wuyangtech/MIAT_C3X25/Docs/signaltap.pdf

CSIE MIAT Lab.

National Central University

# Simple SignalTapII Starter Guide

MIAT-C3X FPGA Development Board

# 浯陽科技有限公司

# Open SignalTapII

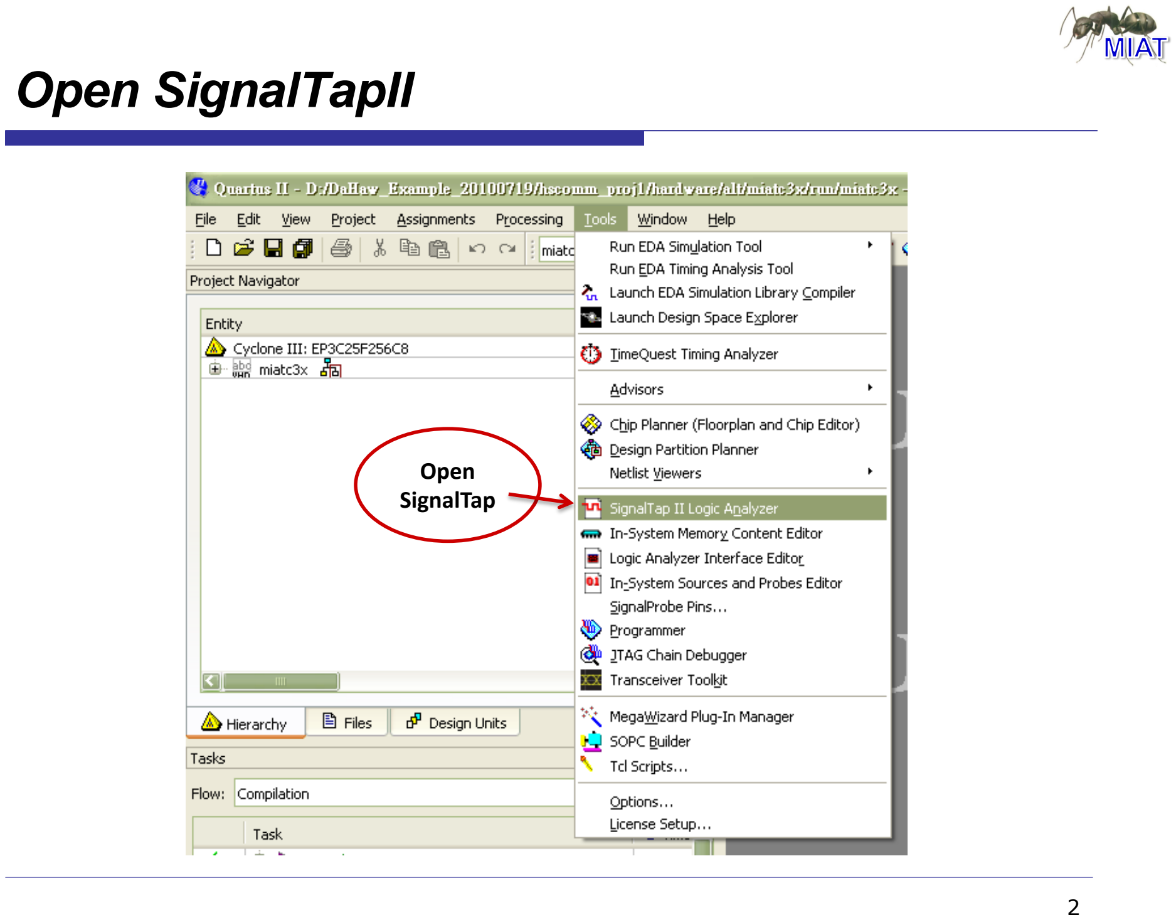
[picture p1: page 2]

Open
SignalTap

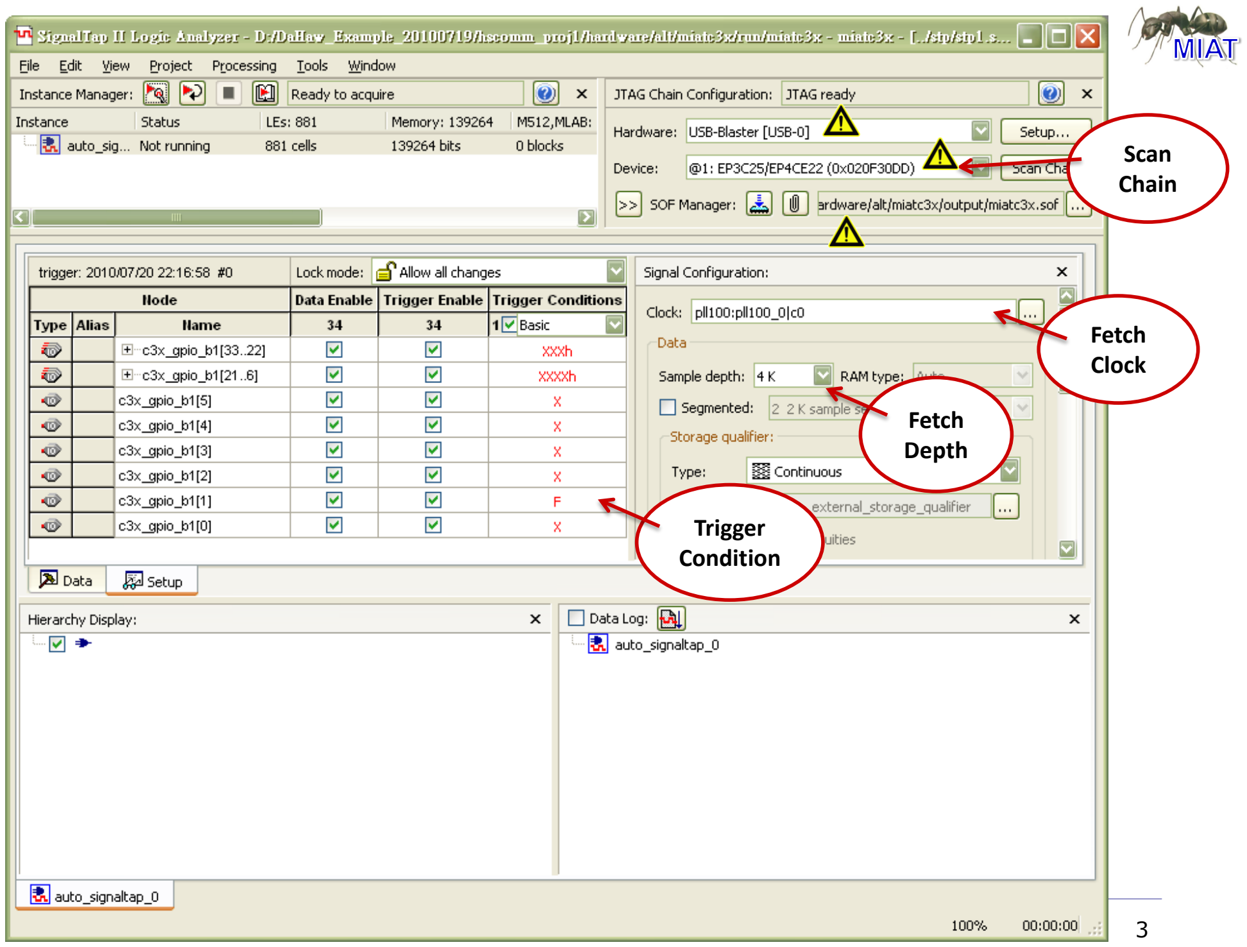
[picture p2: page 3]

Fetch
Clock

Fetch
Depth

Trigger
Condition

Scan
Chain

# Add Target Signals

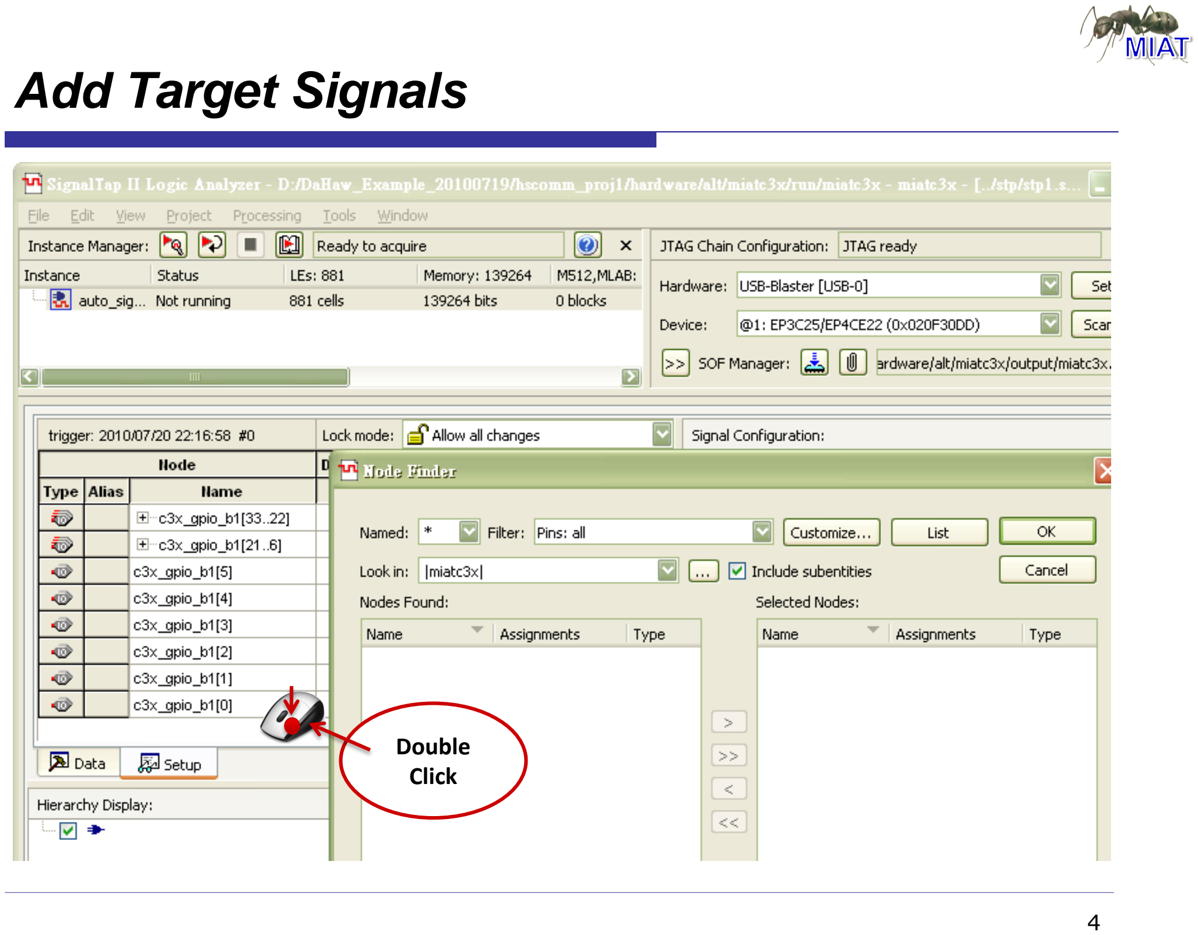
[picture p3: page 4]

Double
Click

# Note
