wuyangtech/MIAT_C3X25/Examples/HW_SW_Integration/shw_communication.pdf

CSIE MIAT Lab.

National Central University

# Day 5

# Hardware and Software Integration

MIAT-C3X FPGA Development Board

### 姚敦凱

965402013@cc.ncu.edu.tw

# 浯陽科技有限公司

# Outline

☐ | Part I
■ | High Efficiency Communication
☐ | Part II
■ | Software and Hardware Integration

# HIGH EFFICIENCY COMMUNICATION

## Part I

# Design Consideration

☐ | MIAT-STM32F103 communicate with MIAT-C3X
■ | Protocols
☐ | UART
☐ | I

2C
☐ | SPI
☐ | SDIO
☐ | GPIO
■ | FSMC Interface
☐ | (72Mhz*32-bit) / 11-Cycle
☐ | 209.45 Mbps

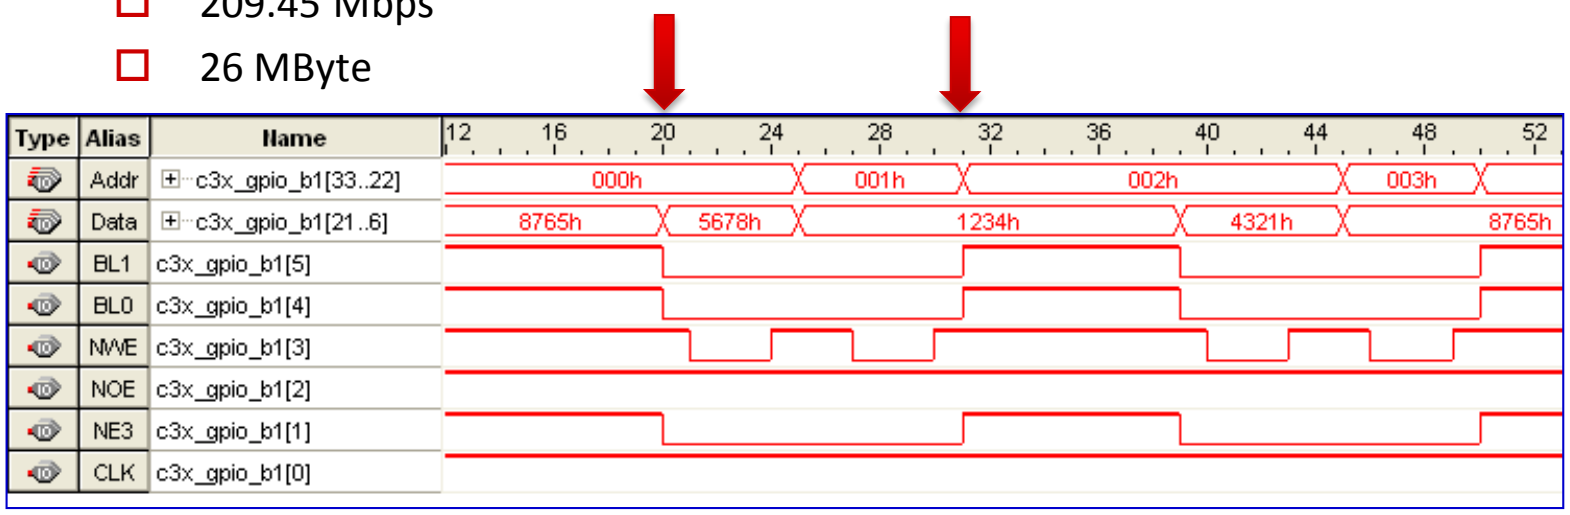
[picture p4: figure]
26 MByte

# FSMC Interface

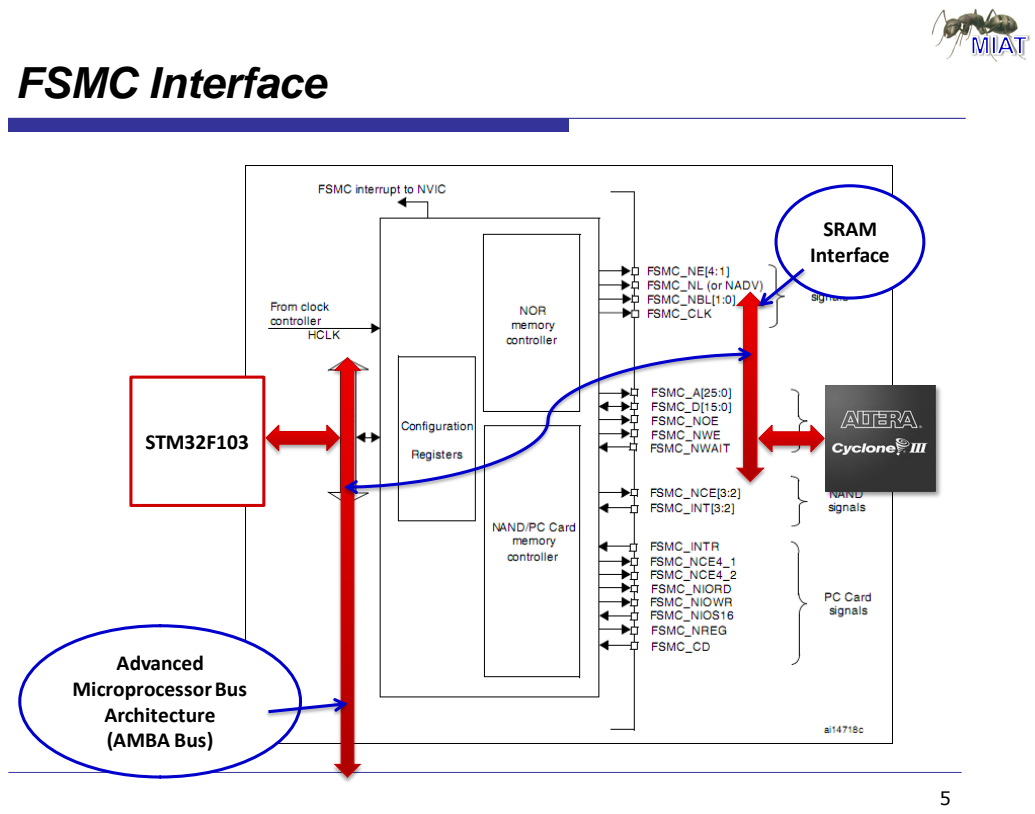
[picture p5: page 5]
STM32F103; Advanced Microprocessor Bus Architecture (AMBA Bus); SRAM Interface

# System Diagram

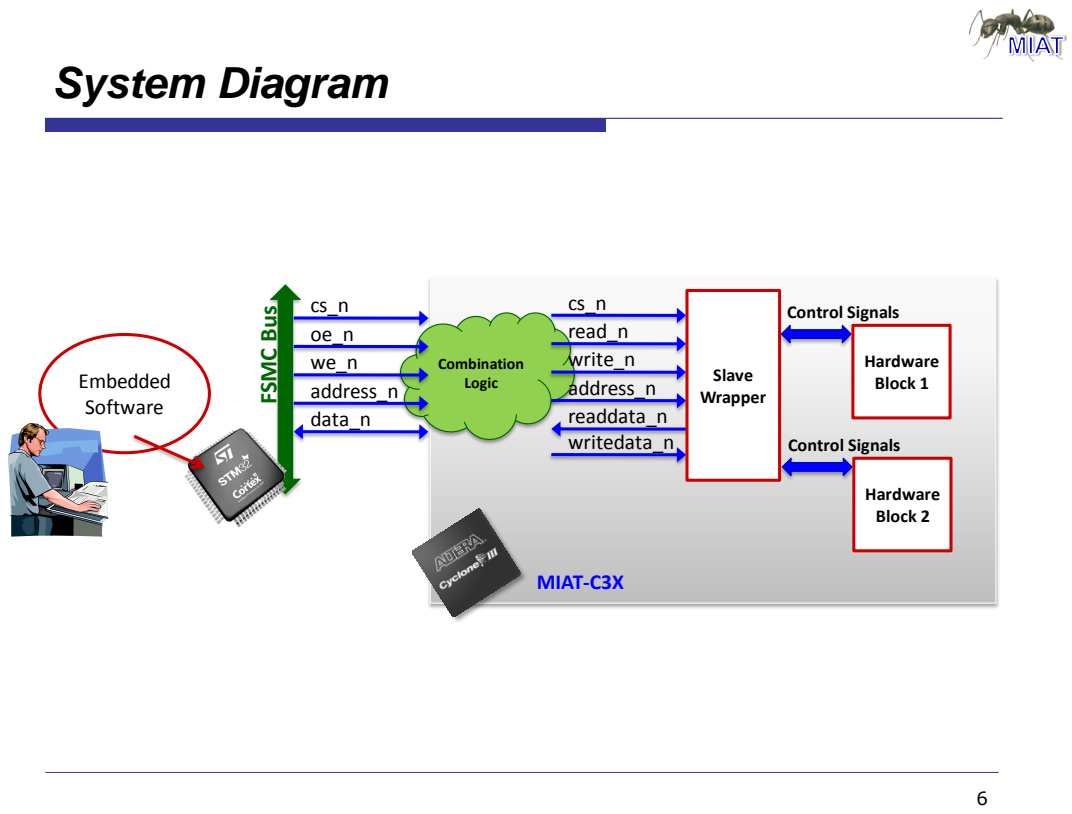
[picture p6: page 6]
Combination Logic; FSMC Bus; cs_n oe_n we_n address_n data_n; writedata_n; cs_n read_n write_n address_n readdata_n; Slave Wrapper; MIAT-C3X; Control Signals; Hardware Block 1; Hardware Block 2; Embedded Software

# Memory Mapping

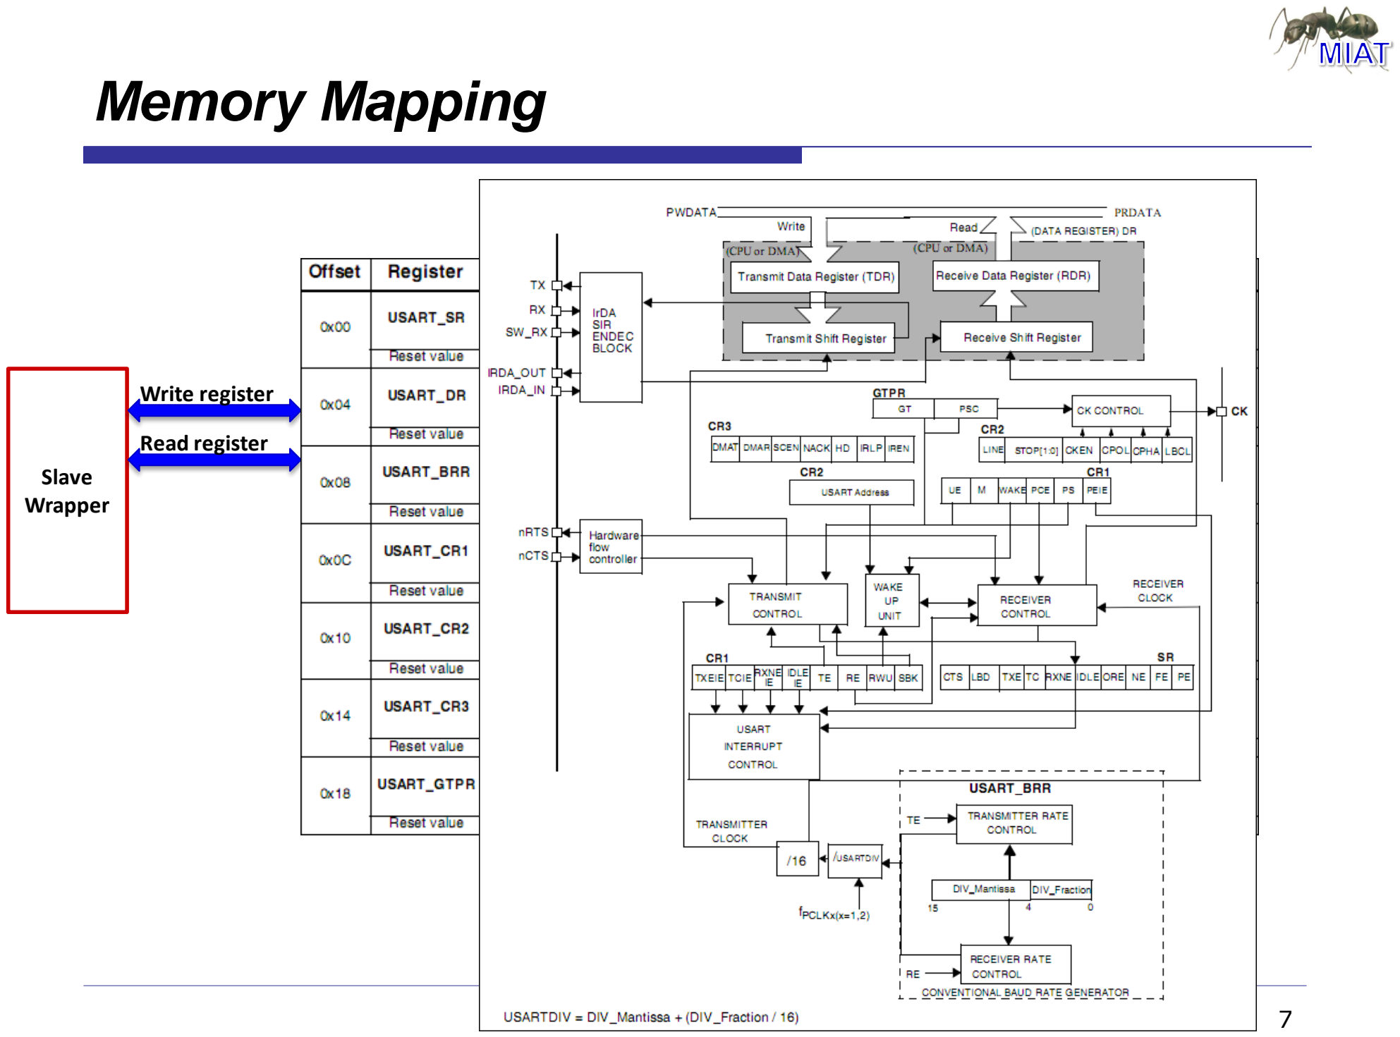
[picture p7: page 7]

Slave
Wrapper

Write register

Read register

# Lab 1. Register Access

☐ | MIAT-C3X Slave Wrapper address base
■ | 0x68000000

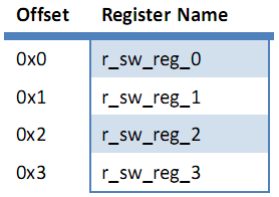
[picture p8: figure]

☐ | Try to read and write them

# Lab 1. Connect 1 of 2

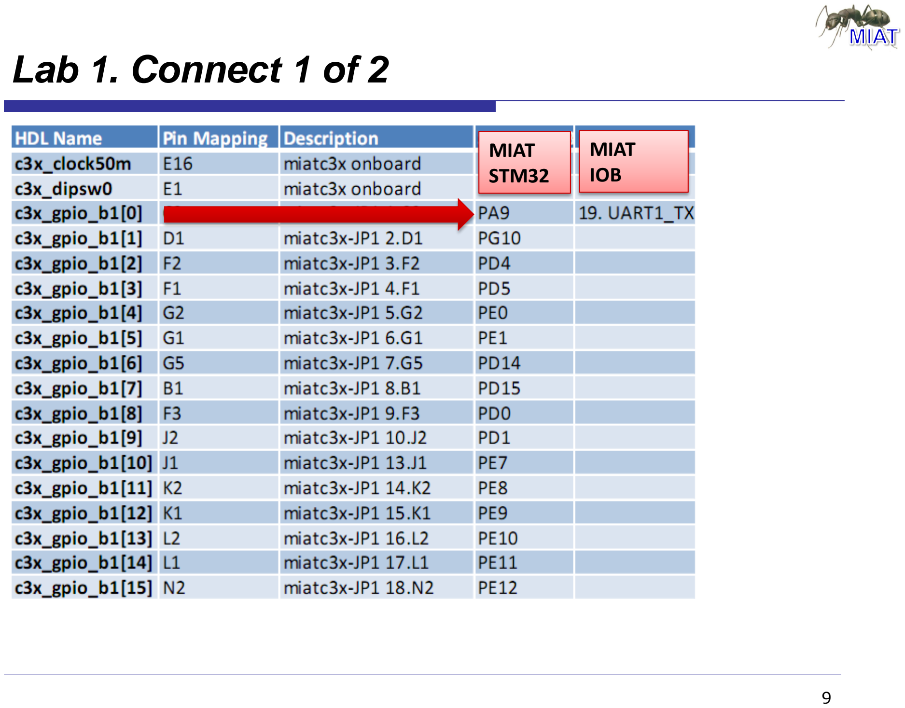
[picture p9: page 9]

MIAT
STM32

MIAT
IOB

# Lab 1. Connect 2 of 2

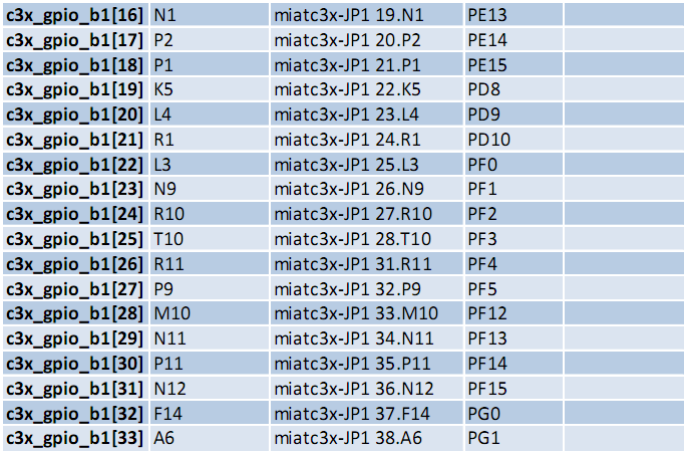
[picture p10: figure]

# Lab 1. MIAT-STM32 Connector

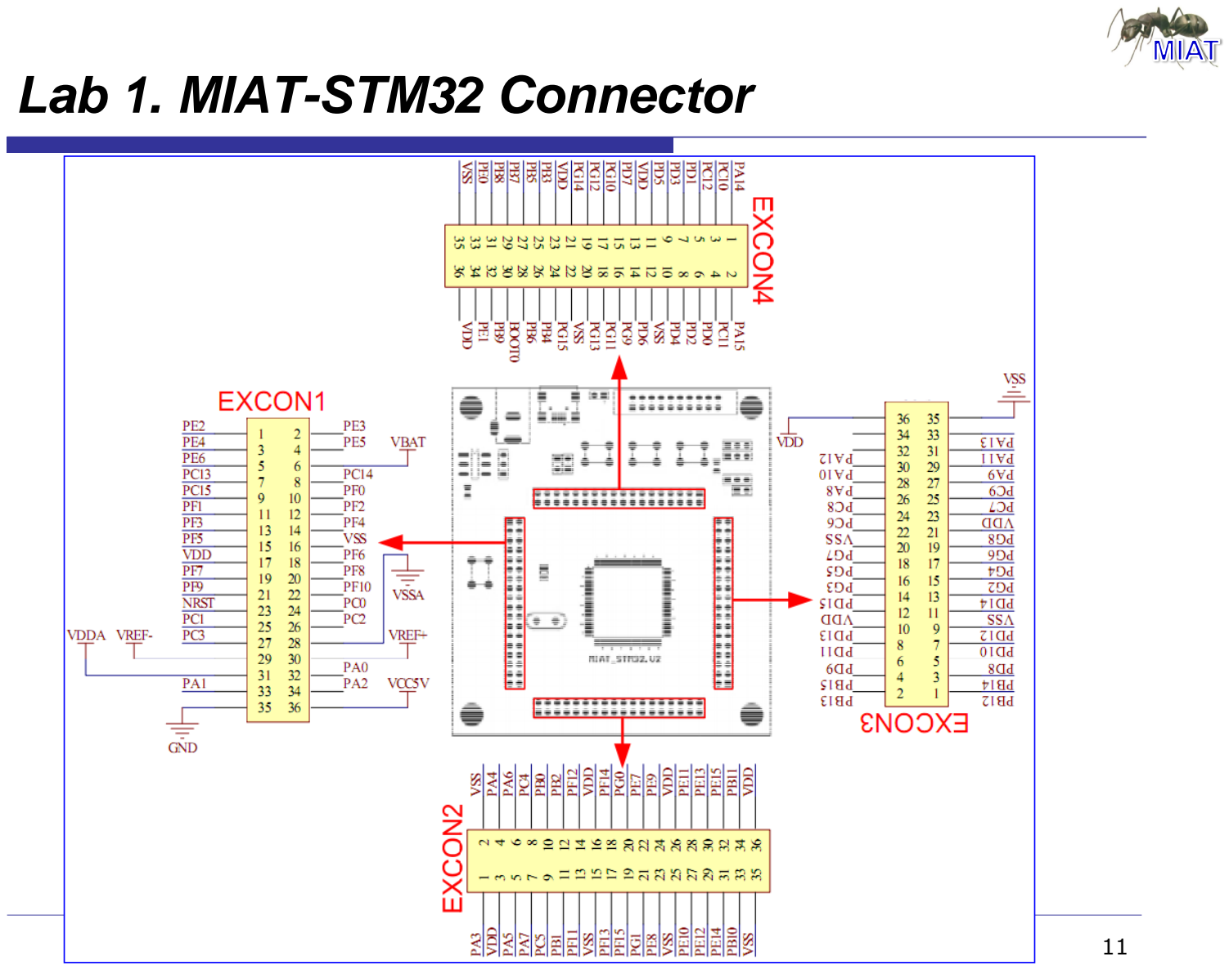
[picture p11: page 11]

# Lab 1. Software Flow

## ☐ Use pointer to operate

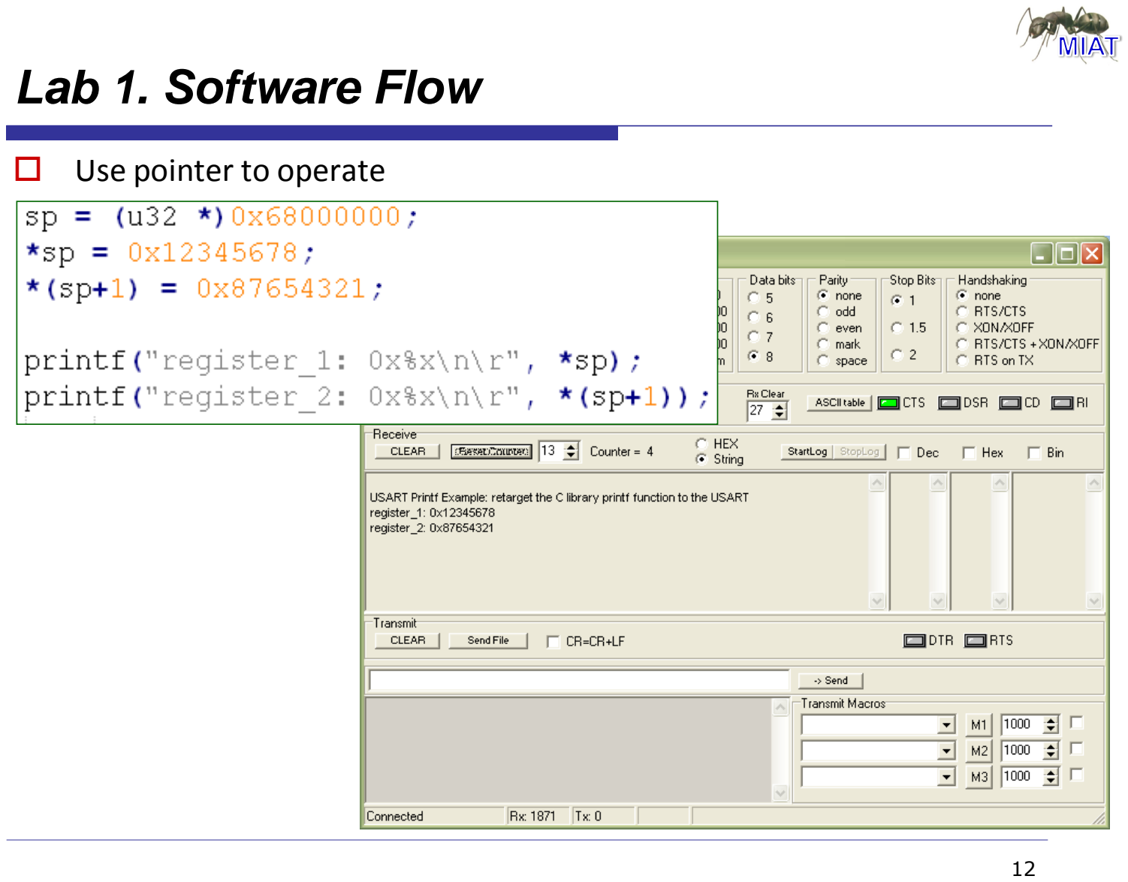
[picture p12: page 12]

# Lab 1. Access Hardware

## ☐ Hardware Waveform

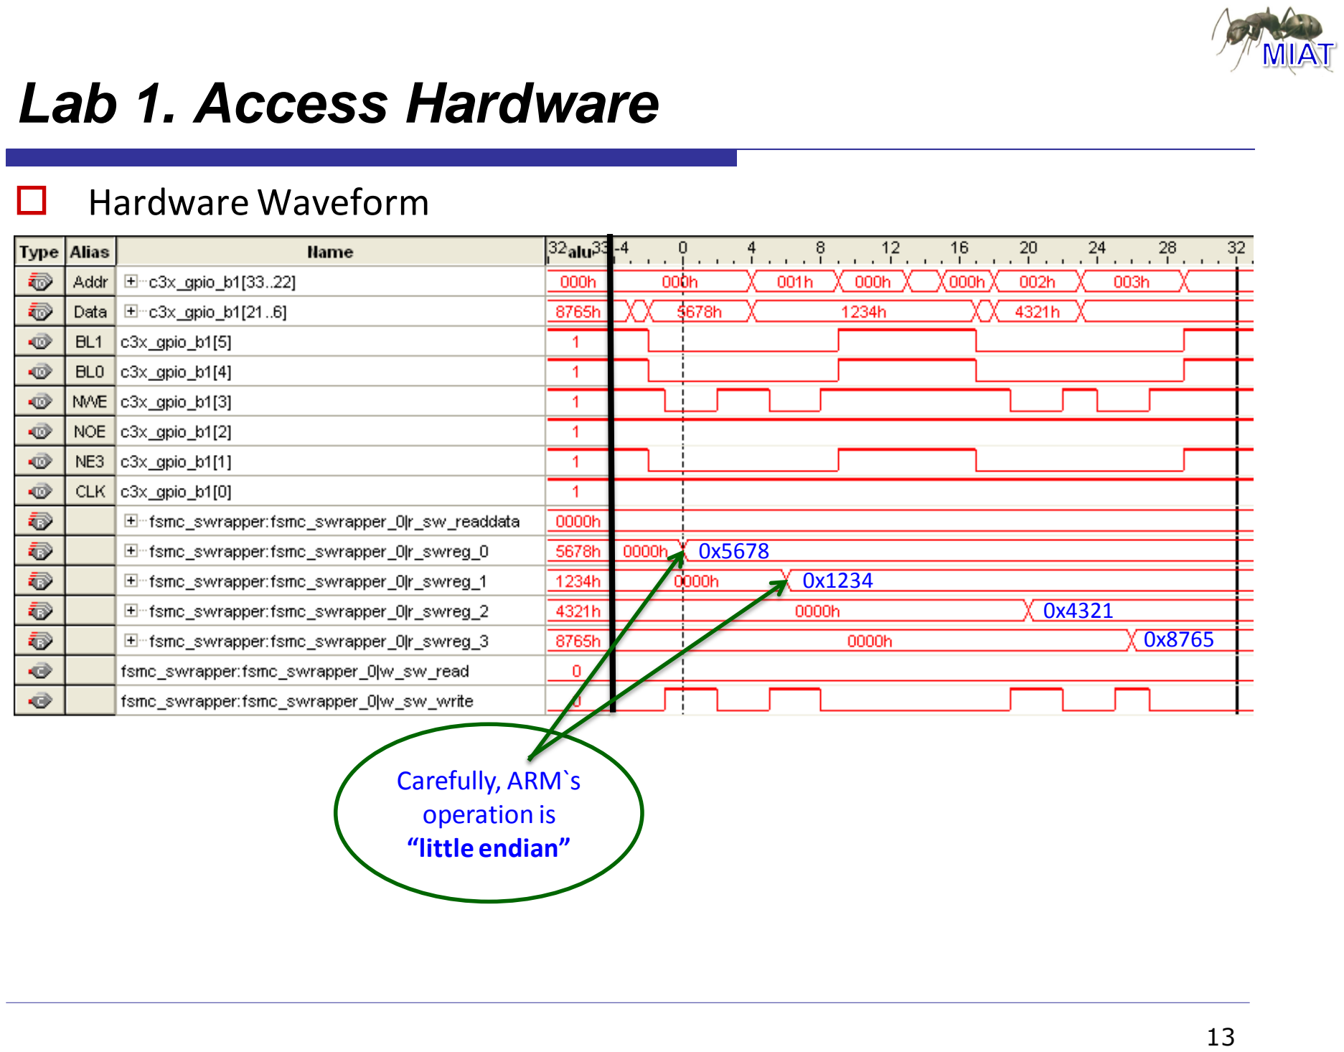
[picture p13: page 13]

0x5678
0x1234
0x4321
0x8765

Carefully, ARM`s
operation is
“little endian”

# SOFTWARE & HARDWARE INTEGRATION

## Part II

# Lab 2. Counter

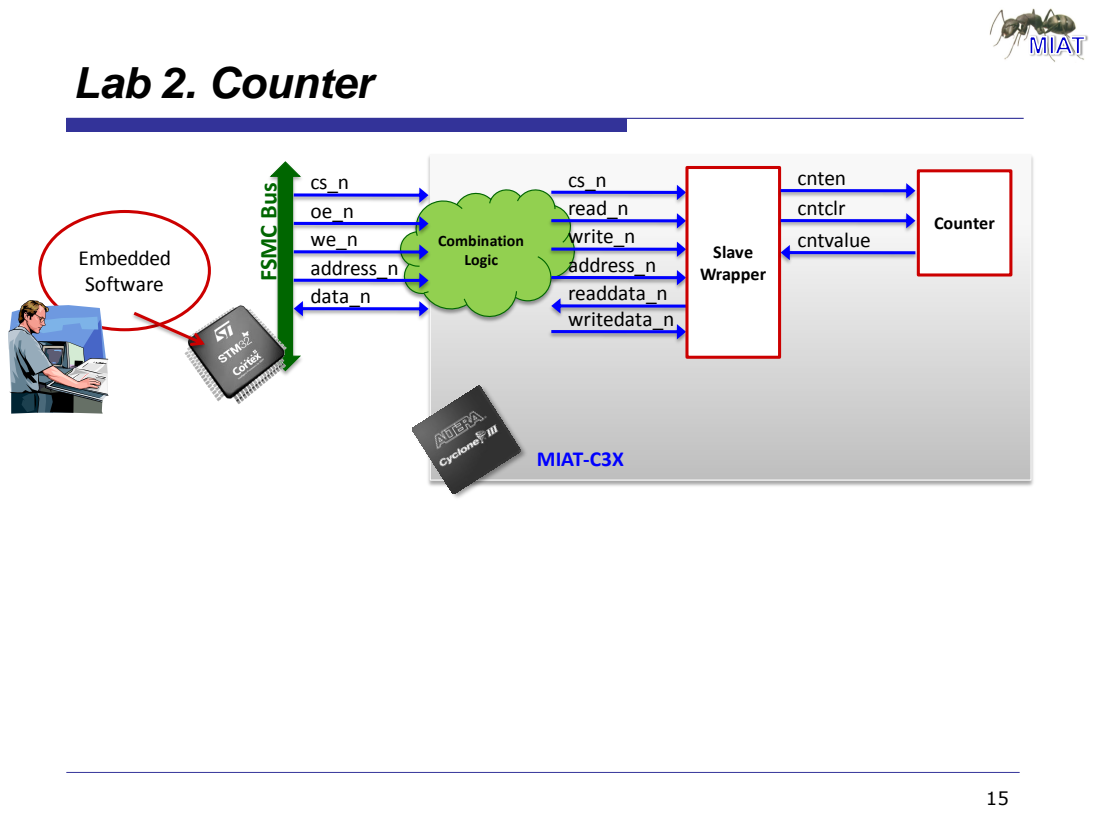
[picture p14: page 15]
Combination Logic; FSMC Bus; cs_n oe_n we_n address_n data_n; writedata_n; cs_n read_n write_n address_n readdata_n; Slave Wrapper; MIAT-C3X; Embedded Software; cnten cntclr cntvalue; Counter

# Lab 2. Software Architecture

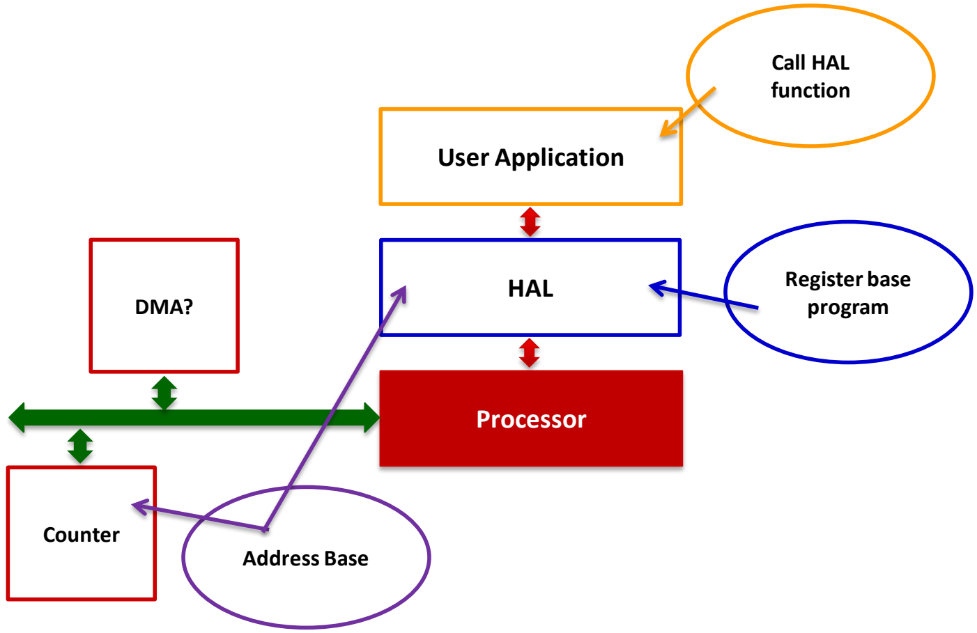
[picture p15: figure]
User Application; HAL; Processor; Register base program; Call HAL function; Counter; DMA?; Address Base

# Lab 2. Register Table

☐ | MIAT-C3X Counter Slave Wrapper address base
■ | 0x68000000

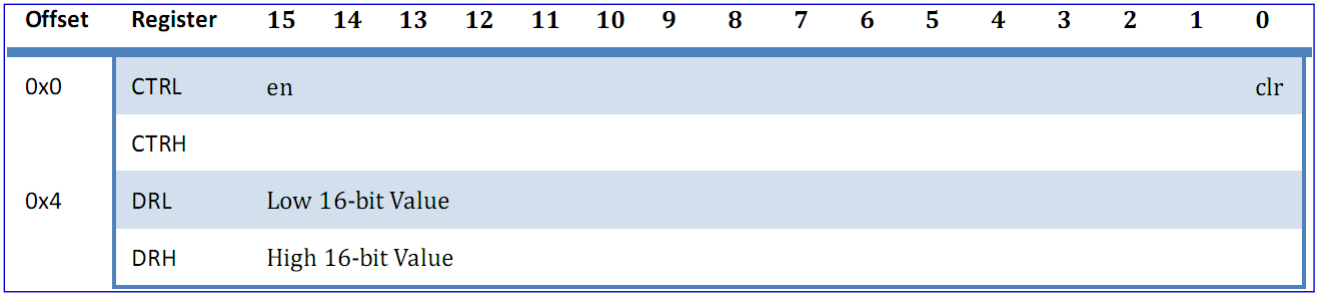
[picture p16: figure]

# Lab 2. Software Flow

## ☐ Call HAL Function

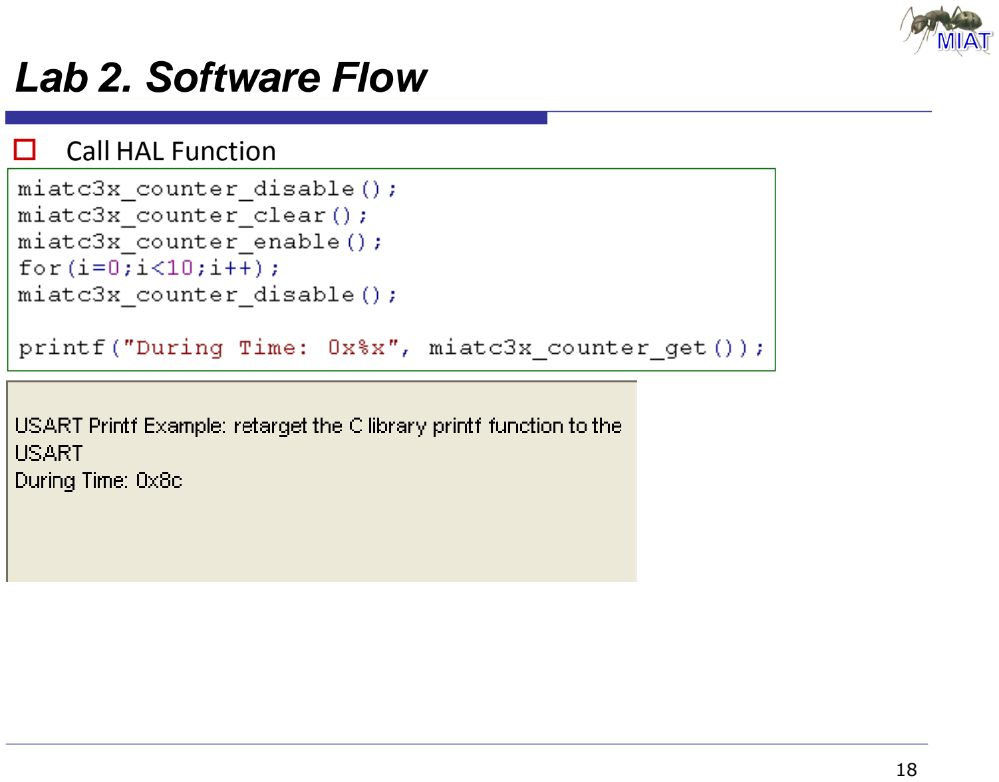
[picture p17: page 18]

# Lab 2. Access Hardware

## ☐ Waveform

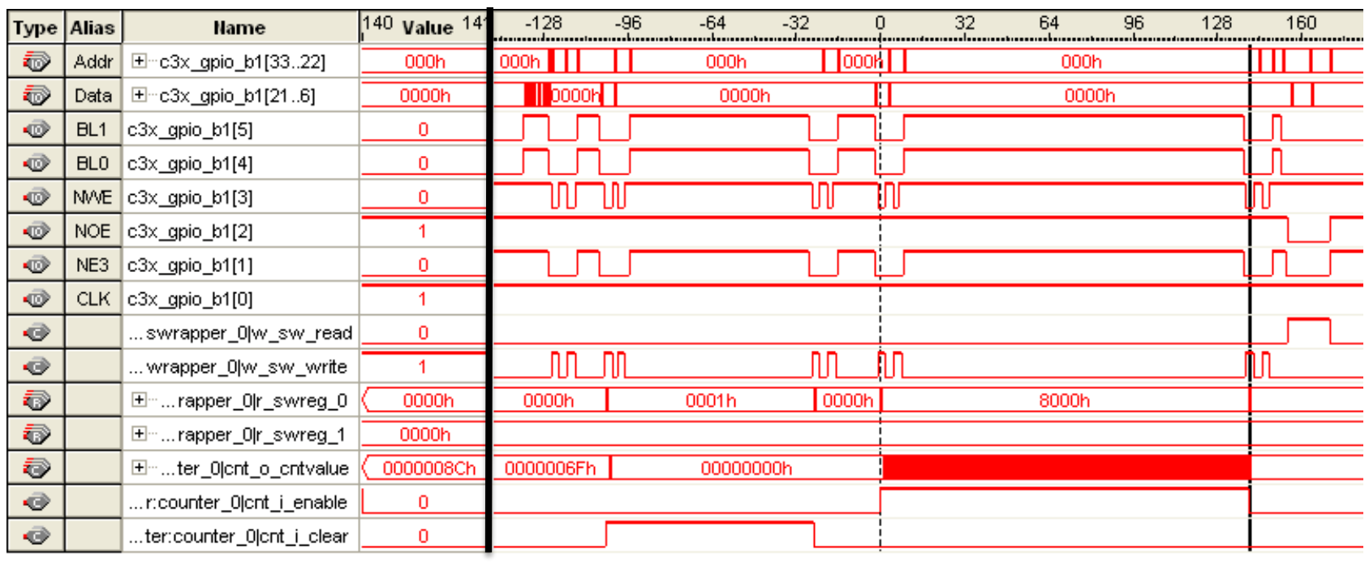
[picture p18: figure]

# Lab 3. YCbCr Accelerator

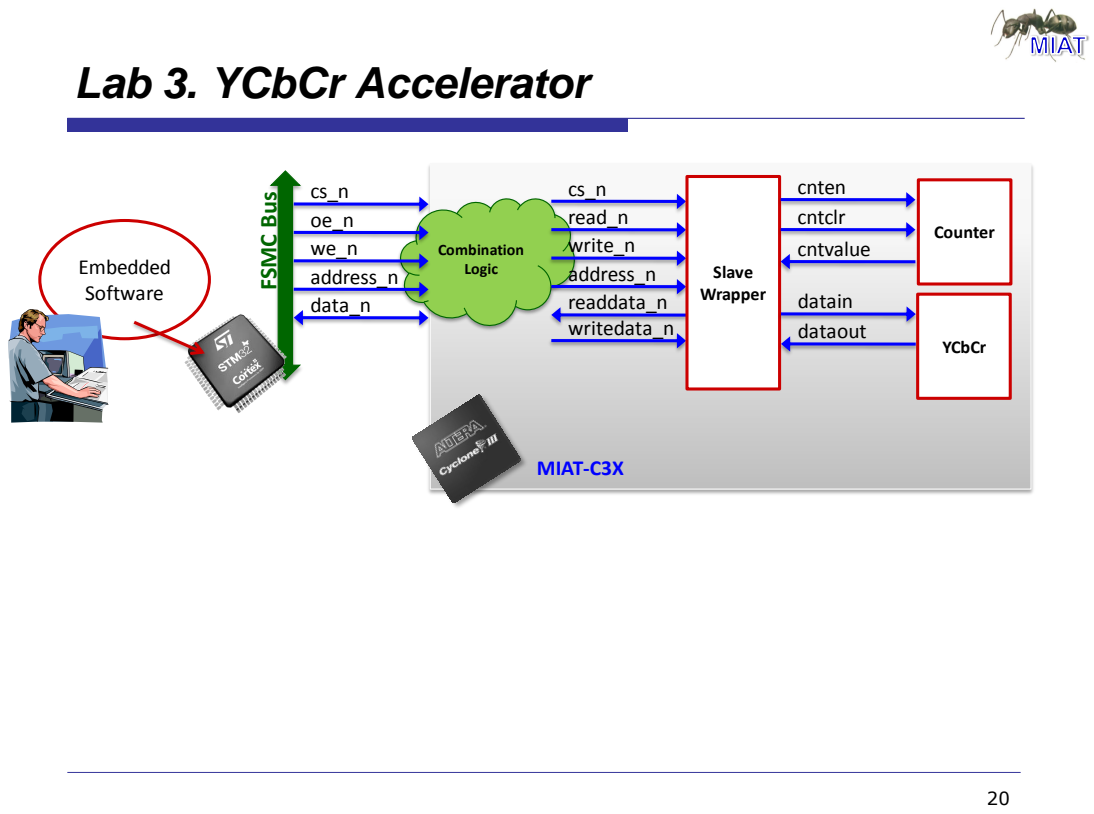
[picture p19: page 20]
Combination Logic; FSMC Bus; cs_n oe_n we_n address_n data_n; writedata_n; cs_n read_n write_n address_n readdata_n; Slave Wrapper; MIAT-C3X; Embedded Software; cnten cntclr cntvalue; Counter; datain dataout; YCbCr

# Lab 3. Register Table

☐ | MIAT-C3X Counter Slave Wrapper address base
■ | 0x68000008

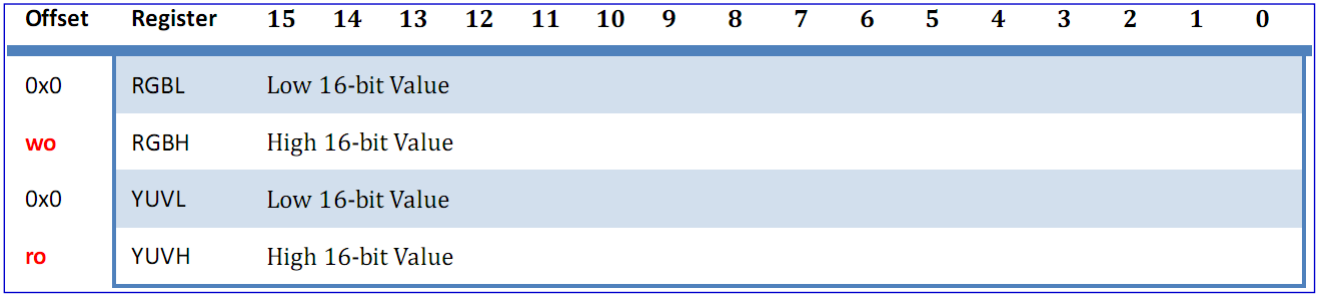
[picture p20: figure]

# Lab 3. Compare

☐ | ARM Cortex-M3
■ | Optimized Fixed Point Compiler
☐ | Hardware

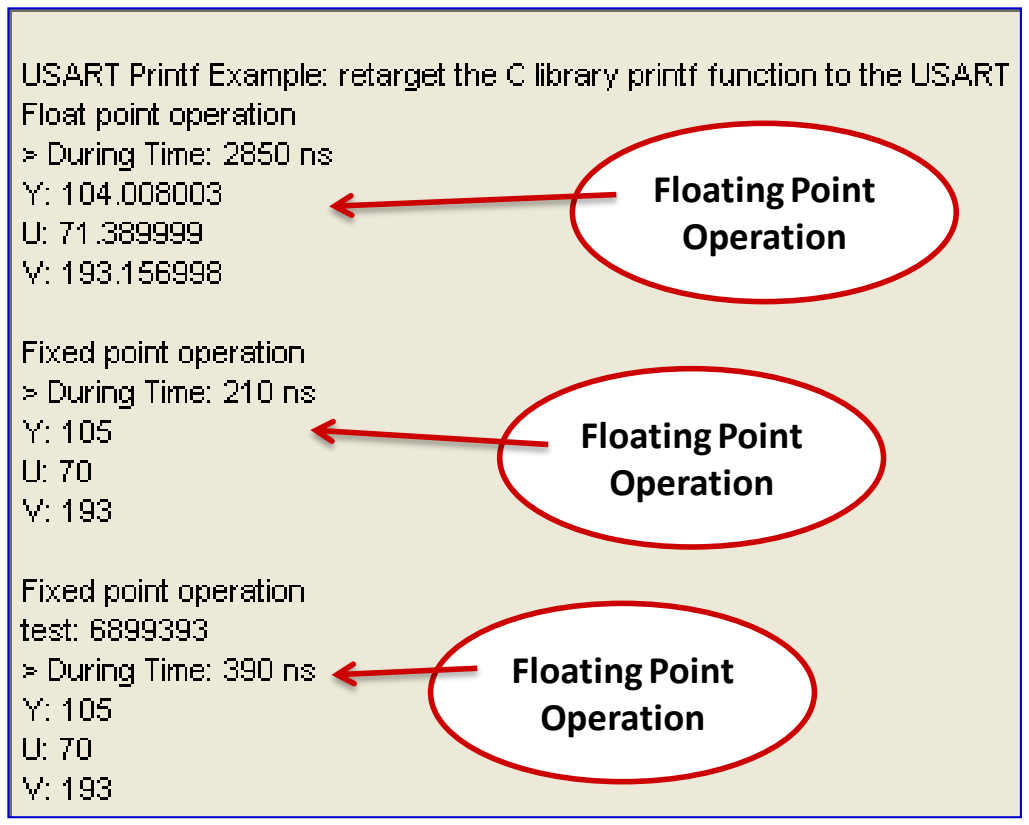
[picture p21: figure]
Floating Point Operation

■ | Pipeline
■ | Fifo buffer

# Lab 3. Disadvantage

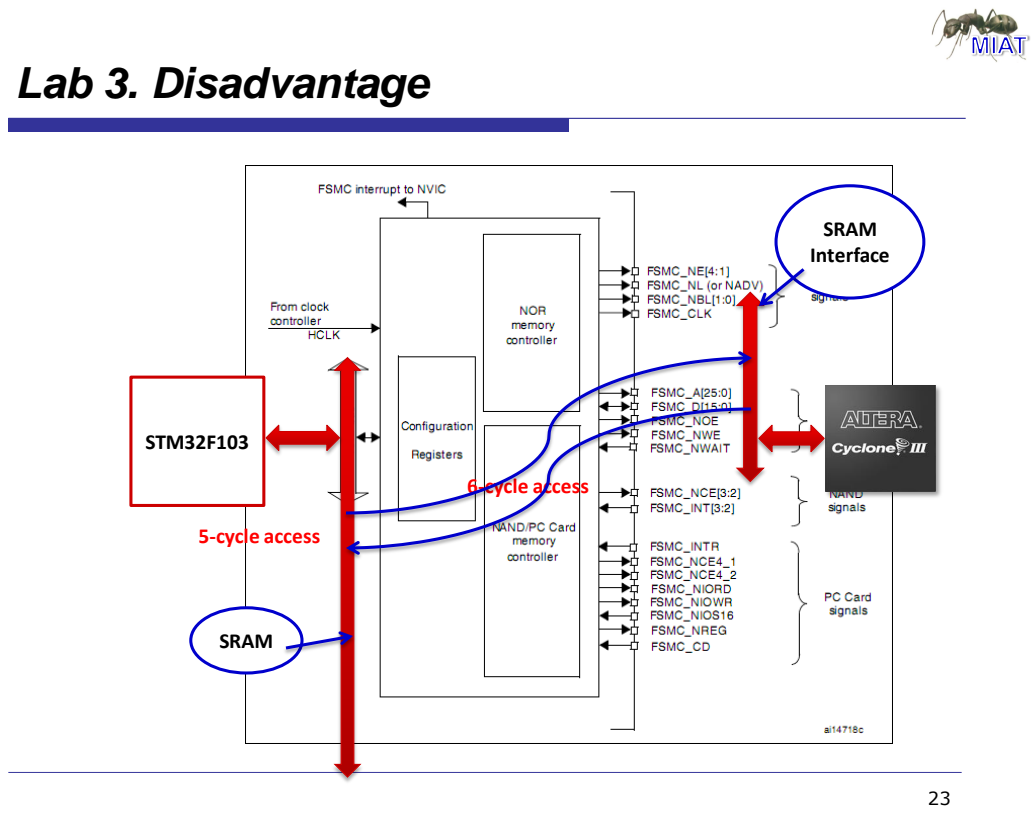
[picture p22: page 23]
STM32F103; SRAM; SRAM Interface; 6-cycle access; 5-cycle access

# Lab 3. Hardware Operation

## ☐ Waveform

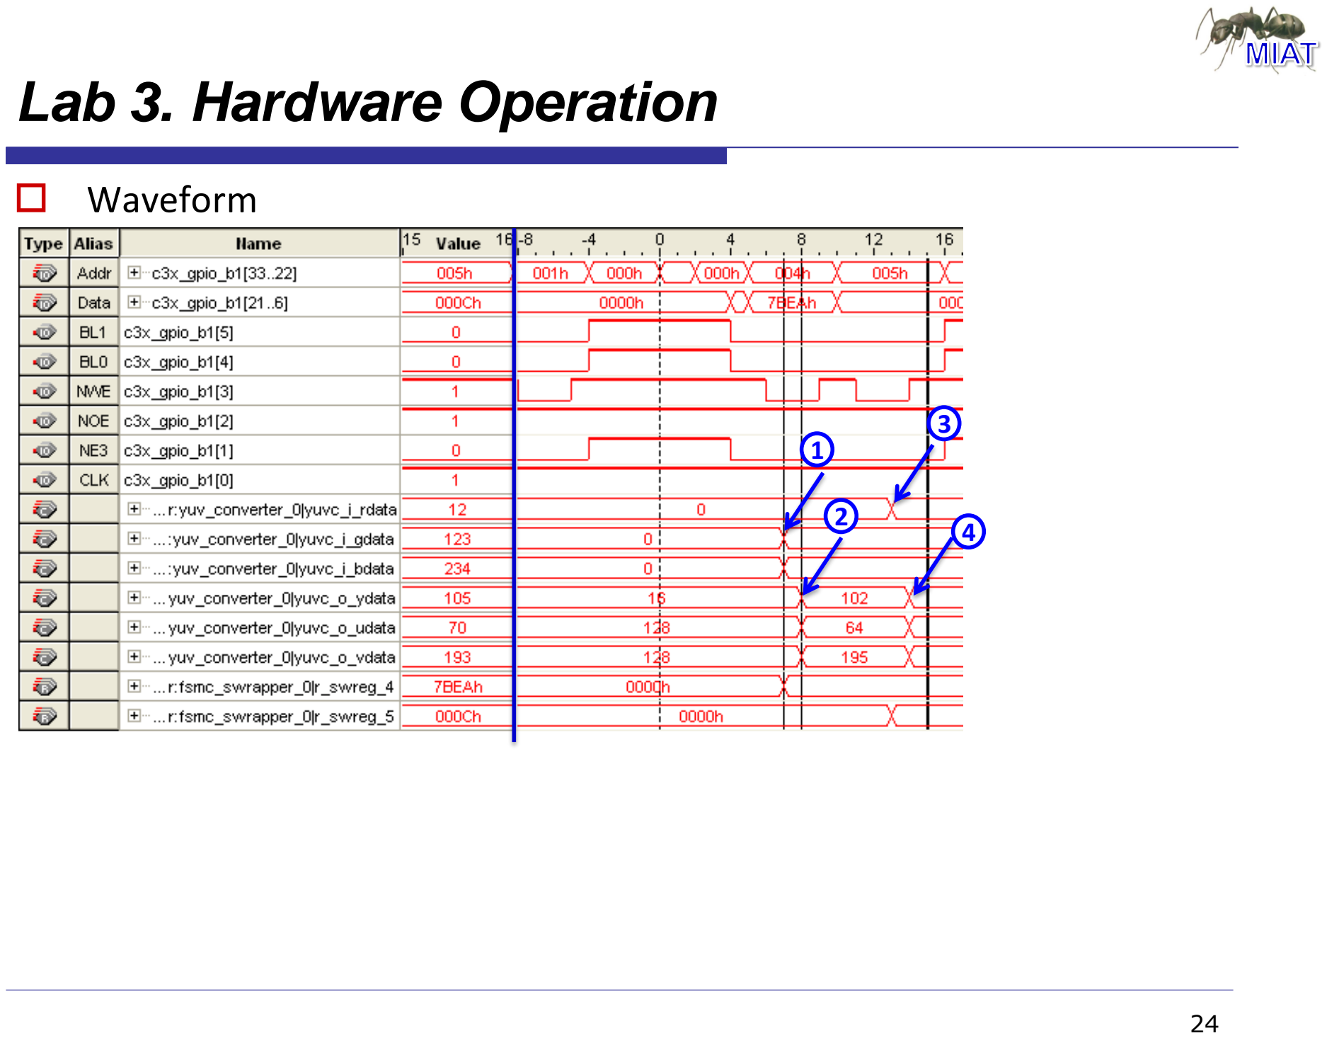
[picture p23: page 24]

2

1

3

4

# Lab 4. UART Transmitter

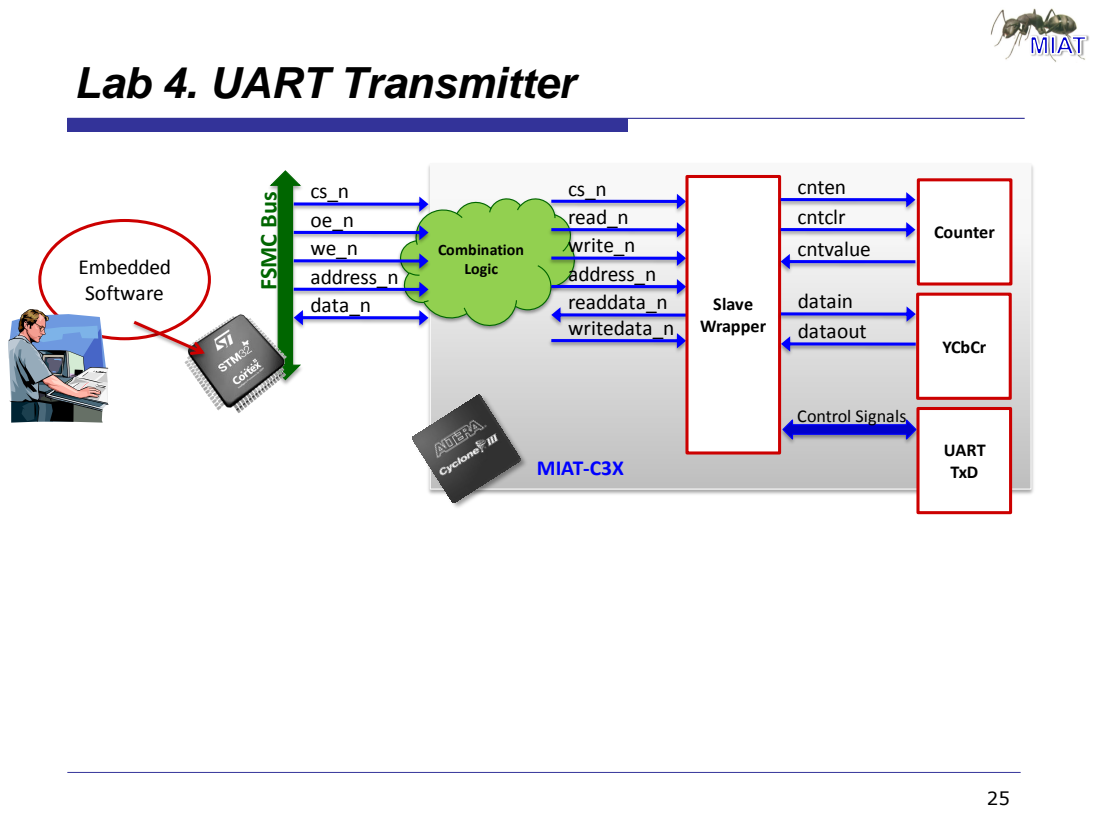
[picture p24: page 25]
Combination Logic; FSMC Bus; cs_n oe_n we_n address_n data_n; writedata_n; cs_n read_n write_n address_n; readdata_n; Slave; Wrapper; MIAT-C3X; Embedded Software; cnten cntclr cntvalue; Counter; datain dataout; YCbCr; UART TxD; Control Signals

# Lab 4. Connect 1 of 2

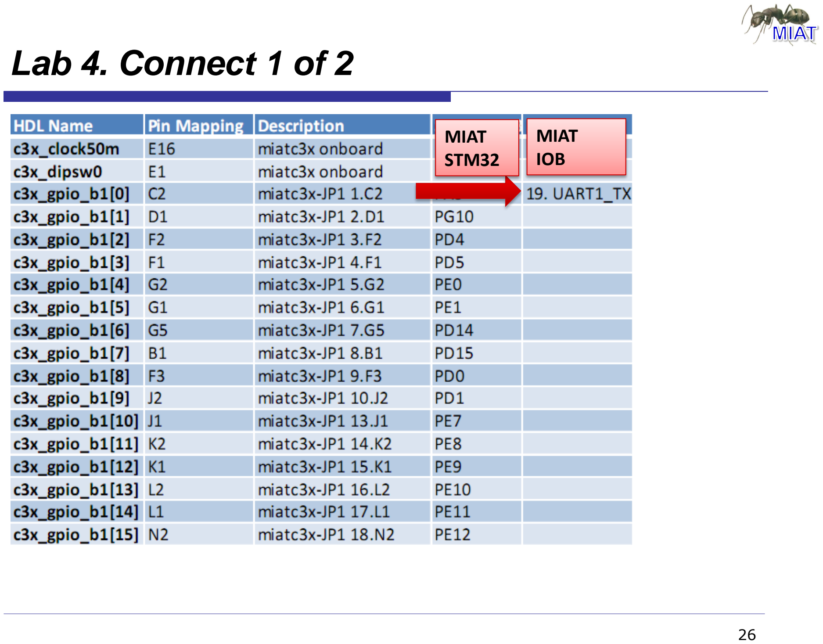
[picture p25: page 26]

MIAT
STM32

MIAT
IOB

# Lab 4. Connect 2 of 2

# Lab 1. MIAT-STM32 Connector

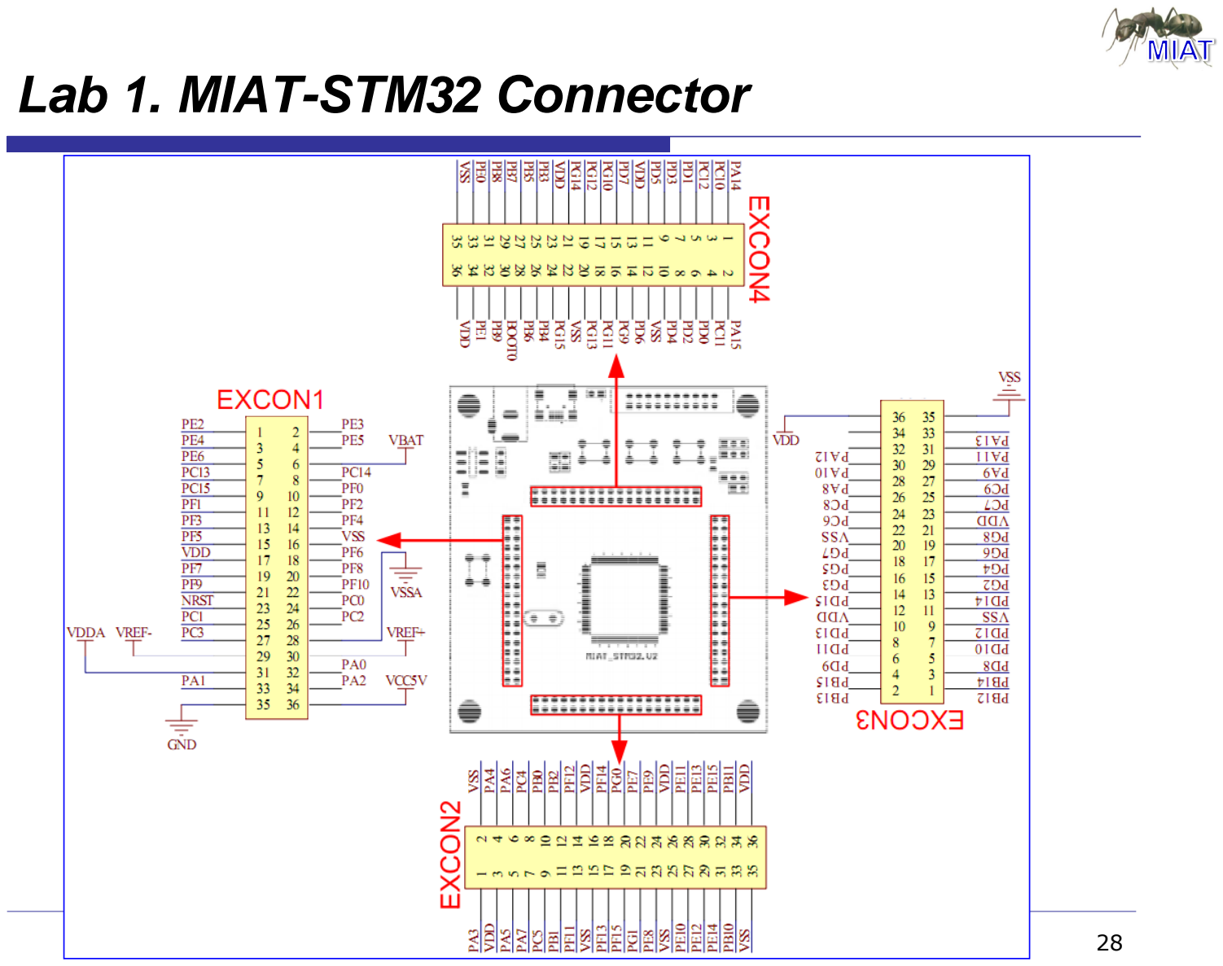
[picture p26: page 28]

# Lab 4. Replace STM32F103 UART

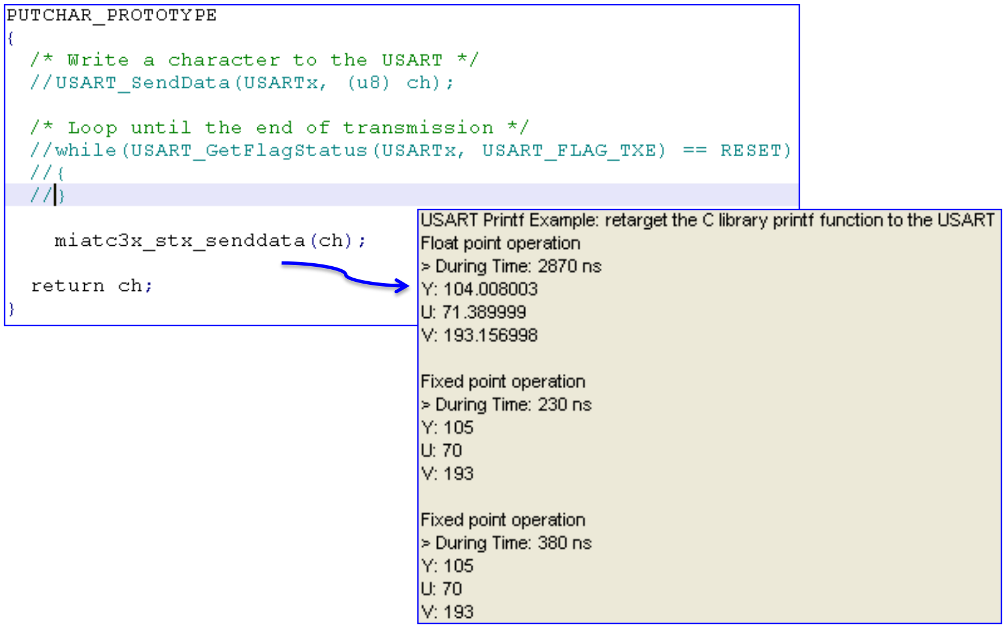
[picture p27: figure]

# Note

☐ | 講義與範例
■ | Day3 & Day5
■ | http://www.csie.ncu.edu.tw/~tkyao/tahwa201007/
☐ | 軟體
■ | Altera QuartusII
■ | Altera ModelSim
■ | Keil RVMDK
