wuyangtech/MIAT_C3X25/Examples/UART/hw_communication.pdf

CSIE MIAT Lab.

National Central University

## Communication

MIAT-C3X FPGA Development Board

### 浯陽科技有限公司

Outline ☐ | Part I ■ | Design Consideration ■ | Buadrate Generator ■ | Transmitter ☐ | Part II ■ | Receiver ☐ | Part III ■ | Time for Questions ☐ | Part IV ■ | Project Architecture ■ | QuartusII Setting

# UART TRANSMITTER DESIGN

Part – I

## Transmitter – UART Communication Protocol

☐ | UART Transmitter Protocol - Waveform

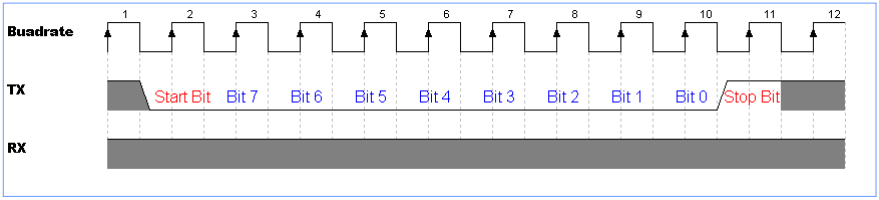
[picture p28: figure]

☐ | Transmit form the last bit of the byte
■ | 0x55(010101012
)

## Transmitter – Design Consideration

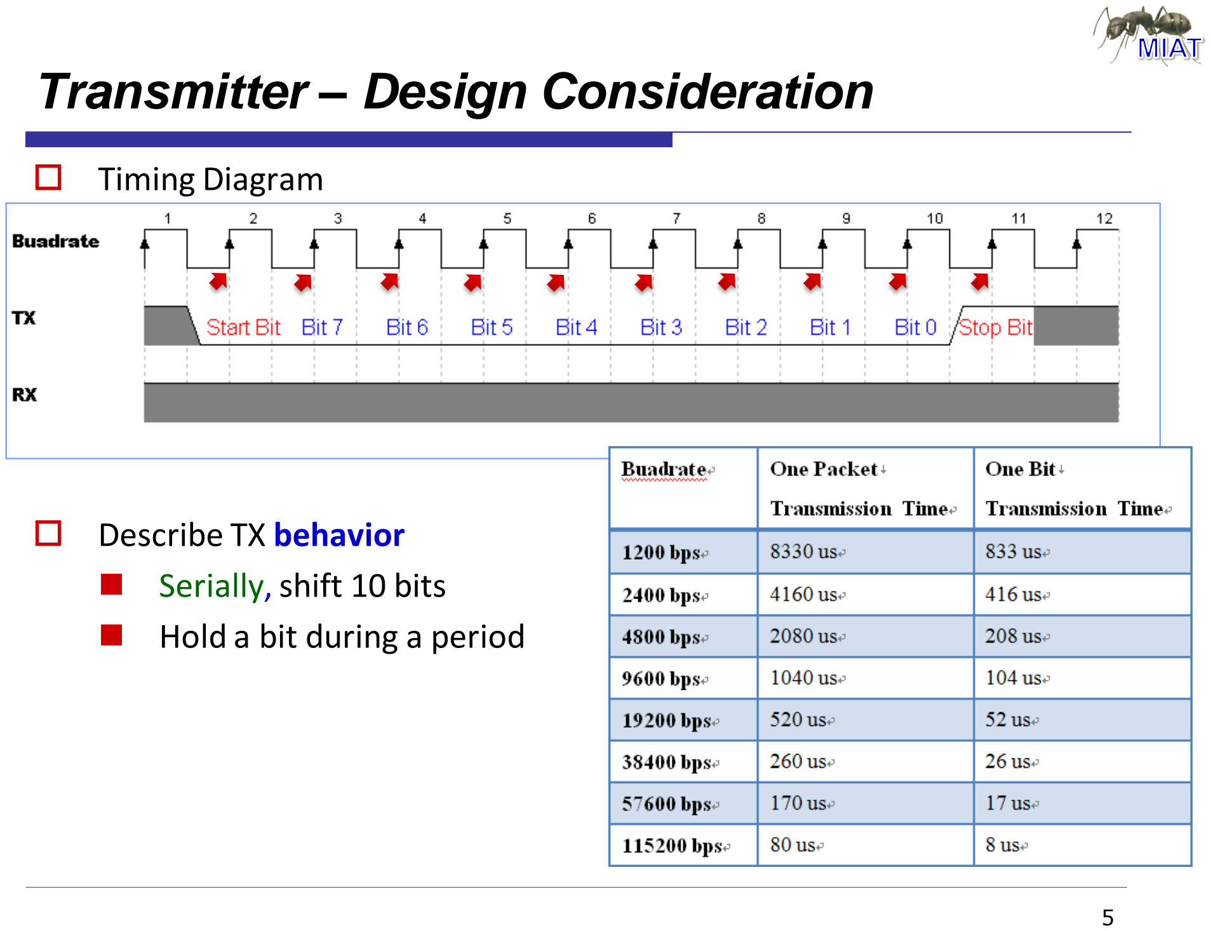
[picture p29: page 5]

☐ | Timing Diagram
☐ | Describe TX behavior
■ | Serially, shift 10 bits
■ | Hold a bit during a period

## Transmitter – Design Entity

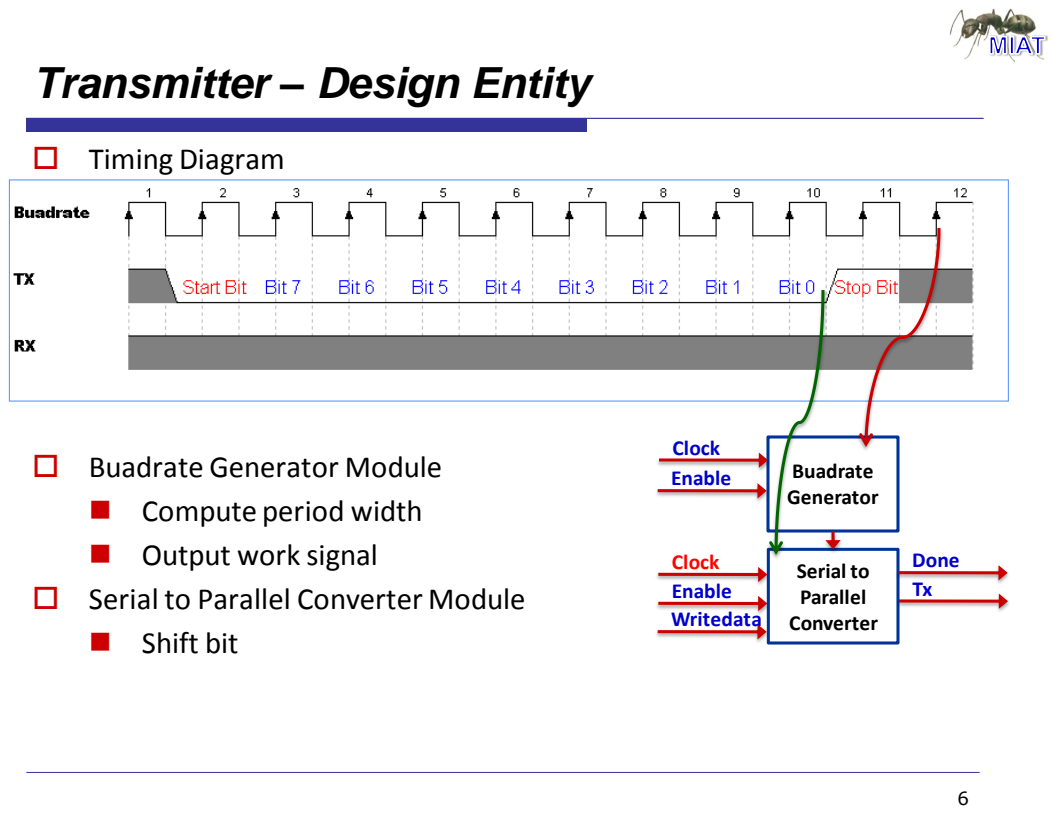
[picture p30: page 6]
Timing Diagram; Buadrate Generator Module; Compute period width; Output work signal; Serial to Parallel Converter Module; Shift bit; Buadrate Generator; Serial to Parallel Converter; Clock; Clock Enable; Done Tx; Enable; Writedata

## Buadrate Gen. – Design Entity

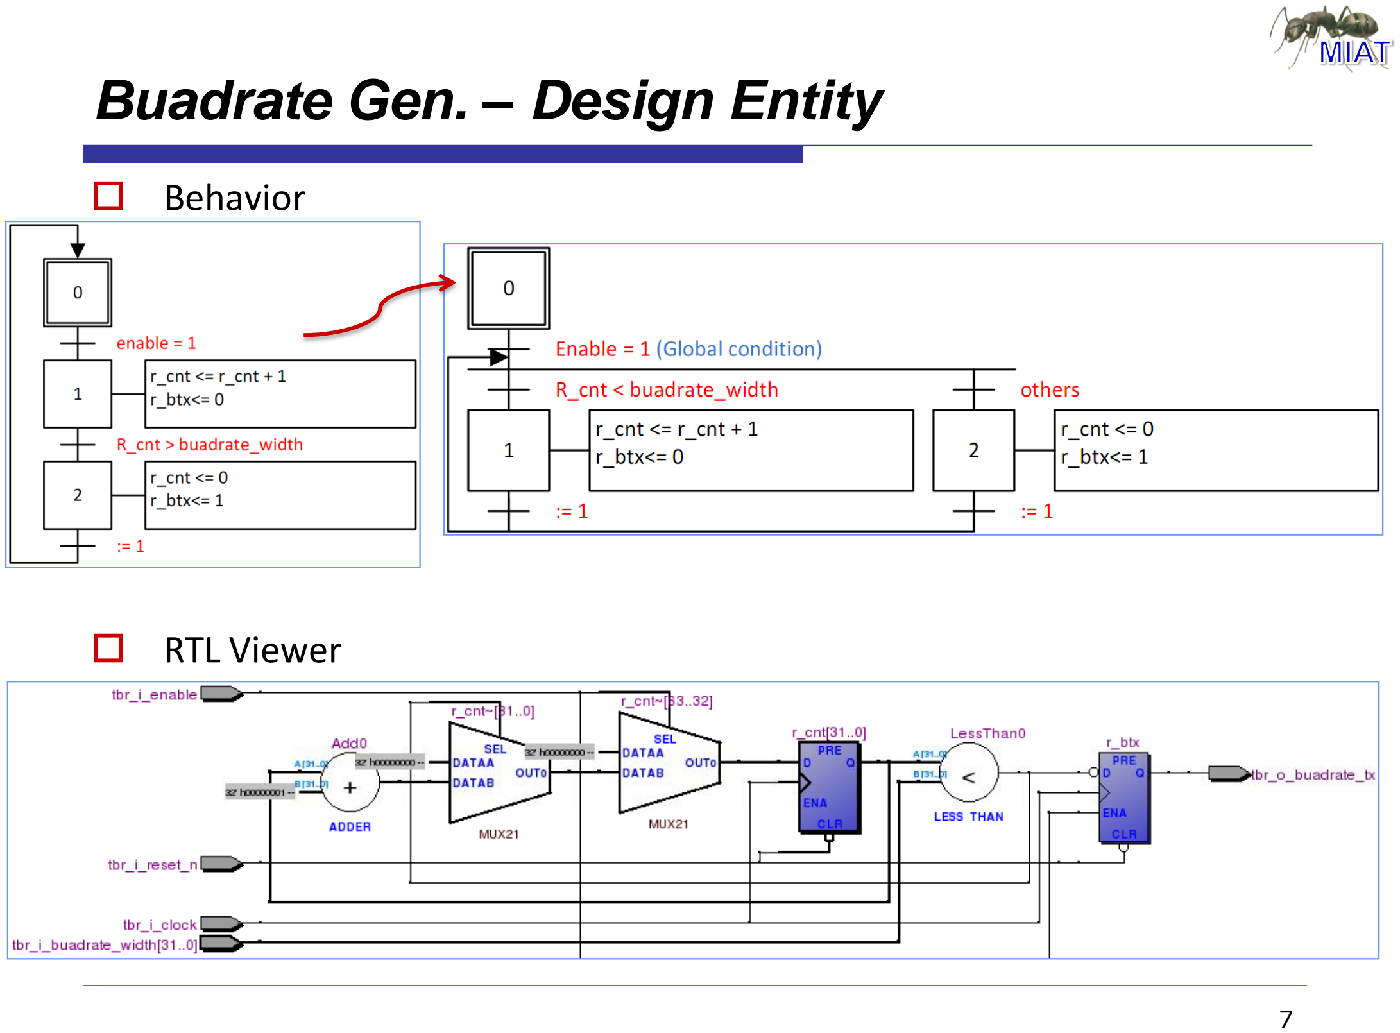
[picture p31: page 7]

☐ | Behavior
☐ | RTL Viewer

## Exercise I – Buadrate Generator

☐ | Design a Buadrate Generator Module
■ | Generate a reference signal can be programmed period
☐ | Simulate Result

[Project Name] /uart_divider1

Exercise I – Buadrate Generator, Cont.

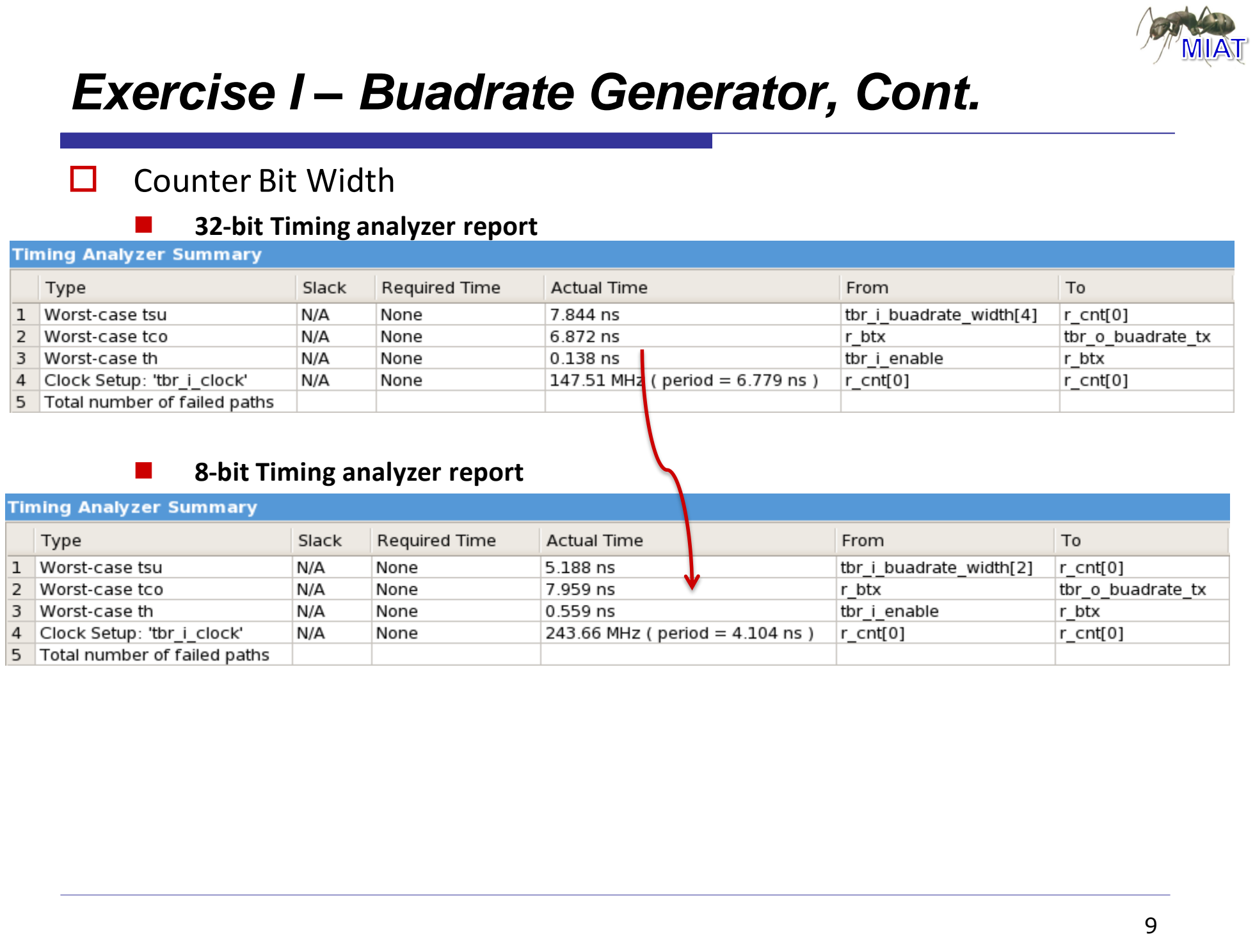
[picture p32: page 9]

☐ | Counter Bit Width
■ | 32-bit Timing analyzer report
■ | 8-bit Timing analyzer report

## PS Converter – Design Entity

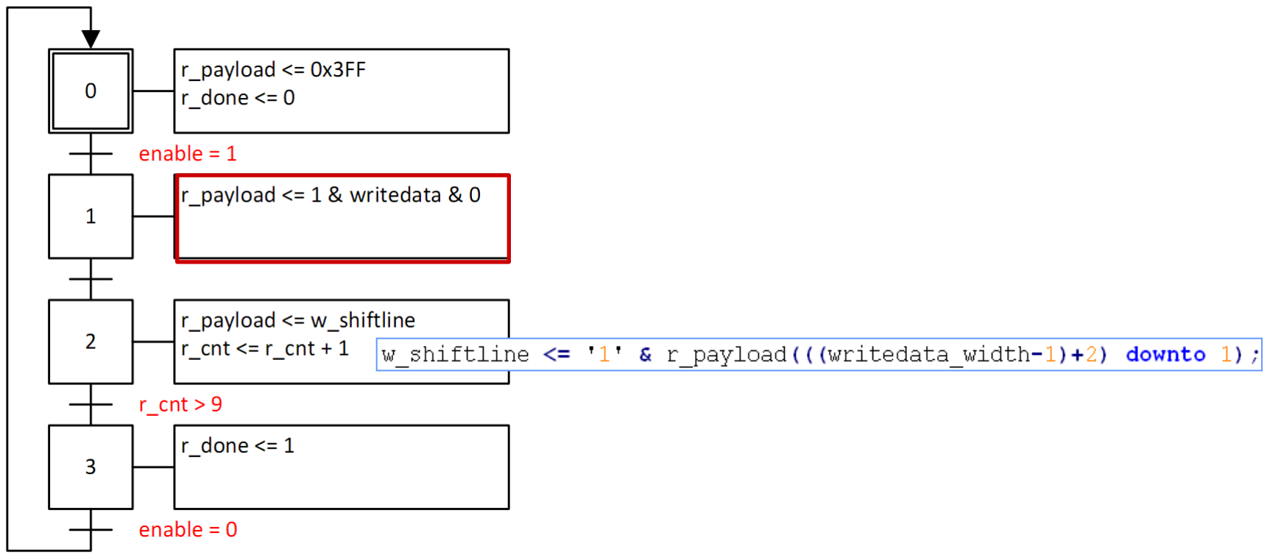
[picture p33: figure]

☐ Behavior

## PS Converter – Synthesis Report

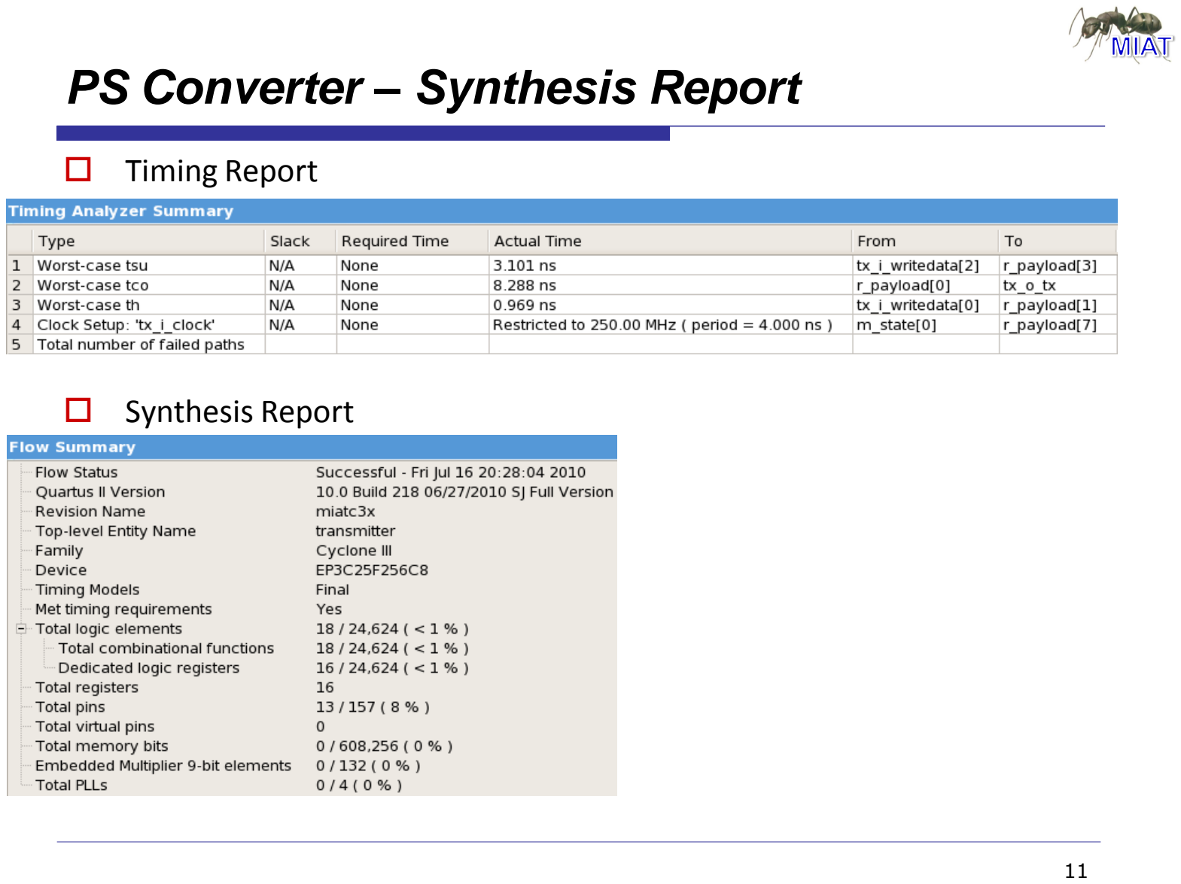
[picture p34: page 11]

☐ | Timing Report
☐ | Synthesis Report

## Exercise II – PS Converter

☐ | Design a Parallel to Serial Converter
■ | A shift controller
☐ | Simulate

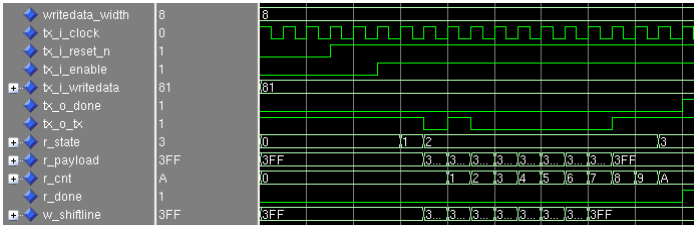
[picture p35: figure]

[Project Name] /uart_divider2

## Exercise III – Serial Transmitter

☐ | Integrate Modules
■ | Buadrate Generator
■ | Parallel to Serial Converter
■ | Use the reference signal to trigger the PX Converter

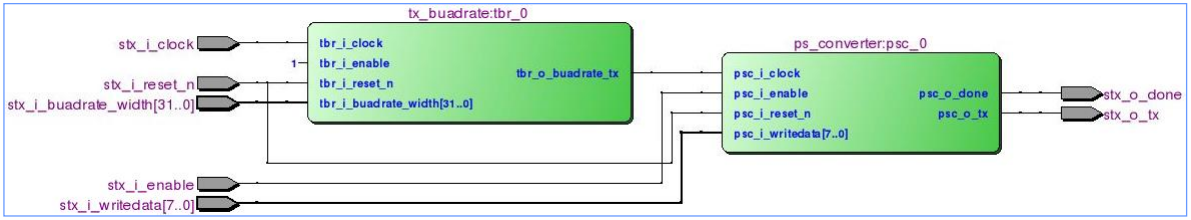
[picture p36: figure]

[Project Name] /uart_divider2

## Exercise III – Serial Transmitter

☐ | Simulate
☐ | Issue
| Warning: Found 1 node(s) in clock paths which may be acting as ripple and/or gated clocks -- node(s) analyzed as buffer(s) resulting in clock skew

Info: Detected ripple clock "tx_buadrate:tbr_0|r_btx" as buffer

## Modified Serial Transmitter

☐ Behavior

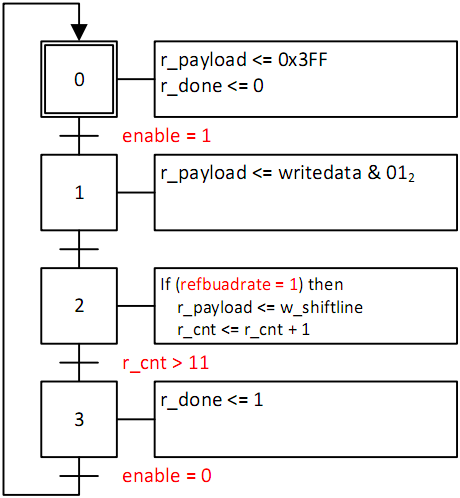
[picture p37: figure]

## Exercise VI – Modified Serial Transmitter

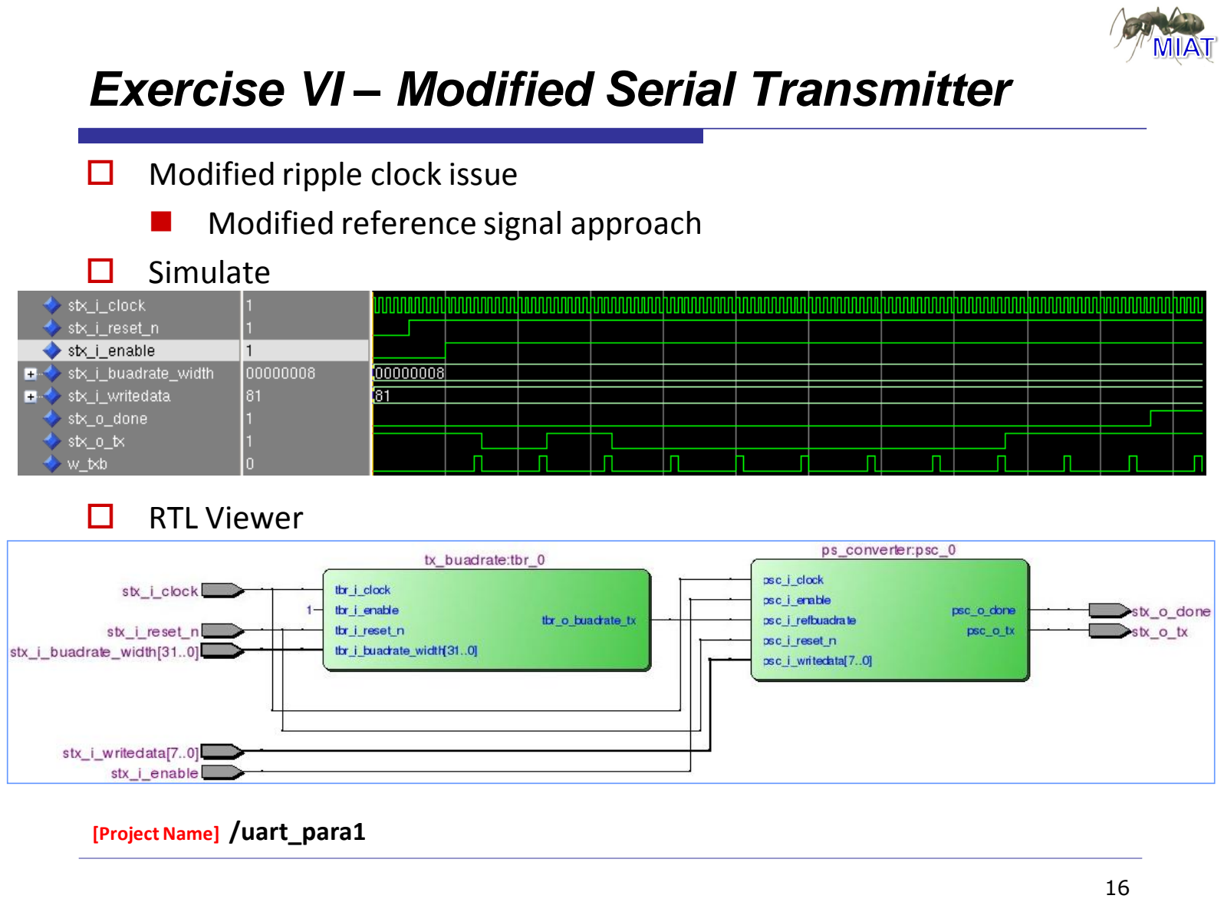
[picture p38: page 16]

☐ | Modified ripple clock issue
■ | Modified reference signal approach
☐ | Simulate
☐ | RTL Viewer

[Project Name] /uart_para1

## Exercise V – Porting Serial Transmitter

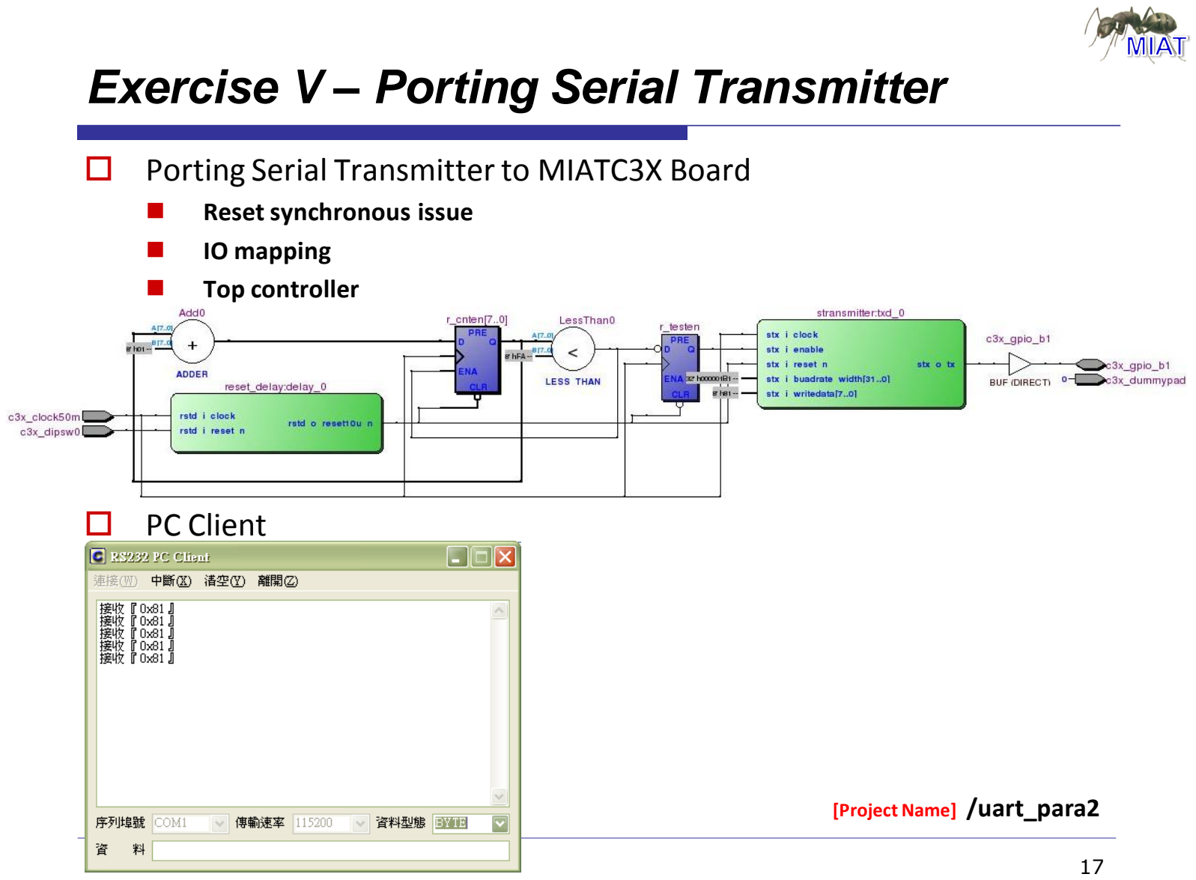
[picture p39: page 17]

☐ | Porting Serial Transmitter to MIATC3X Board
■ | Reset synchronous issue
■ | IO mapping
■ | Top controller
☐ | PC Client

[Project Name] /uart_para2

## MIATC3X Board PIN MAPPING

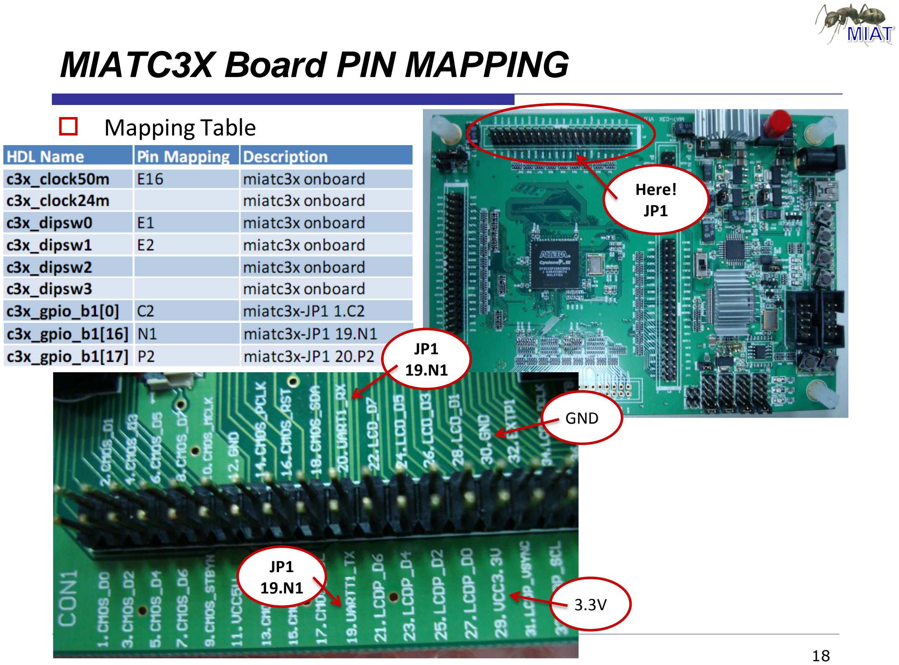
[picture p40: page 18]

☐ Mapping Table

3.3V

GND

JP1
19.N1

JP1
19.N1

Here!
JP1

# UART RECEIVER DESIGN

Part – II

## UART Communication Protocol – Receiver

☐ | UART Receiver Protocol

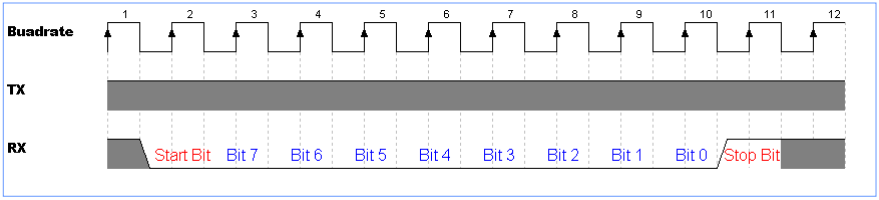
[picture p41: figure]

☐ | Rx Signal
■ | Wait Start Bit
■ | Fetch Data Bit
■ | Detect Stop Bit

## Receiver – Design Consideration

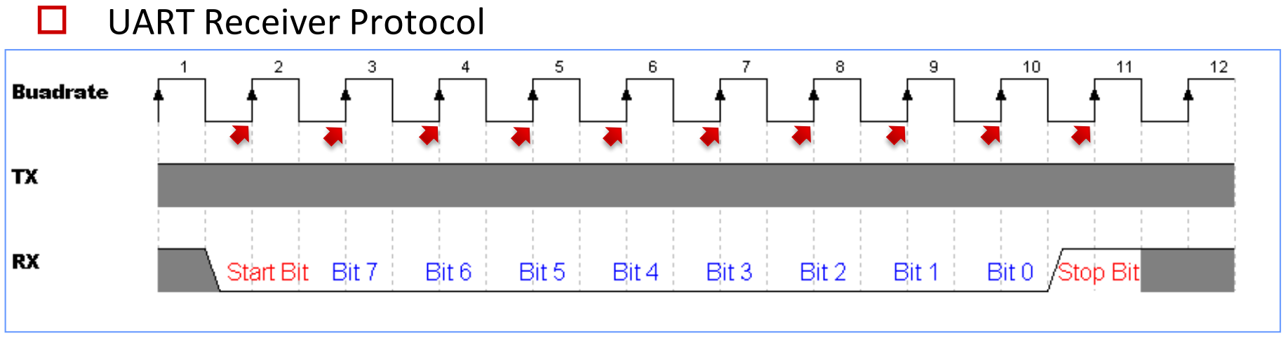
[picture p42: figure]
UART Receiver Protocol

☐ | Detect RX Bit
■ | Signal phase shift
■ | Error stop bit

Receiver – Design Consideration, Cont.

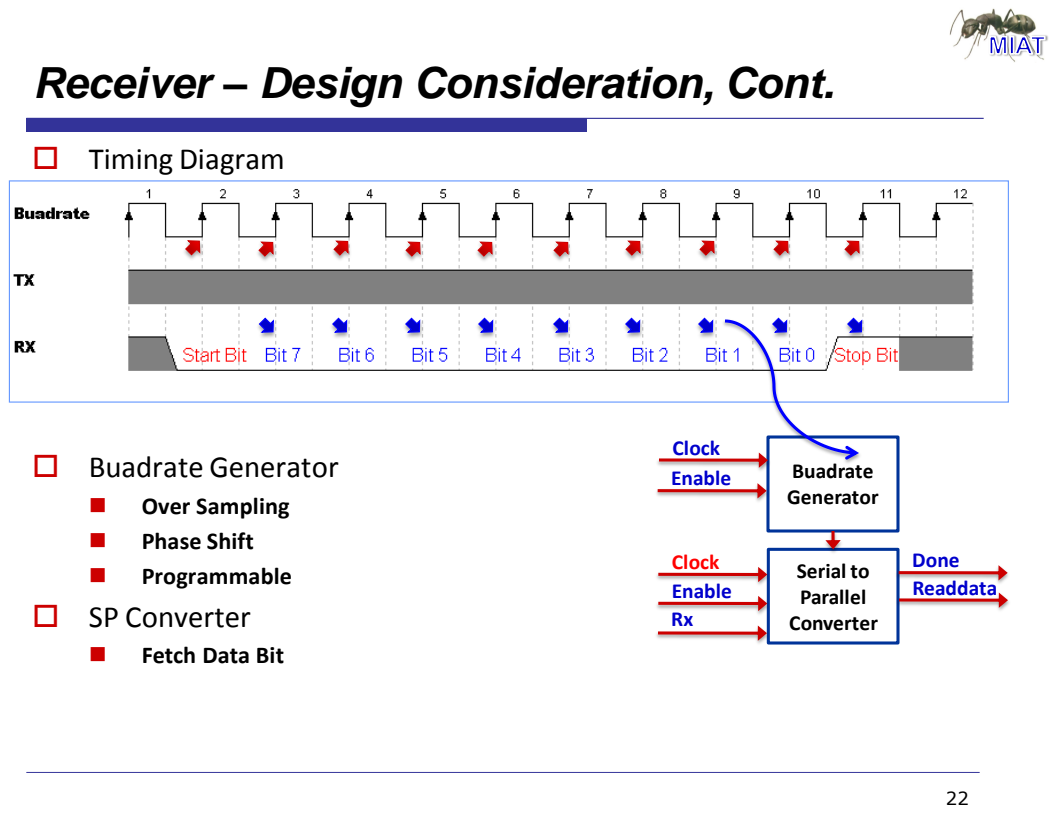
[picture p43: page 22]
Timing Diagram; Buadrate Generator; Over Sampling; Phase Shift; Programmable; SP Converter; Fetch Data Bit; Serial to Parallel Converter; Clock; Clock Enable; Done; Enable; Readdata

## Receiver – Design Entity

☐ Behavior

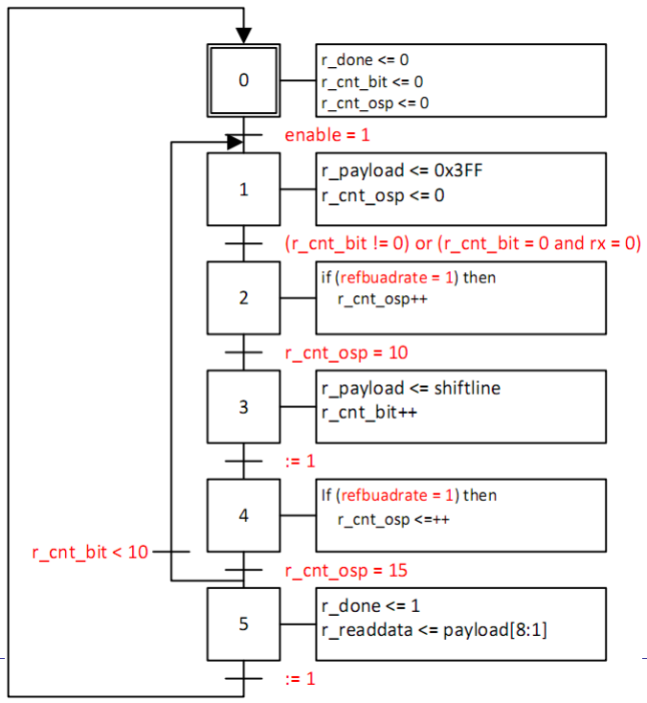
[picture p44: figure]

## Exercise VI – Serial Receiver

☐ | Design Serial Receiver
■ | Reuse Buadrate Generator
■ | Implement Serial to Parallel Converter

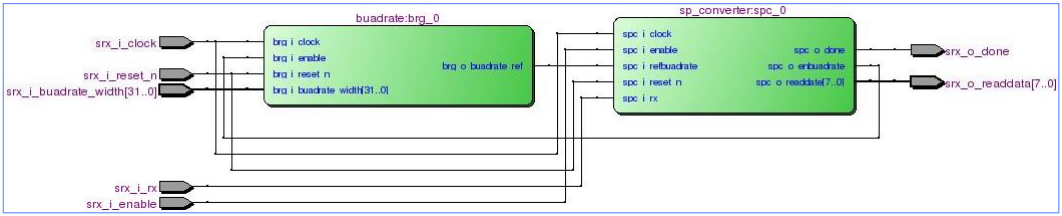
[picture p45: figure]

[Project Name] /uart_receiver1

Exercise VI – Serial Receiver, Cont.

☐ Simulate

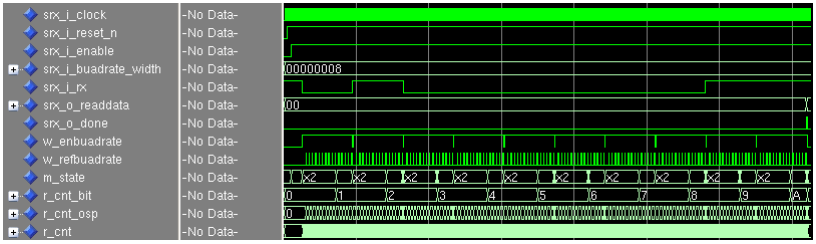
[picture p46: figure]

## Exercise VII – Receiver and Transmitter

☐ | Receive and transmit
■ | Receive a value
■ | Return it +1

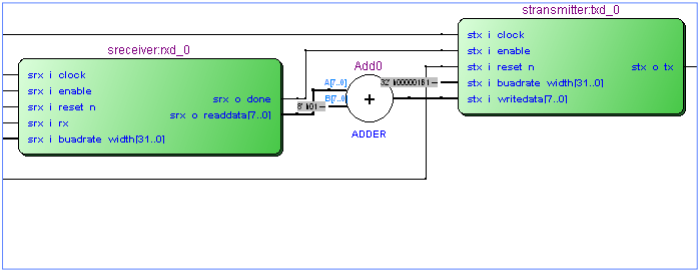
[picture p47: figure]

[Project Name] /uart_receiver2

Exercise VII – Receiver and Transmitter, Cont.

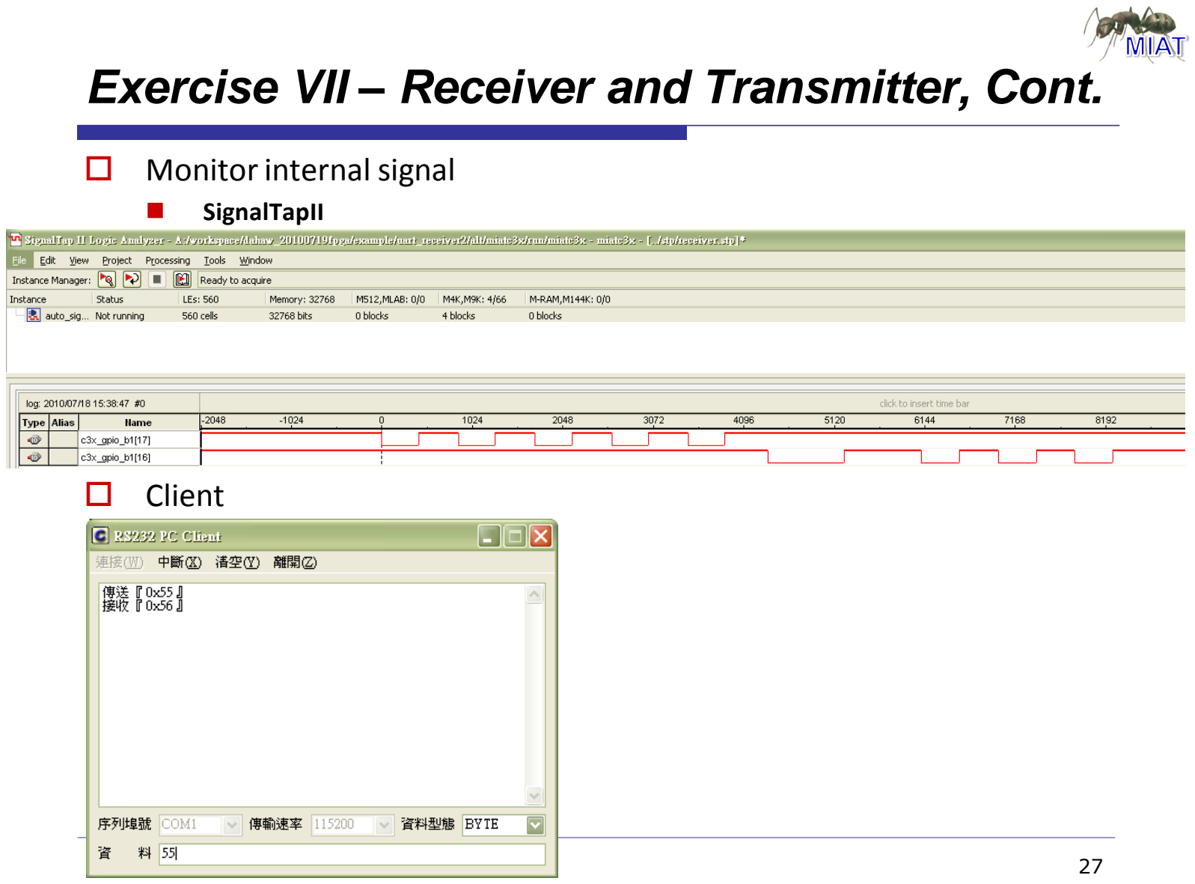
[picture p48: page 27]

☐ | Monitor internal signal
■ | SignalTapII
☐ | Client

# TIME FOR QUESTION

Part – III

## Note:

# APPENDIX

Part – IV

## Project Architecture

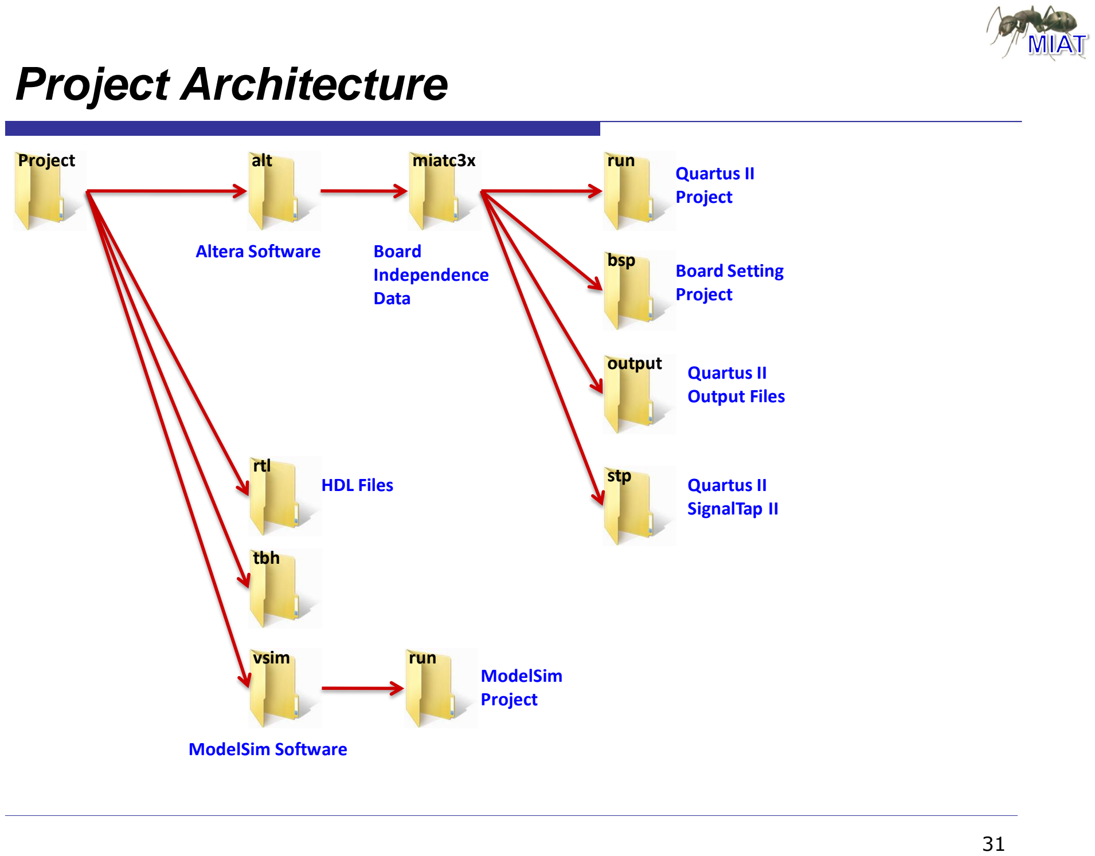
[picture p49: page 31]

Project | alt

rtl

tbh

vsim

miatc3x | run

bsp

output

run

Altera Software Board Independence Data
Board Setting
Project

Quartus II
Project

Quartus II
Output Files
stp | Quartus II
| SignalTap II

HDL Files

ModelSim Software

ModelSim
Project

## QuartusII Project Setting

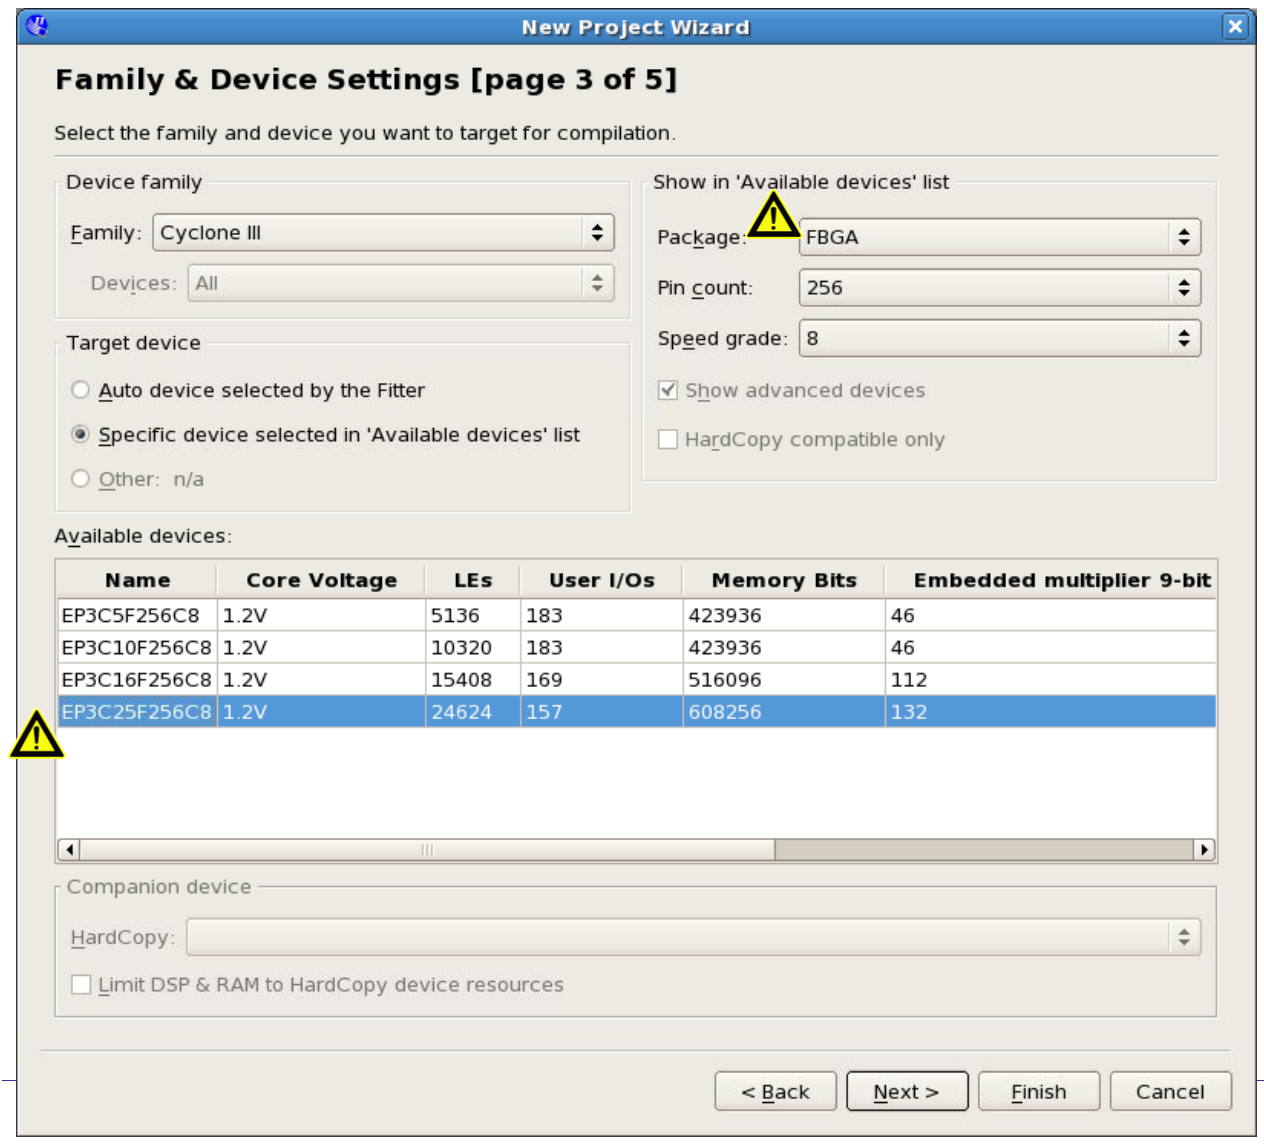
[picture p50: figure]

QuartusII Project Setting, Cont.

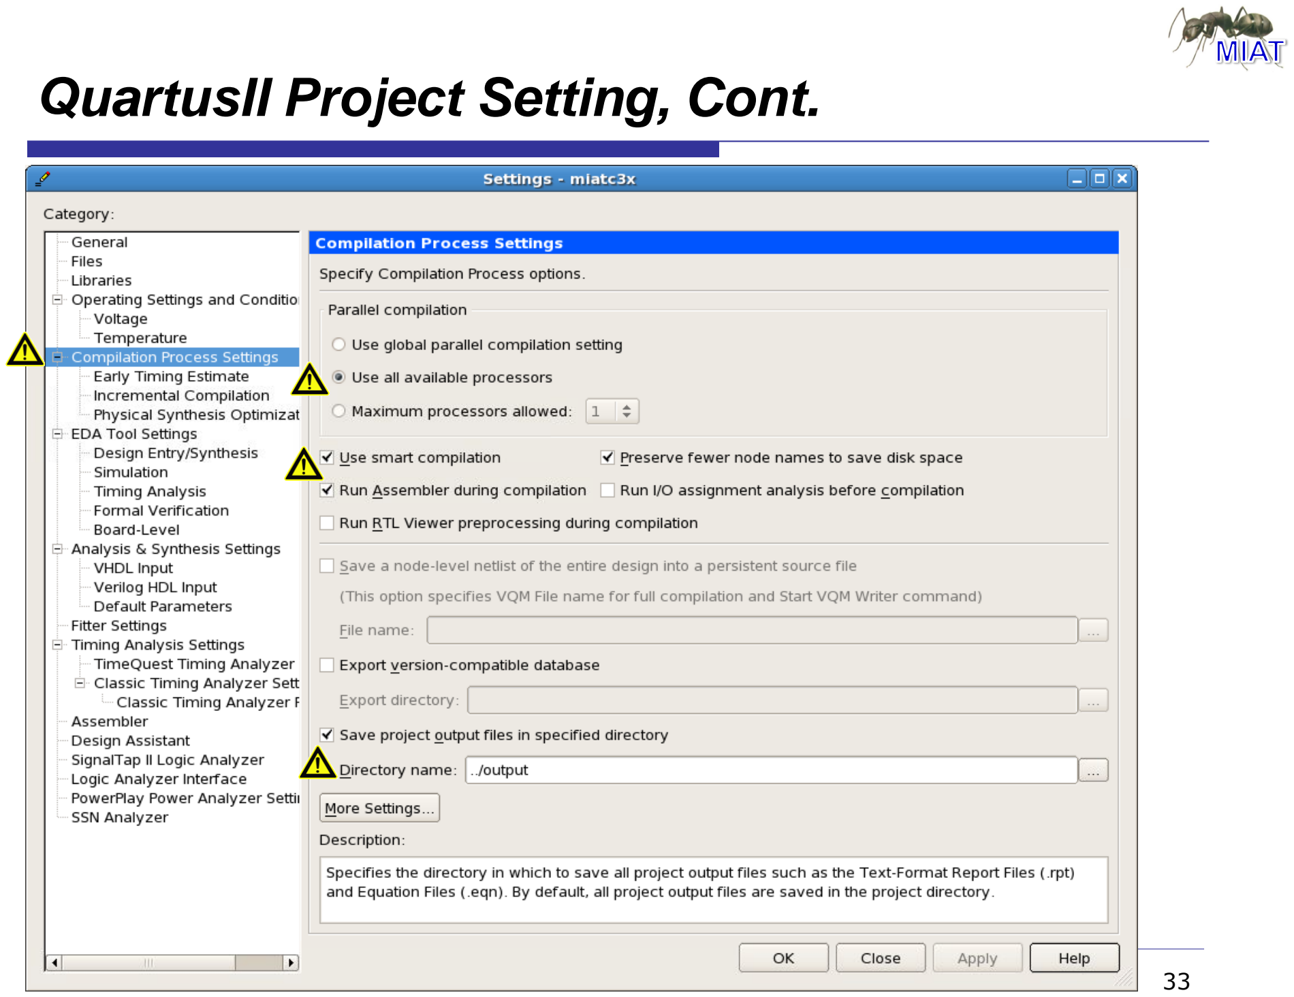
[picture p51: page 33]

QuartusII Project Setting, Cont.

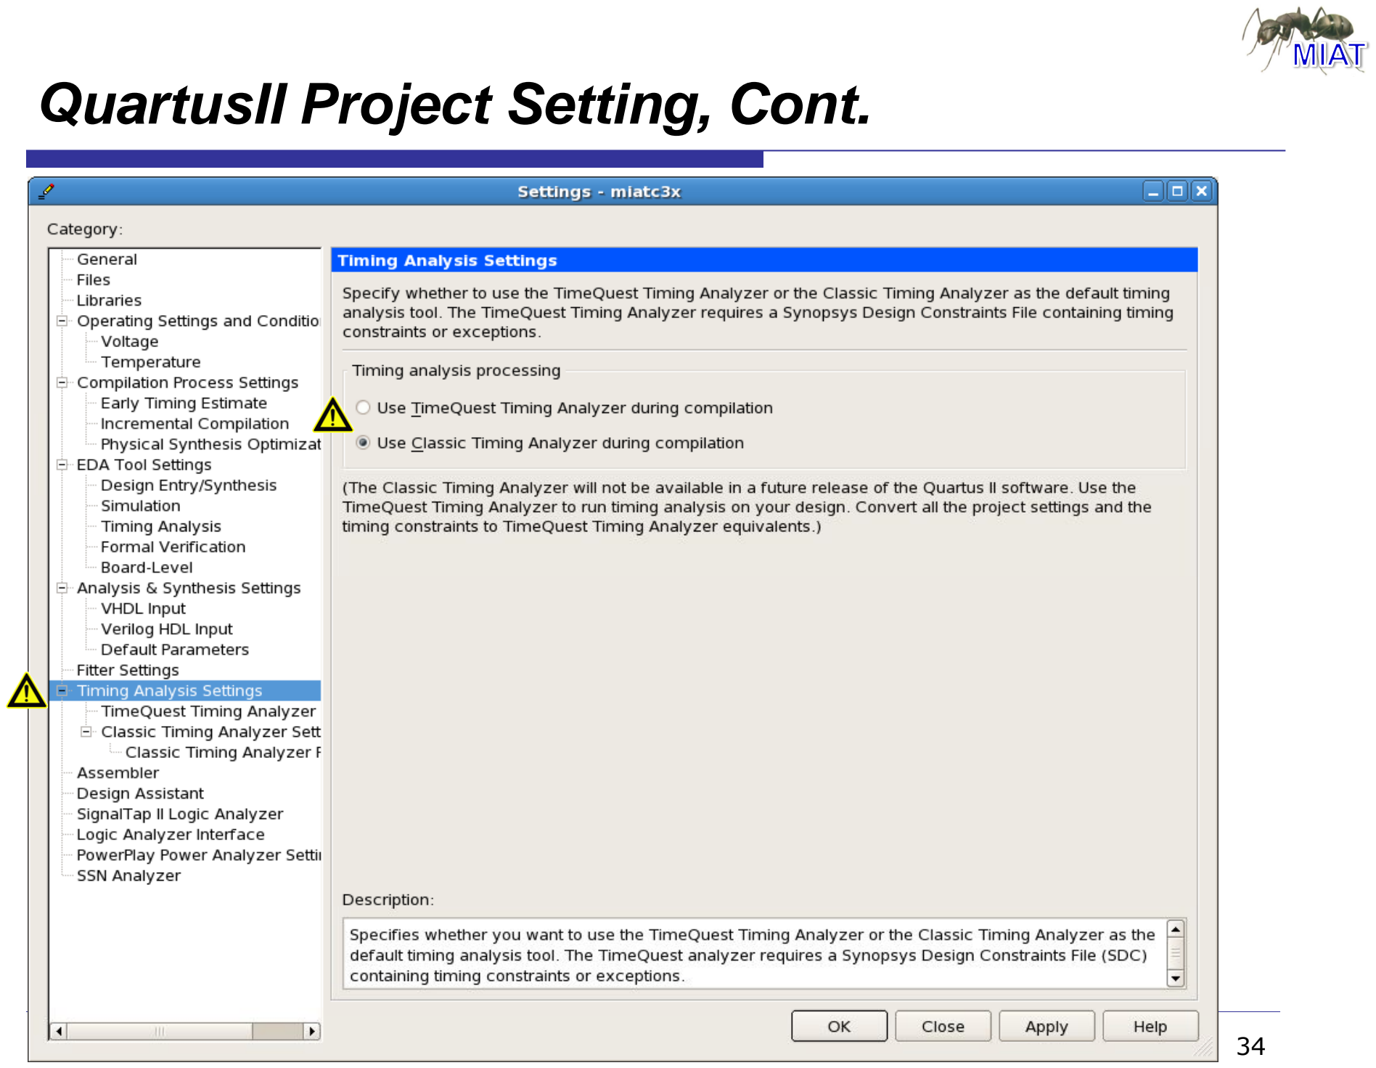
[picture p52: page 34]
