wuyangtech/MIAT_C3X25/Docs/modelsim.pdf

CSIE MIAT Lab.

National Central University

# Simple ModelSim Starter Guide

MIAT-C3X FPGA Development Board

# 浯陽科技有限公司

# Main Windows

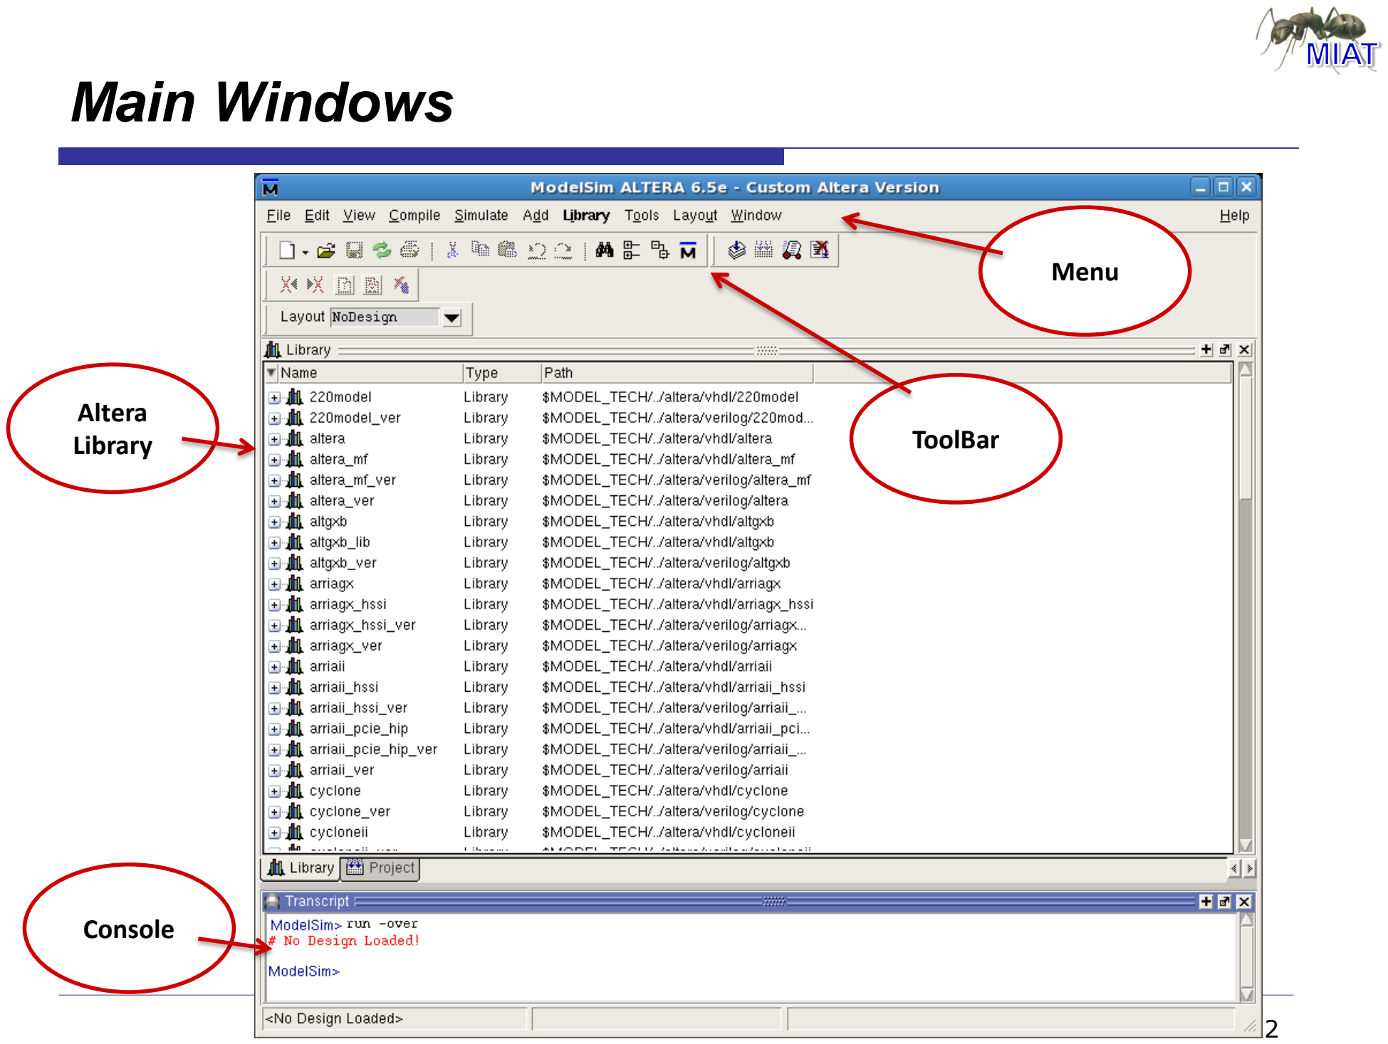
[picture p55: page 2]

Altera
Library

Console

Menu

ToolBar

# New Project

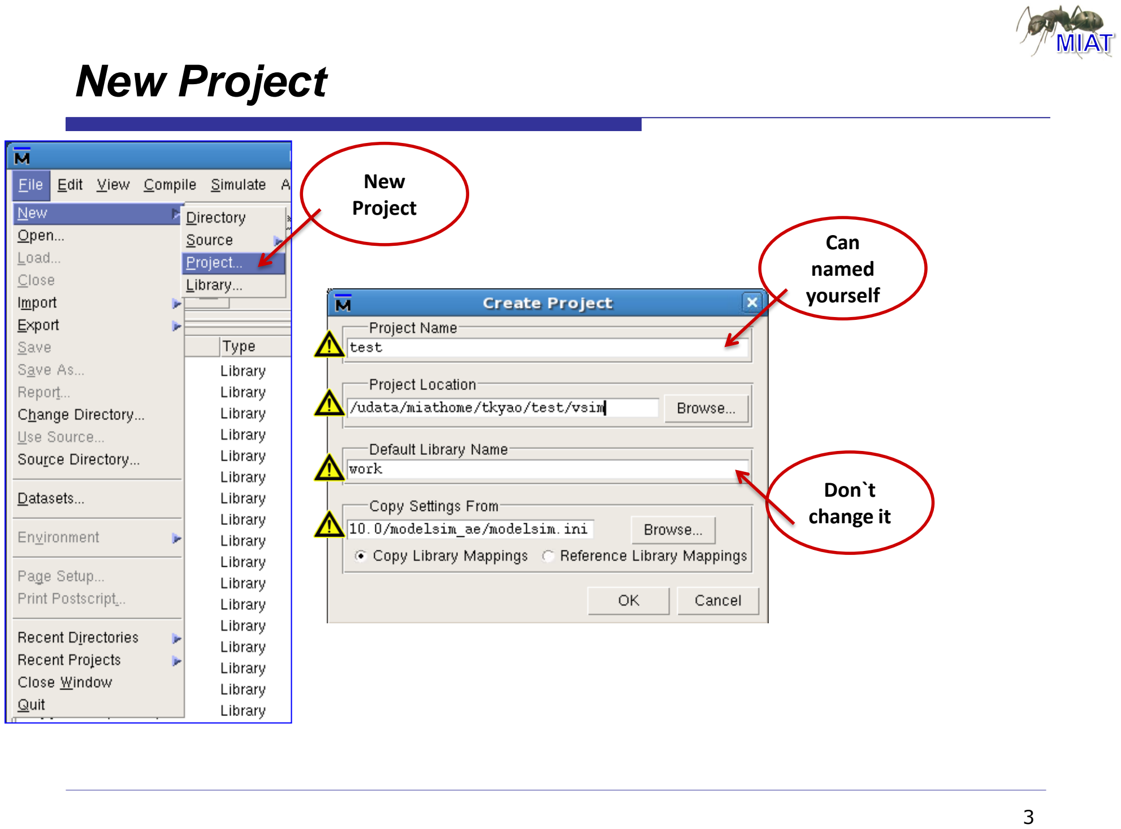
[picture p56: page 3]

New
Project
Can
named
yourself

Don`t
change it

# New Project, Cont. 1

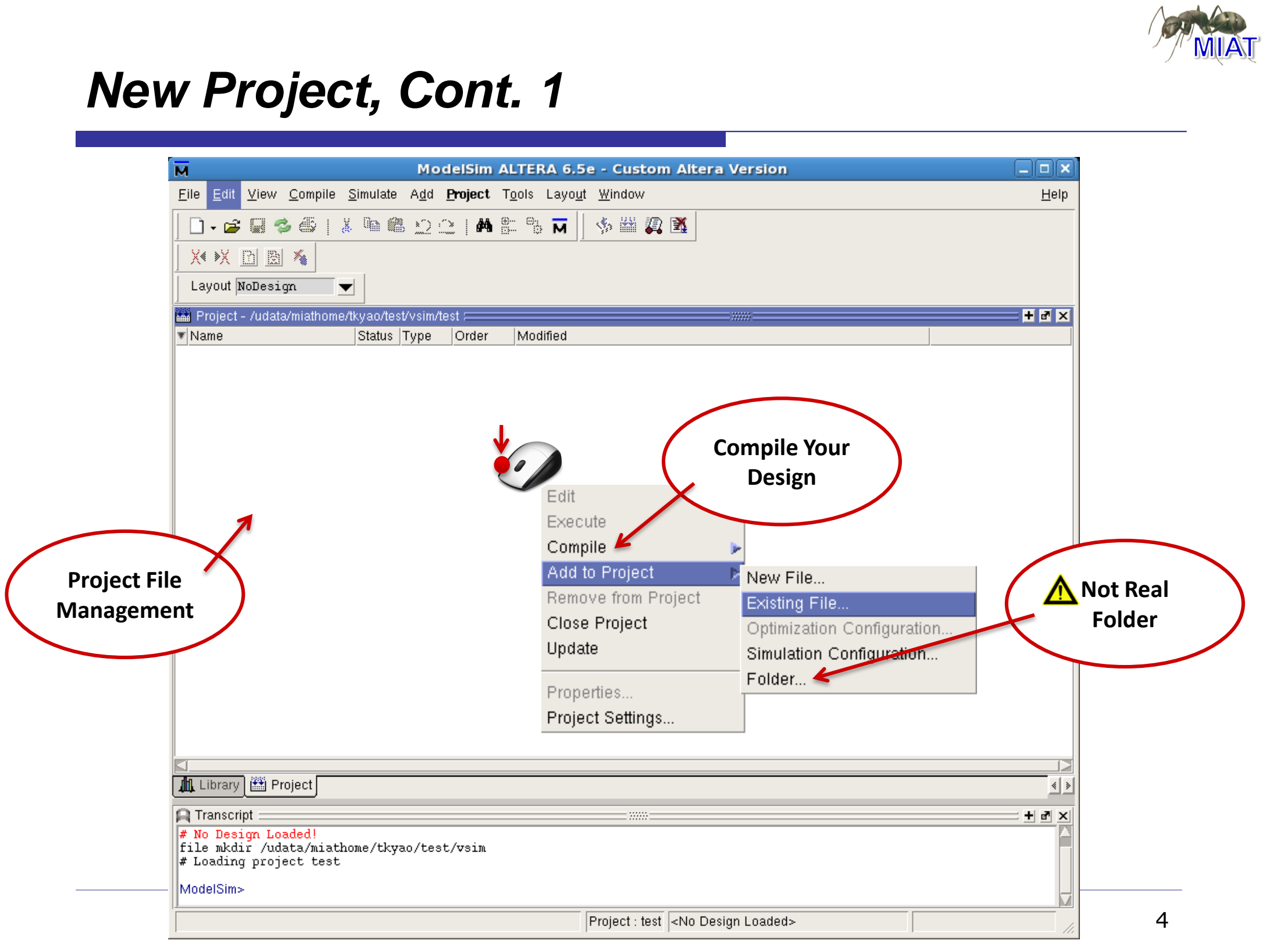
[picture p57: page 4]

Project File
Management

Not Real
Folder

Compile Your
Design

# New Project, Cont. 2

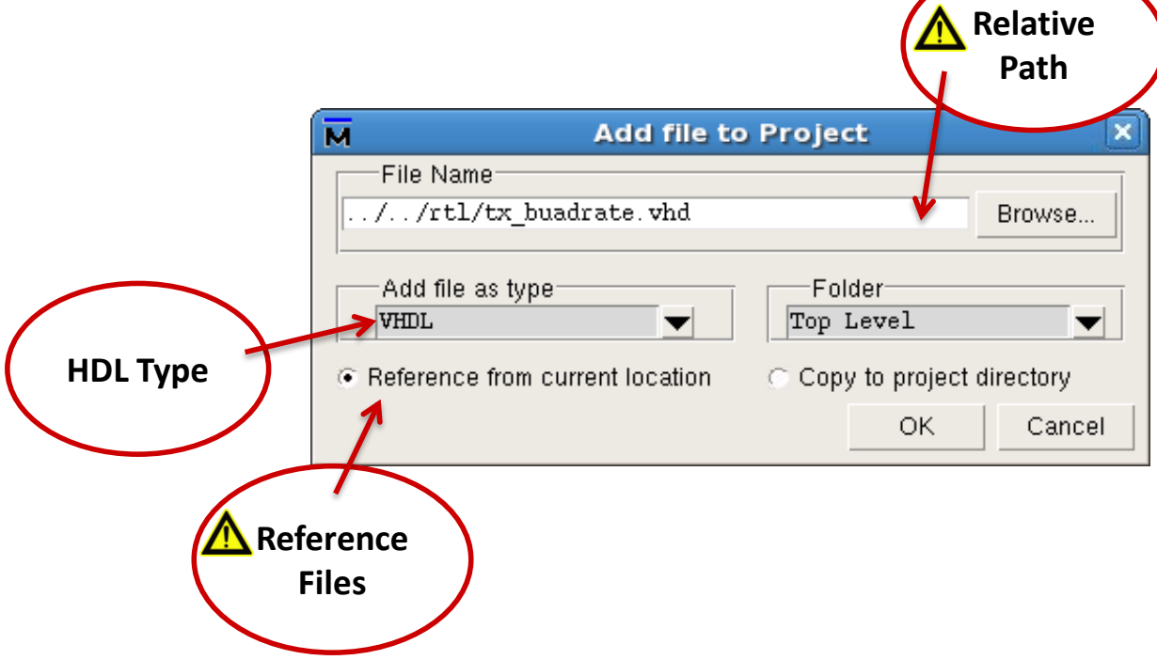
[picture p58: figure]
Relative Path; HDL Type; Reference Files

# New Project, Cont. 2

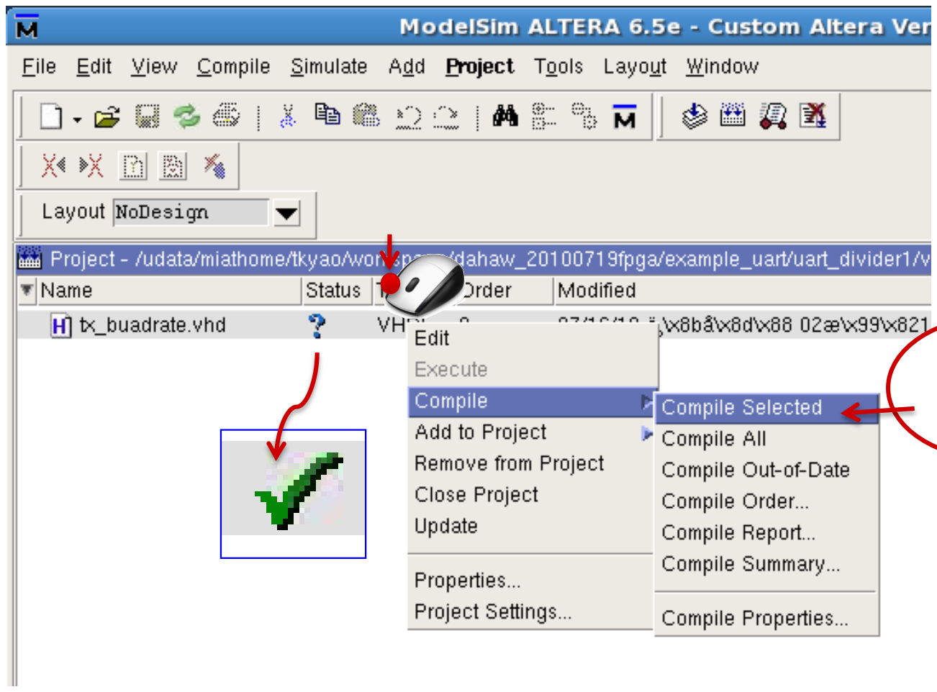
[picture p59: figure]

Compile
it

# Simulation

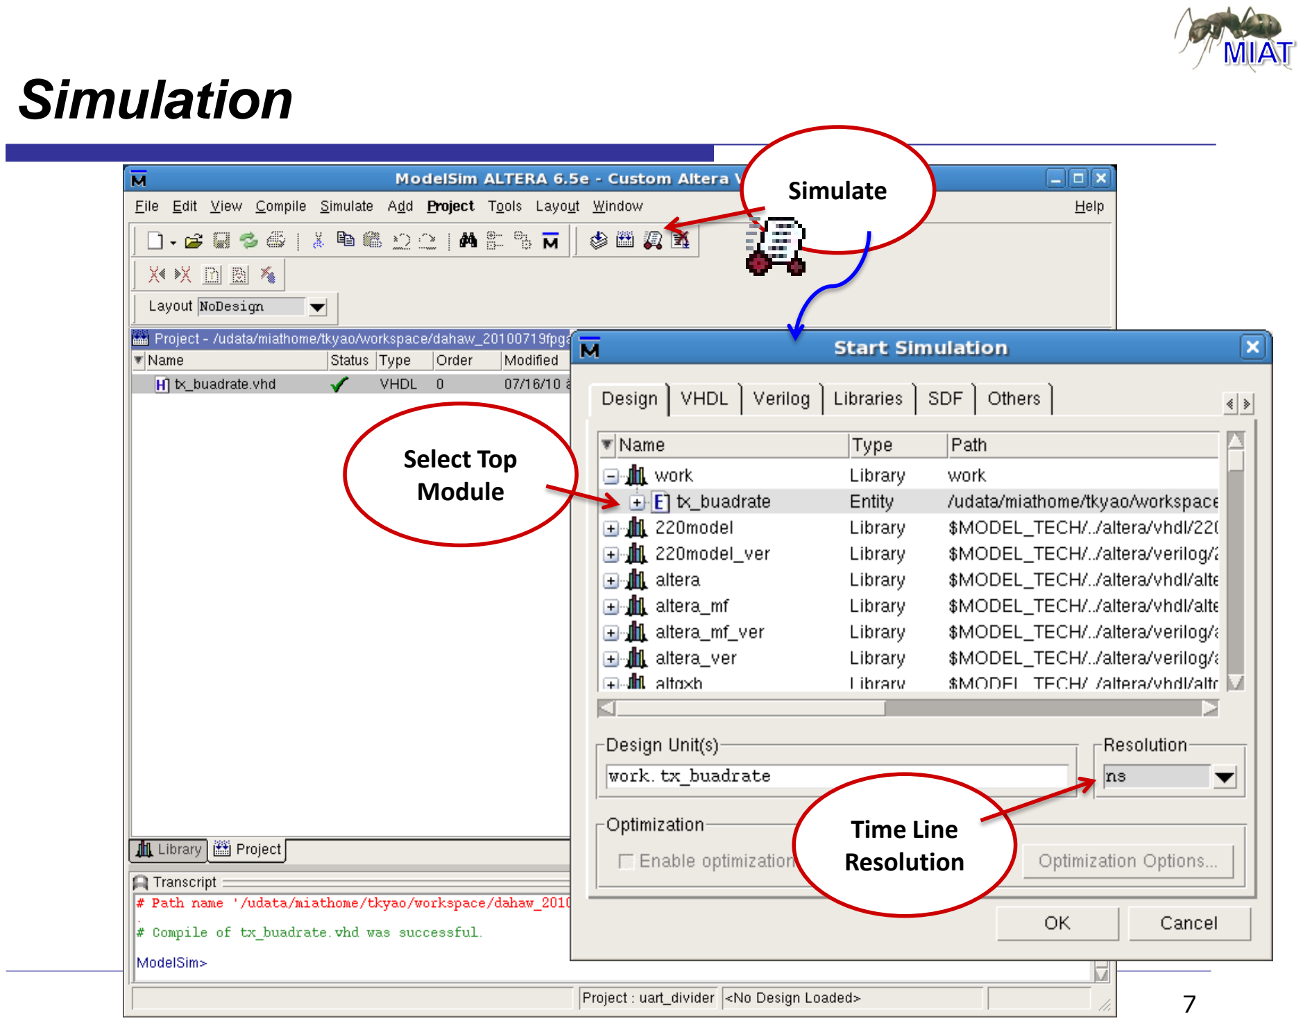
[picture p60: page 7]

Simulate

Select Top
Module

Time Line
Resolution

# Simulation, Cont. 1

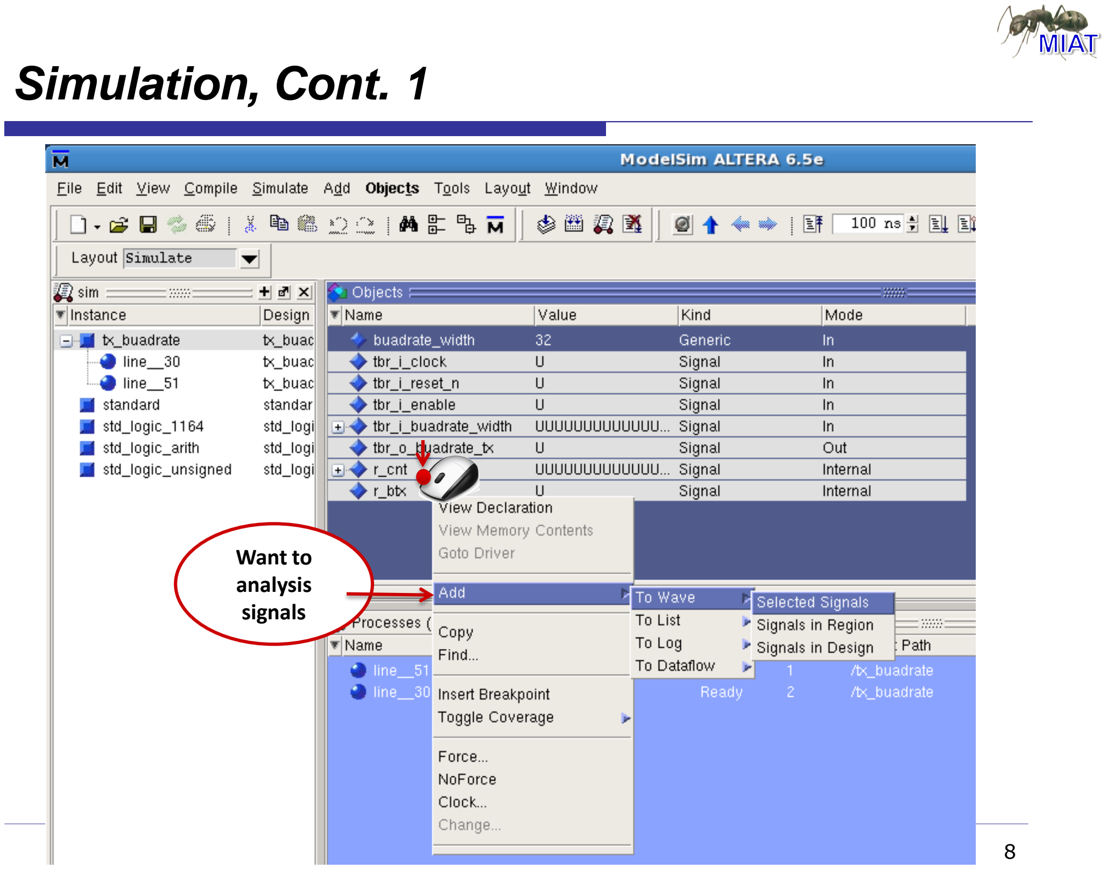
[picture p61: page 8]

Want to
analysis
signals

# Simulation, Cont. 2

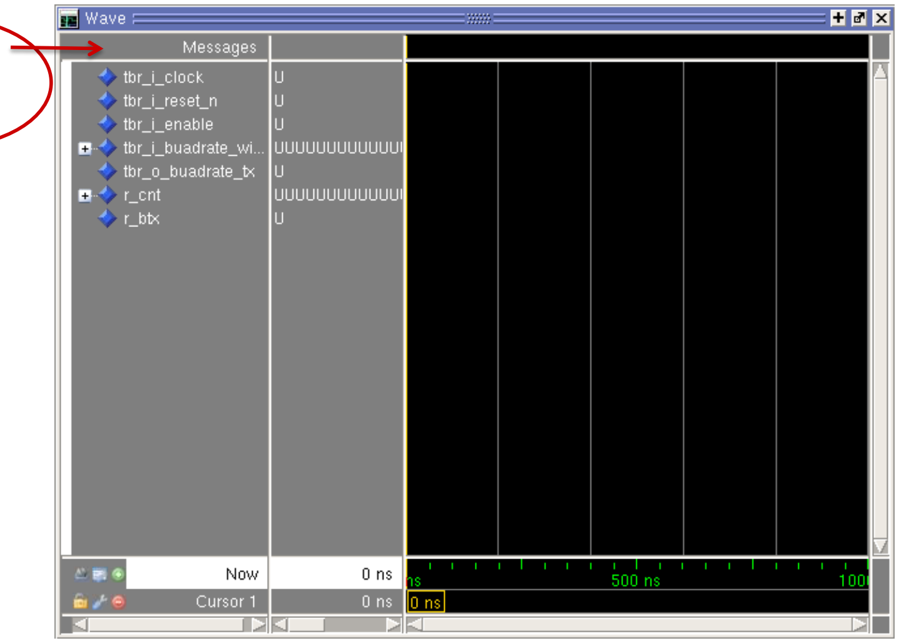
[picture p62: figure]

Start to
simulate

# Note
