wuyangtech/MIAT_C3X25/Examples/RGB2YUV/hw_algorithm.pdf

CSIE MIAT Lab.

National Central University

Algorithm

MIAT-C3X FPGA Development Board

浯陽科技有限公司

Outline

☐ | Part I
■ | Design Considerations
■ | Design Entity
☐ | MageCore
☐ | Parallel
☐ | PipeLine
☐ | Part II
■ | Project Setting

## YUV CONVERSION

Part – I

YUV Conversion Algorithm

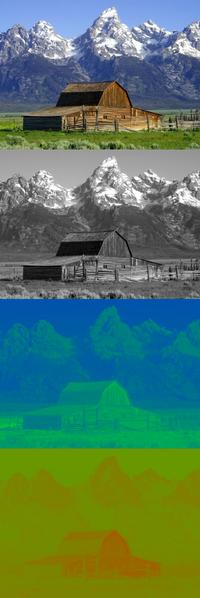
[picture p63: figure]

☐ | RGB to YUV Conversion Equations
■ | Y = (0.257*R) + (0.504*G) + (0.098*B) + 16
■ | Cr = V = (0.439*R) – (0.368*G) – (0.071*B) +128
■ | Cb = U = – (0.148*R) – (0.291*G) + (0.439*B) +128

[Reference] WiKi

Design Considerations

☐ | Floating Point Operation
■ | Y = (0.257*R) + (0.504*G) + (0.098*B) + 16
☐ | Speed
■ | High Speed DSP Block
■ | Pipe-Line
☐ | Area
■ | Optimization
☐ | Power
☐ | Verification
☐ | Testing

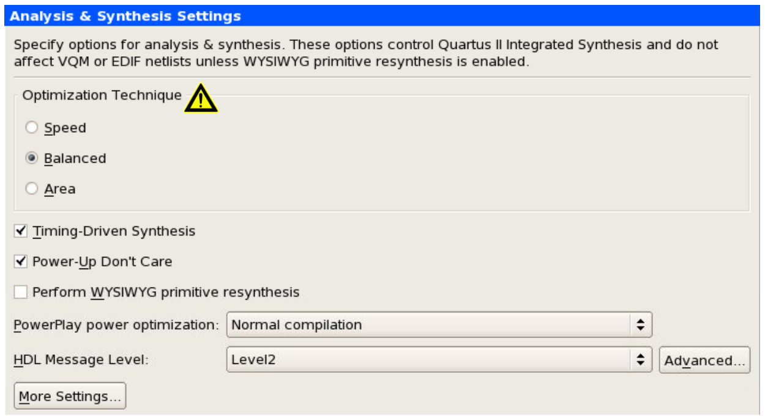
[picture p64: figure]
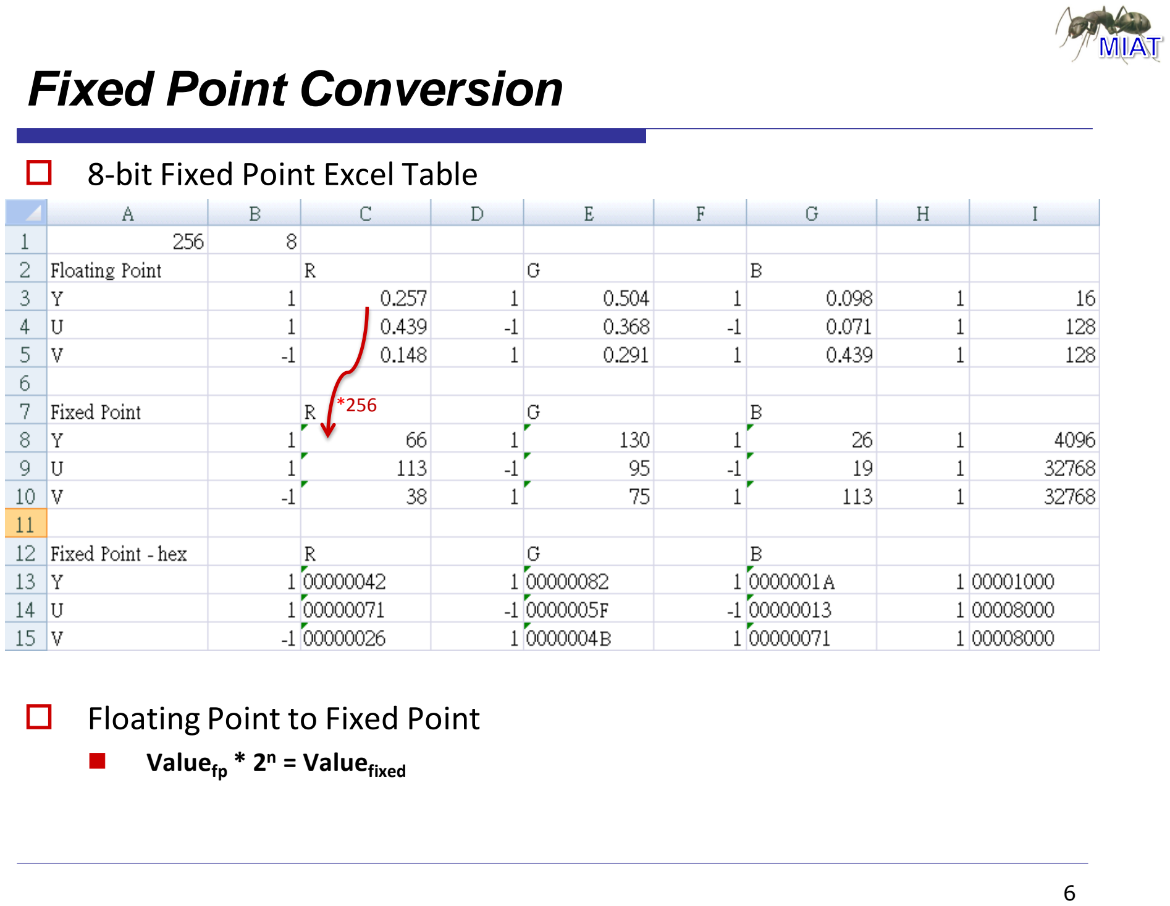
[picture p65: page 6]

Fixed Point Conversion

☐ | 8-bit Fixed Point Excel Table
☐ | Floating Point to Fixed Point
■ | Valuefp * 2n = Valuefixed

*256

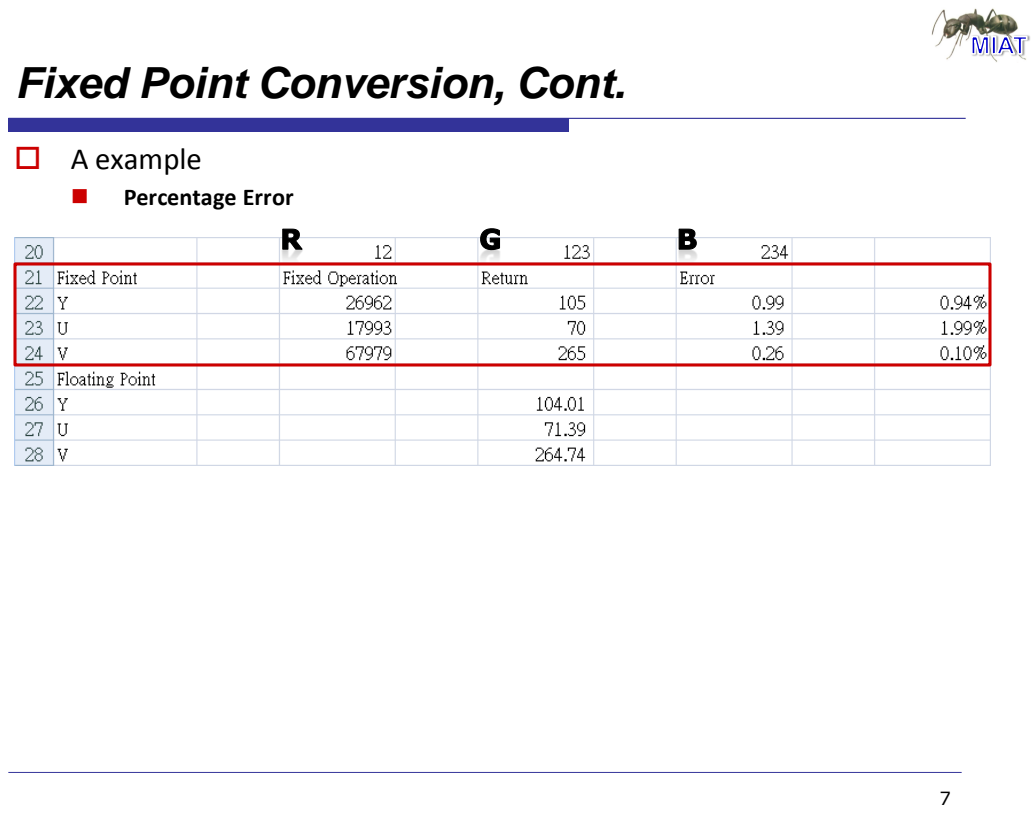
[picture p66: page 7]
A example; Percentage Error

Fixed Point Conversion, Cont.

Design Entity – MegaCore

☐ | Fixed Point Operation
☐ | Data Width
■ | Adder
■ | Multiplication
☐ | Timing Analysis
■ | Between two register

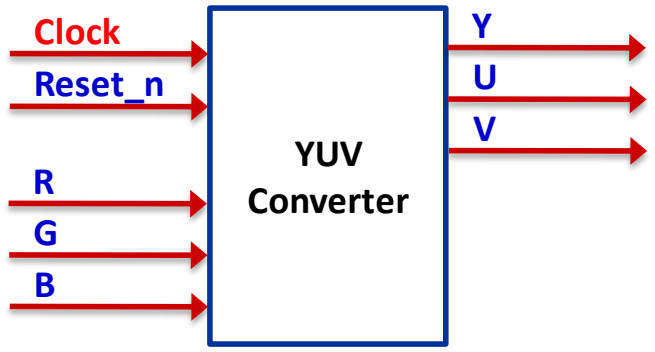
[picture p67: figure]
YUV Converter; Clock Reset_n
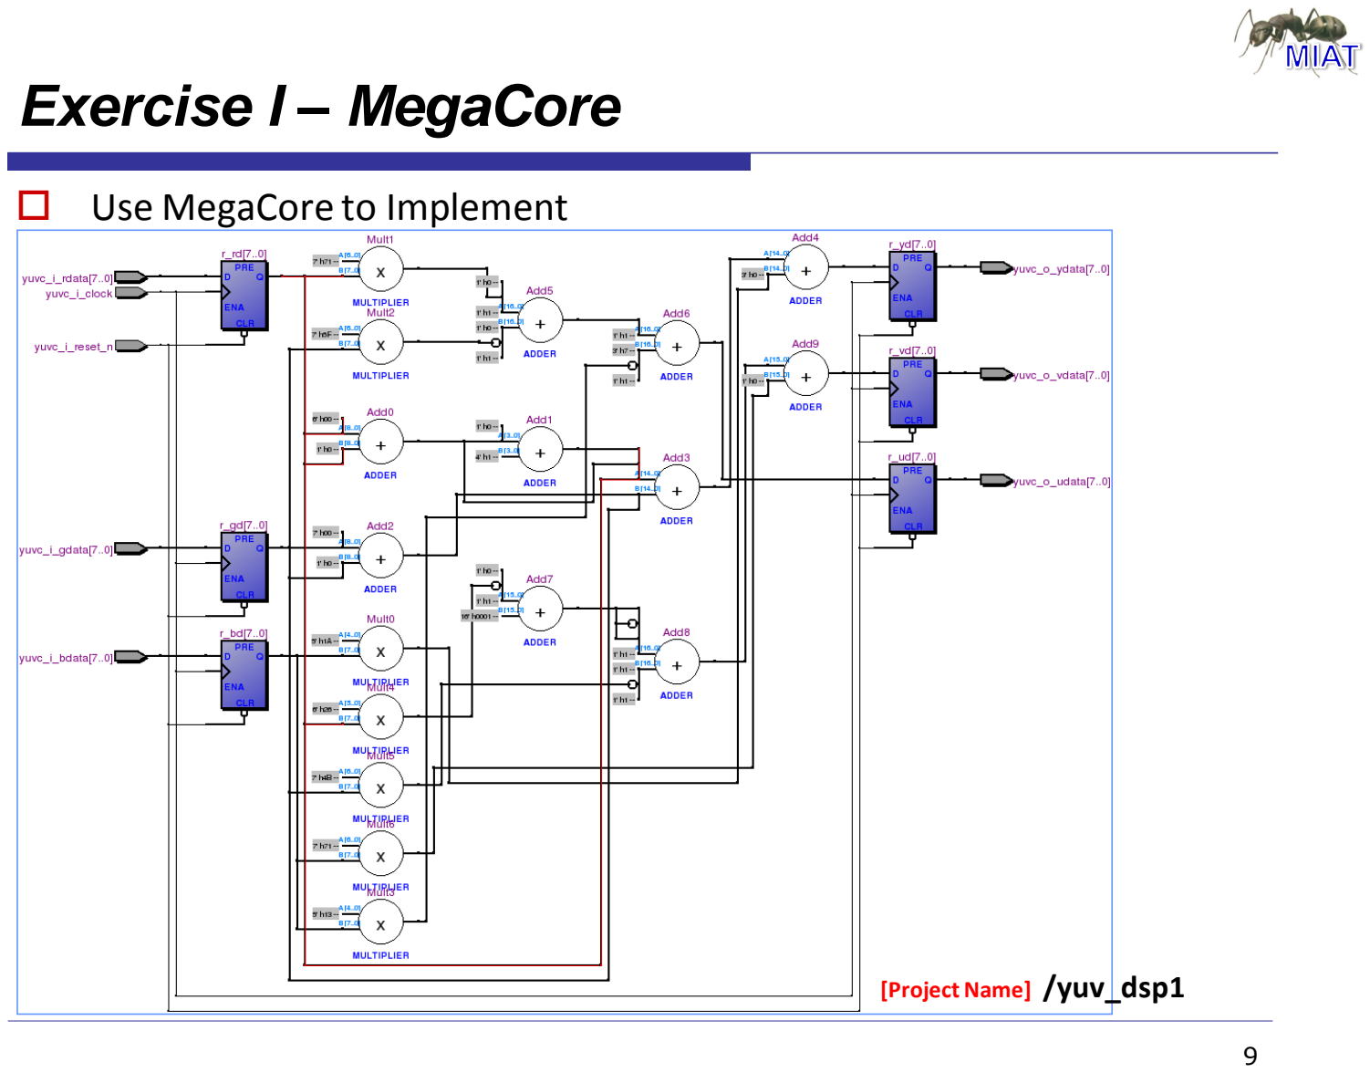
[picture p68: page 9]

Exercise I – MegaCore

☐ Use MegaCore to Implement

[Project Name] /yuv_dsp1

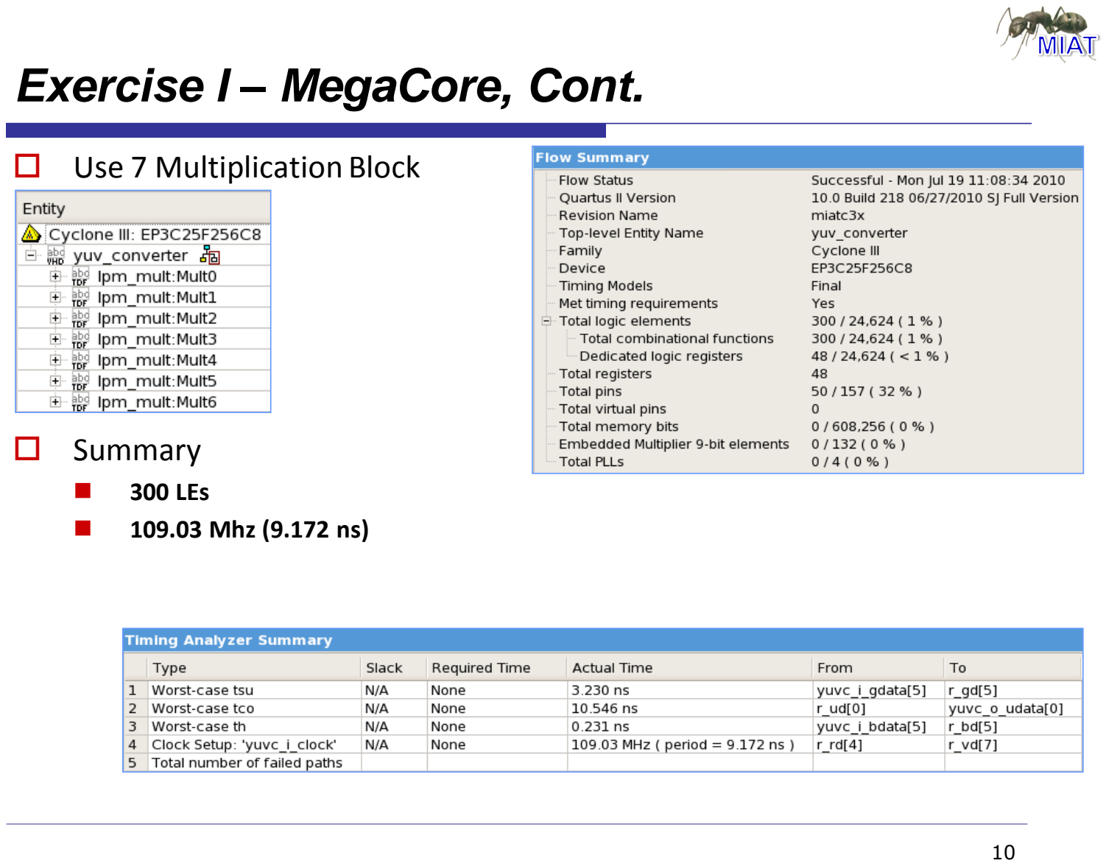
[picture p69: page 10]

Exercise I – MegaCore, Cont.

☐ | Use 7 Multiplication Block
☐ | Summary
■ | 300 LEs
■ | 109.03 Mhz (9.172 ns)

Exercise I – MegaCore, Cont.

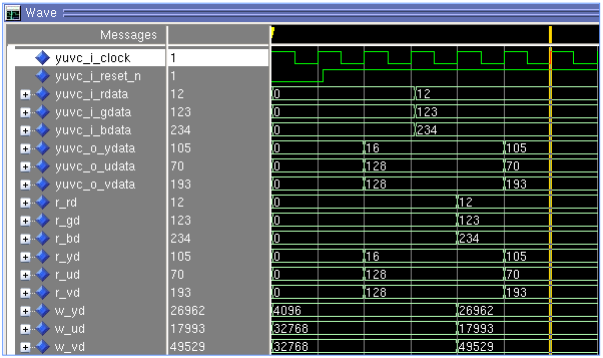
[picture p70: figure]

☐ Simulation

Exercise II – Parallel Operations

☐ Improve HDL Description

[Project Name] /yuv_dsp2

Exercise II – Parallel Operations, Cont.

☐ | Summary
■ | 286 LEs
■ | 110.95 Mhz (9.013ns)

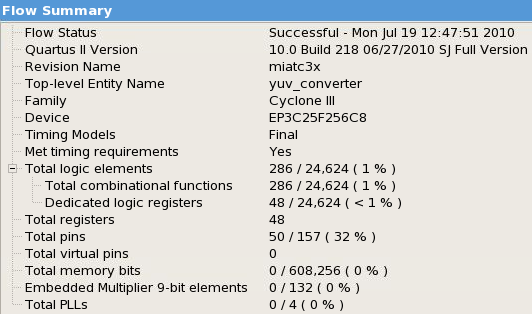
[picture p71: figure]

Exercise II – Parallel Operations, Cont.

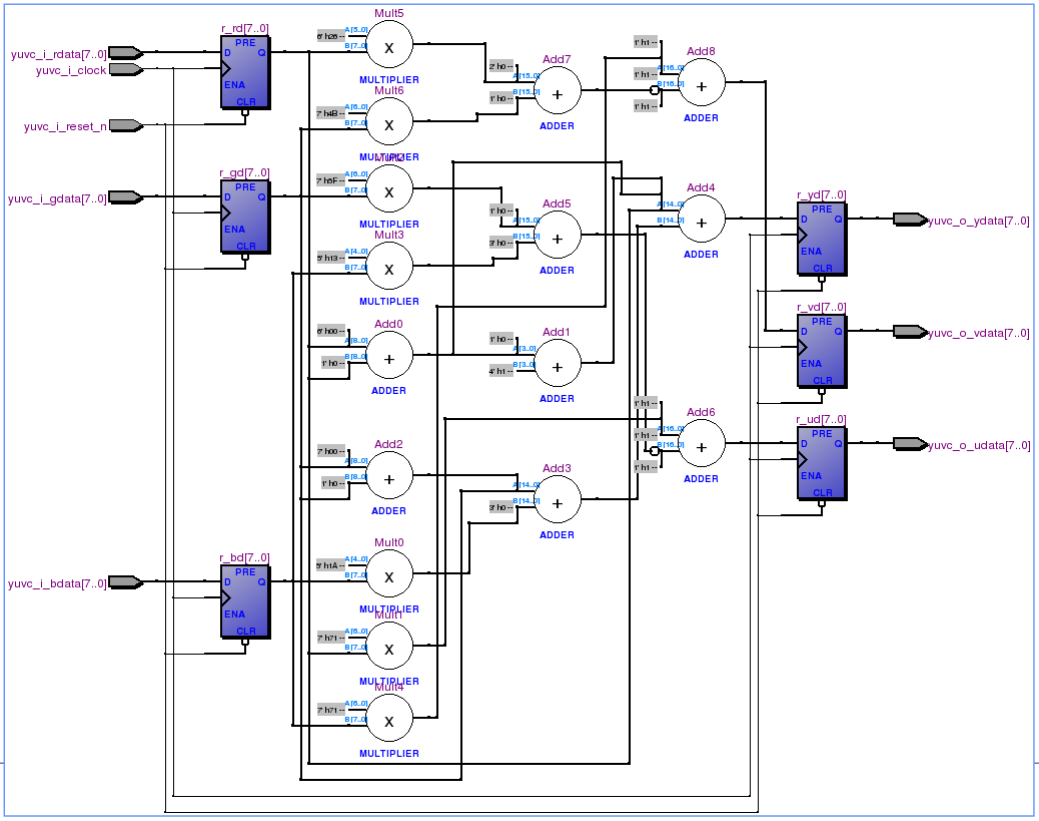
[picture p72: figure]

☐ RTL Viewer

Exercise II – Parallel Operations, Cont.

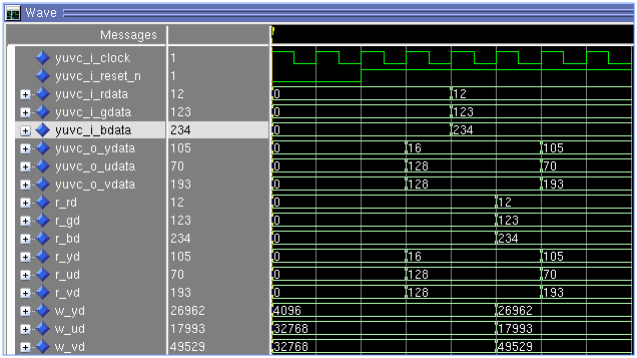
[picture p73: figure]

☐ Simulation

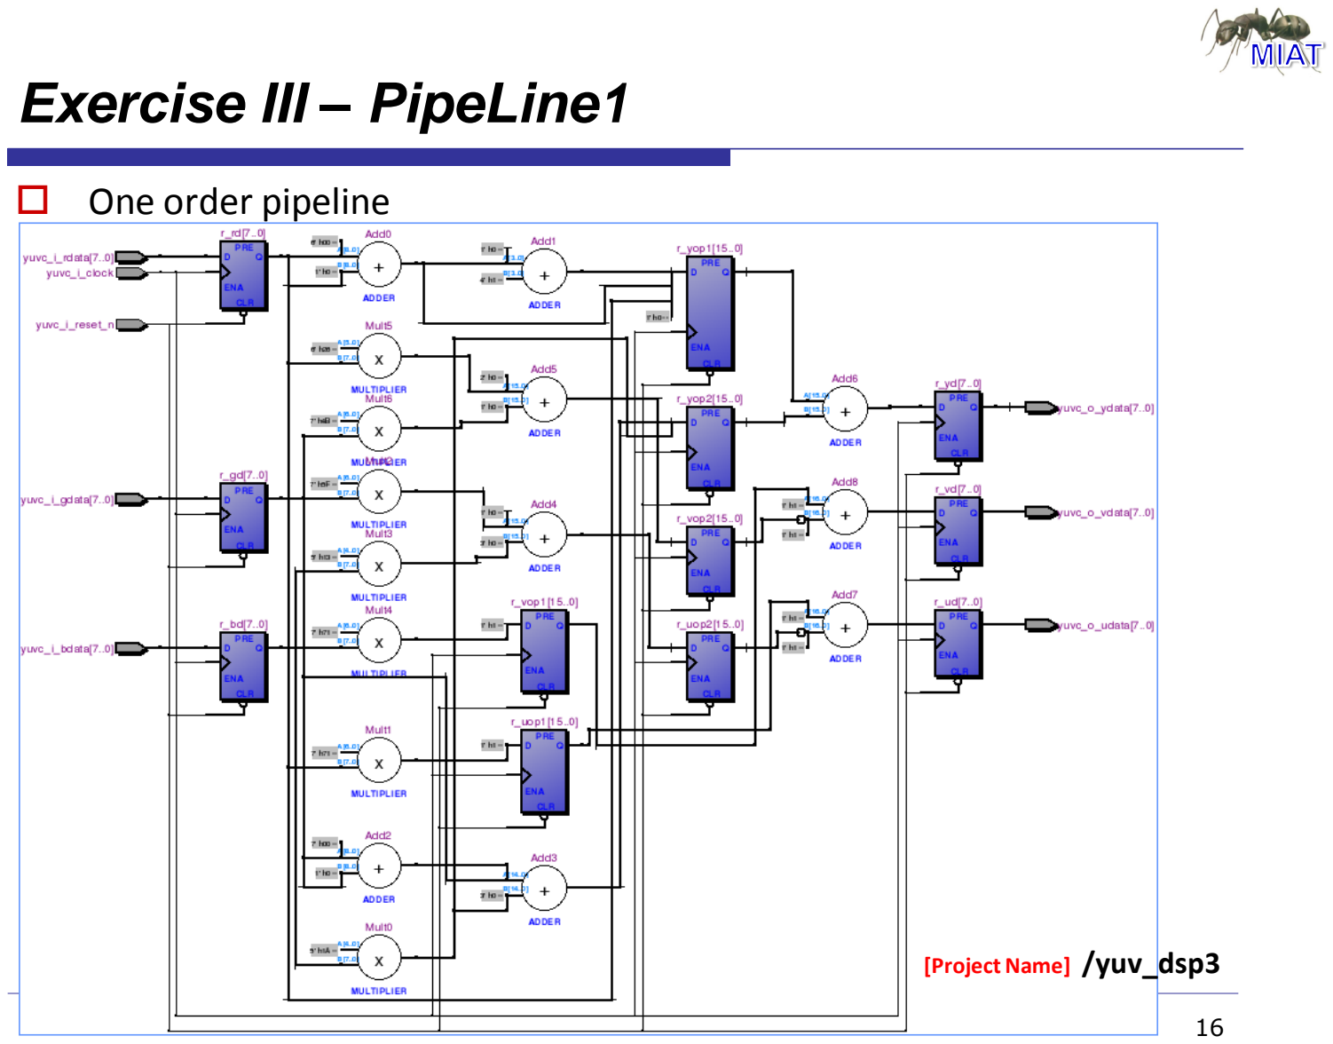
[picture p74: page 16]

Exercise III – PipeLine1

☐ One order pipeline

[Project Name] /yuv_dsp3

Exercise III – PipeLine1, Cont.

☐ | Summary
■ | 289 LEs
■ | 154.37 Mhz (6.478ns)

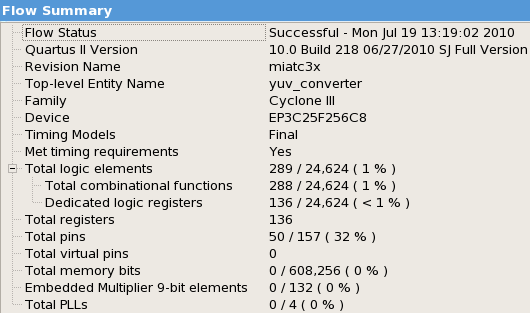
[picture p75: figure]
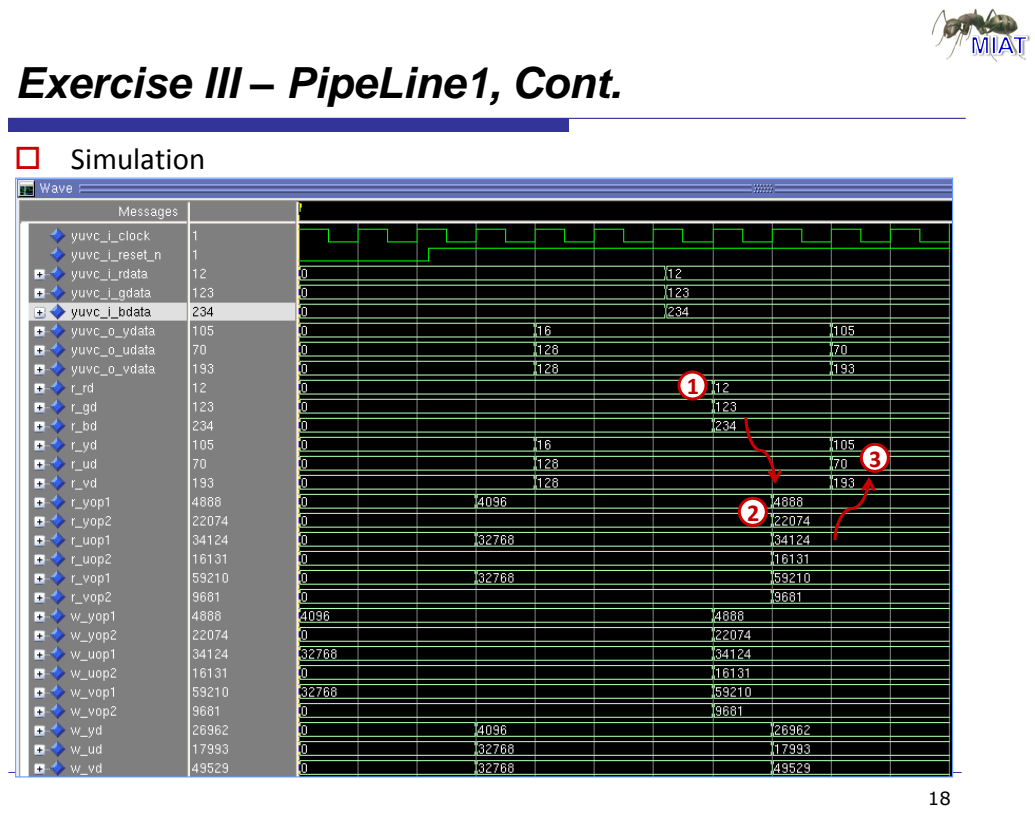
[picture p76: page 18]
Simulation

Exercise III – PipeLine1, Cont.

Exercise VI – PipeLine2

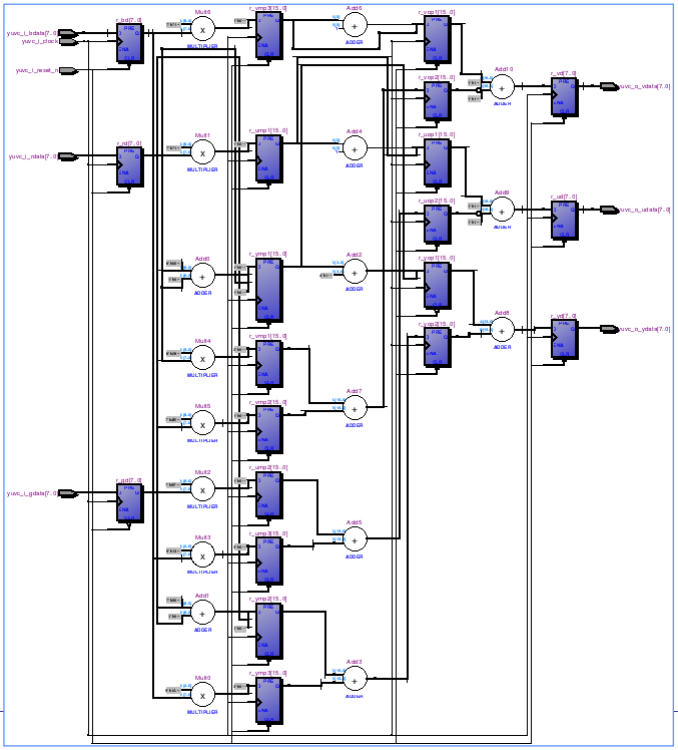
[picture p77: figure]

☐ Two order pipeline

[Project Name] /yuv_dsp4

Exercise VI – PipeLine2, Cont.

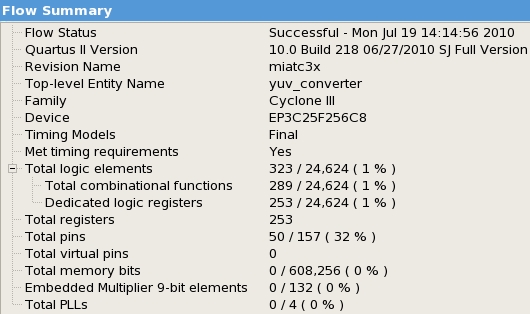
[picture p78: figure]

☐ Summary

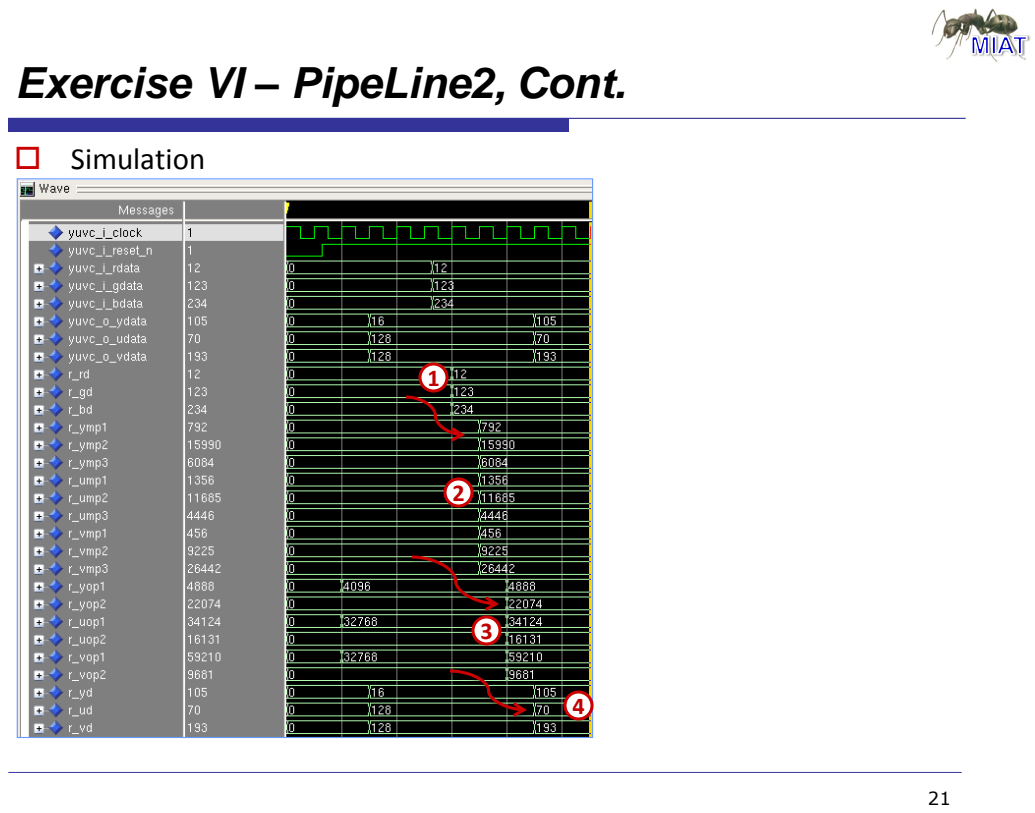
[picture p79: page 21]
Simulation

Exercise VI – PipeLine2, Cont.

Exercise V – Without Multiplication

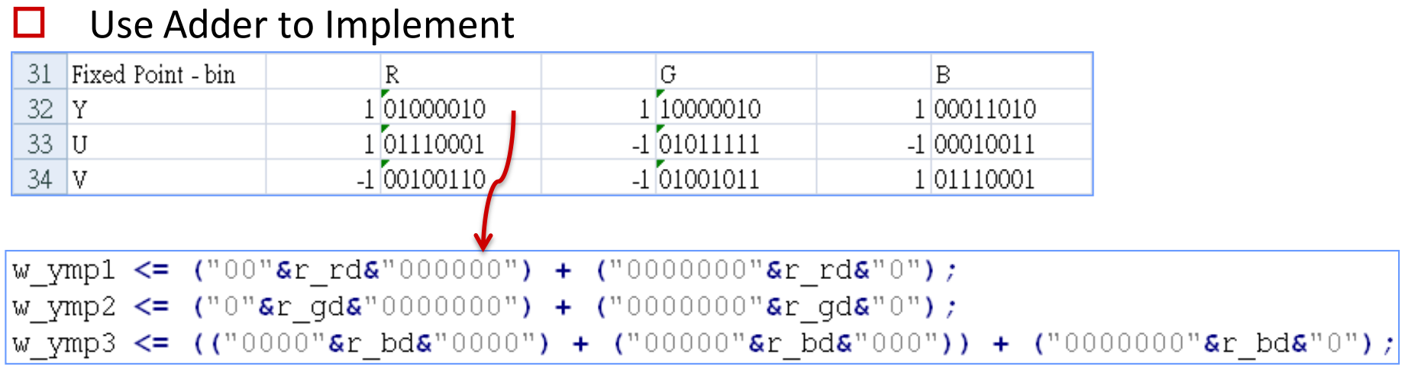
[picture p80: figure]
Use Adder to Implement

[Project Name] /yuv_dsp5

Exercise V – Without Multiplication, Cont.

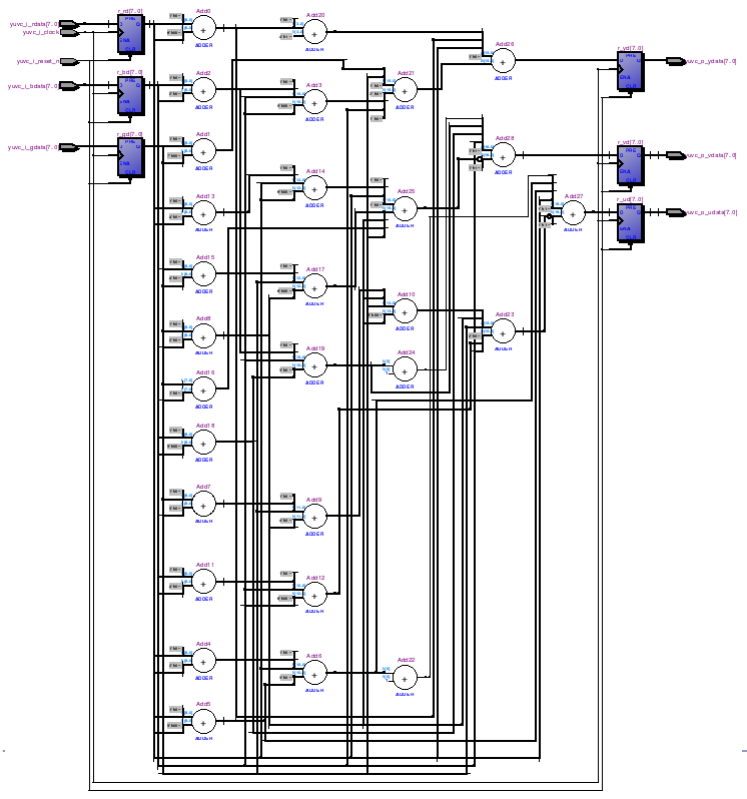
[picture p81: figure]

Exercise V – Without Multiplication, Cont.

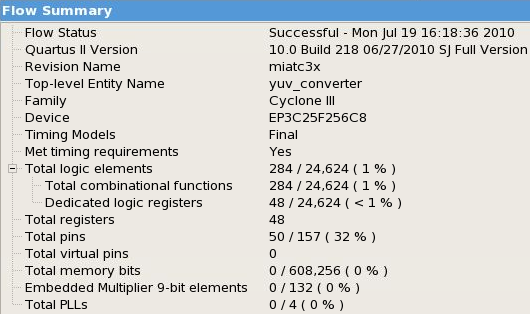
[picture p82: figure]

☐ Summary

Exercise V – Without Multiplication, Cont.

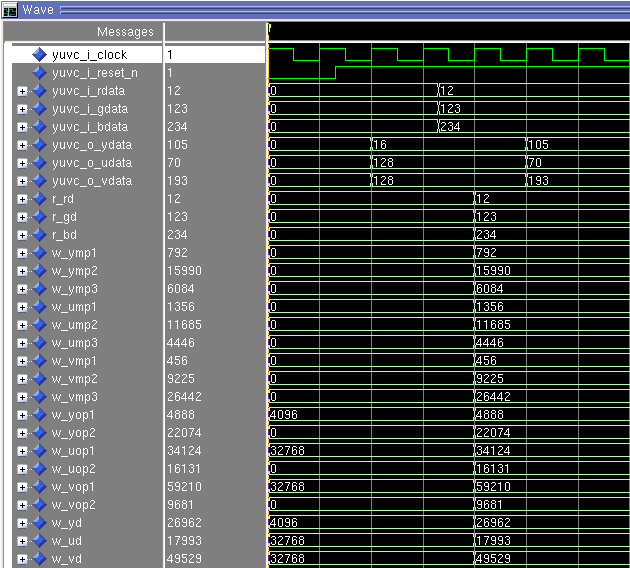
[picture p83: figure]

☐ Simulation Result

Note:
