wuyangtech/MIAT_C3X25/(list of files, cad)

Other CAD files:
Examples/HW_SW_Integration/hscomm_lab1/hardware/alt/miatc3x/stp/stp1.stp
Examples/HW_SW_Integration/hscomm_lab2/hardware/alt/miatc3x/stp/stp1.stp
Examples/HW_SW_Integration/hscomm_lab3/hardware/alt/miatc3x/stp/stp1.stp
Examples/HW_SW_Integration/hscomm_lab4/hardware/alt/miatc3x/stp/stp1.stp
Examples/UART/example_uart/uart_receiver2/alt/miatc3x/stp/receiver.stp
