wuyangtech/MIAT_C3X25/Schematic/MIAT-C3X V1.0-20101009.pdf

TOP | COVER PAGE, TOP | 01 ~ 03

# PAGE

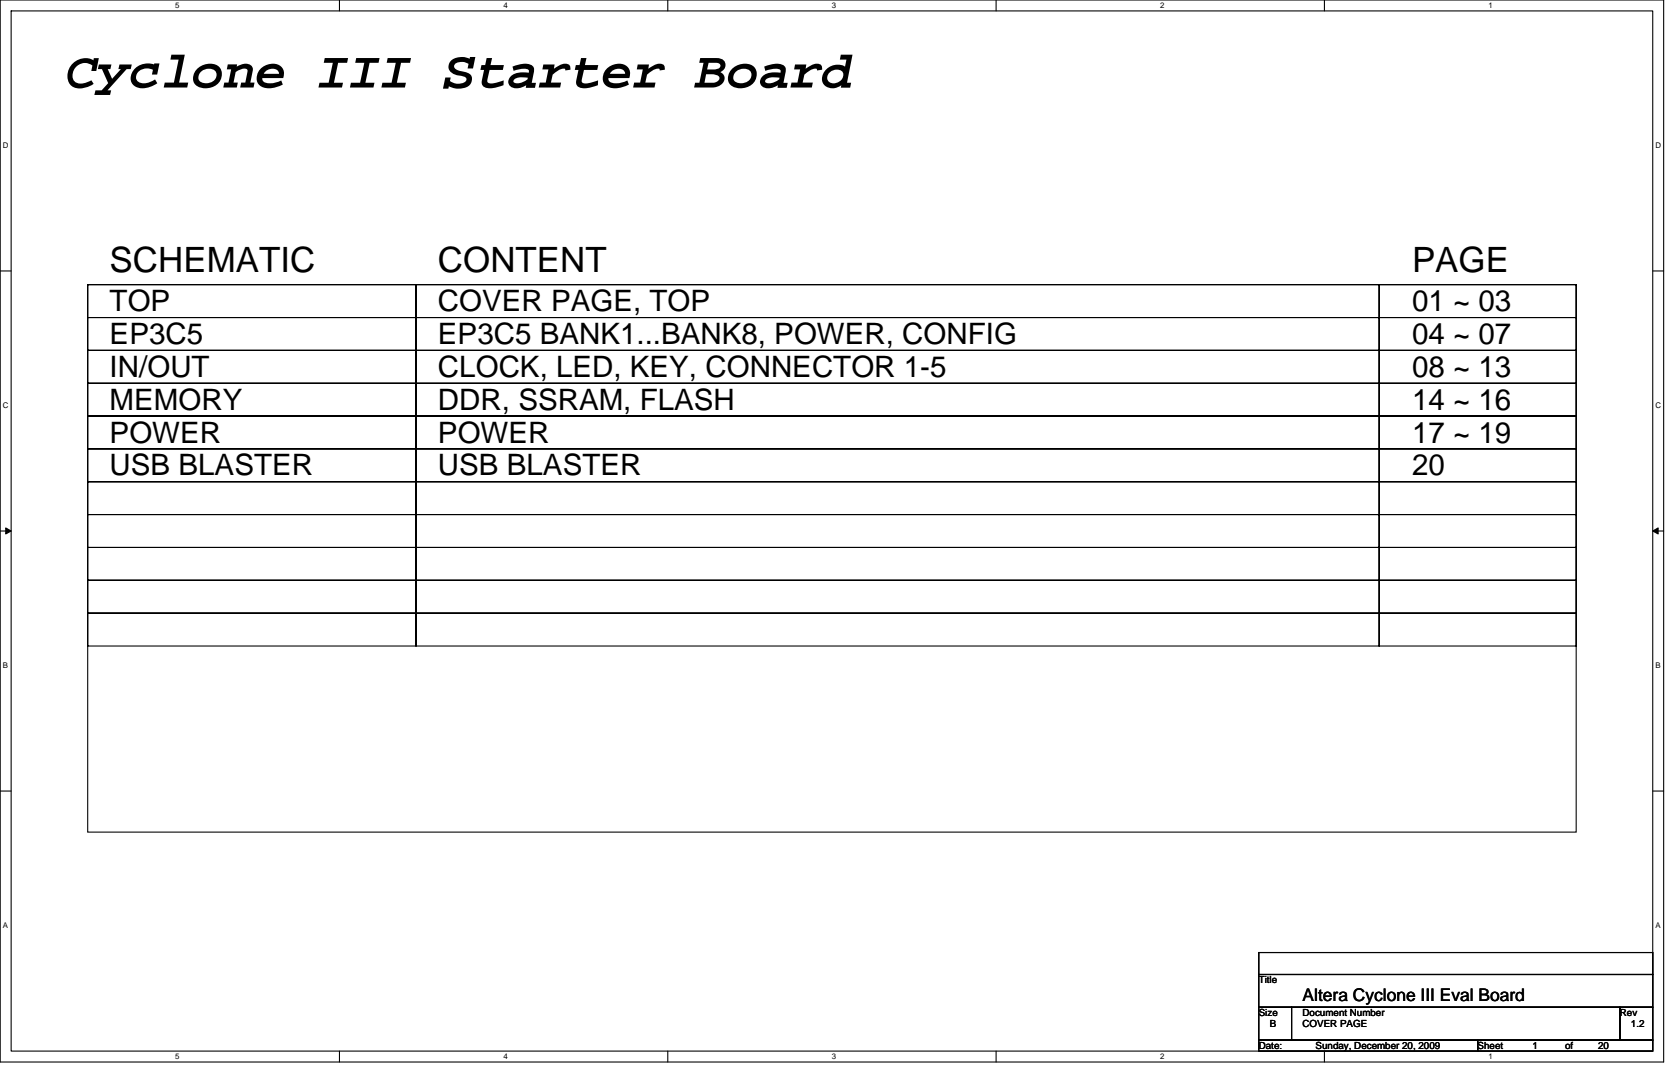
[picture p102: page 1]
SCHEMATIC; CONTENT

Cyclone III Starter Board

EP3C5 | EP3C5 BANK1...BANK8, POWER, CONFIG | 04 ~ 07
IN/OUT | CLOCK, LED, KEY, CONNECTOR 1-5 | 08 ~ 13
MEMORY | DDR, SSRAM, FLASH | 14 ~ 16
POWER | POWER | 17 ~ 19
USB BLASTER | USB BLASTER | 20

Title
Altera Cyclone III Eval Board

Size Size Size B B B | Document Number Document Number Document Number COVER PAGE COVER PAGE COVER PAGE | Rev Rev Rev 1.2 1.2 1.2

Date: Date: Date: Sunday, December 20, 2009 Sunday, December 20, 2009 Sunday, December 20, 2009 | Sheet Sheet Sheet 1 1 1 of of of 20 20 20

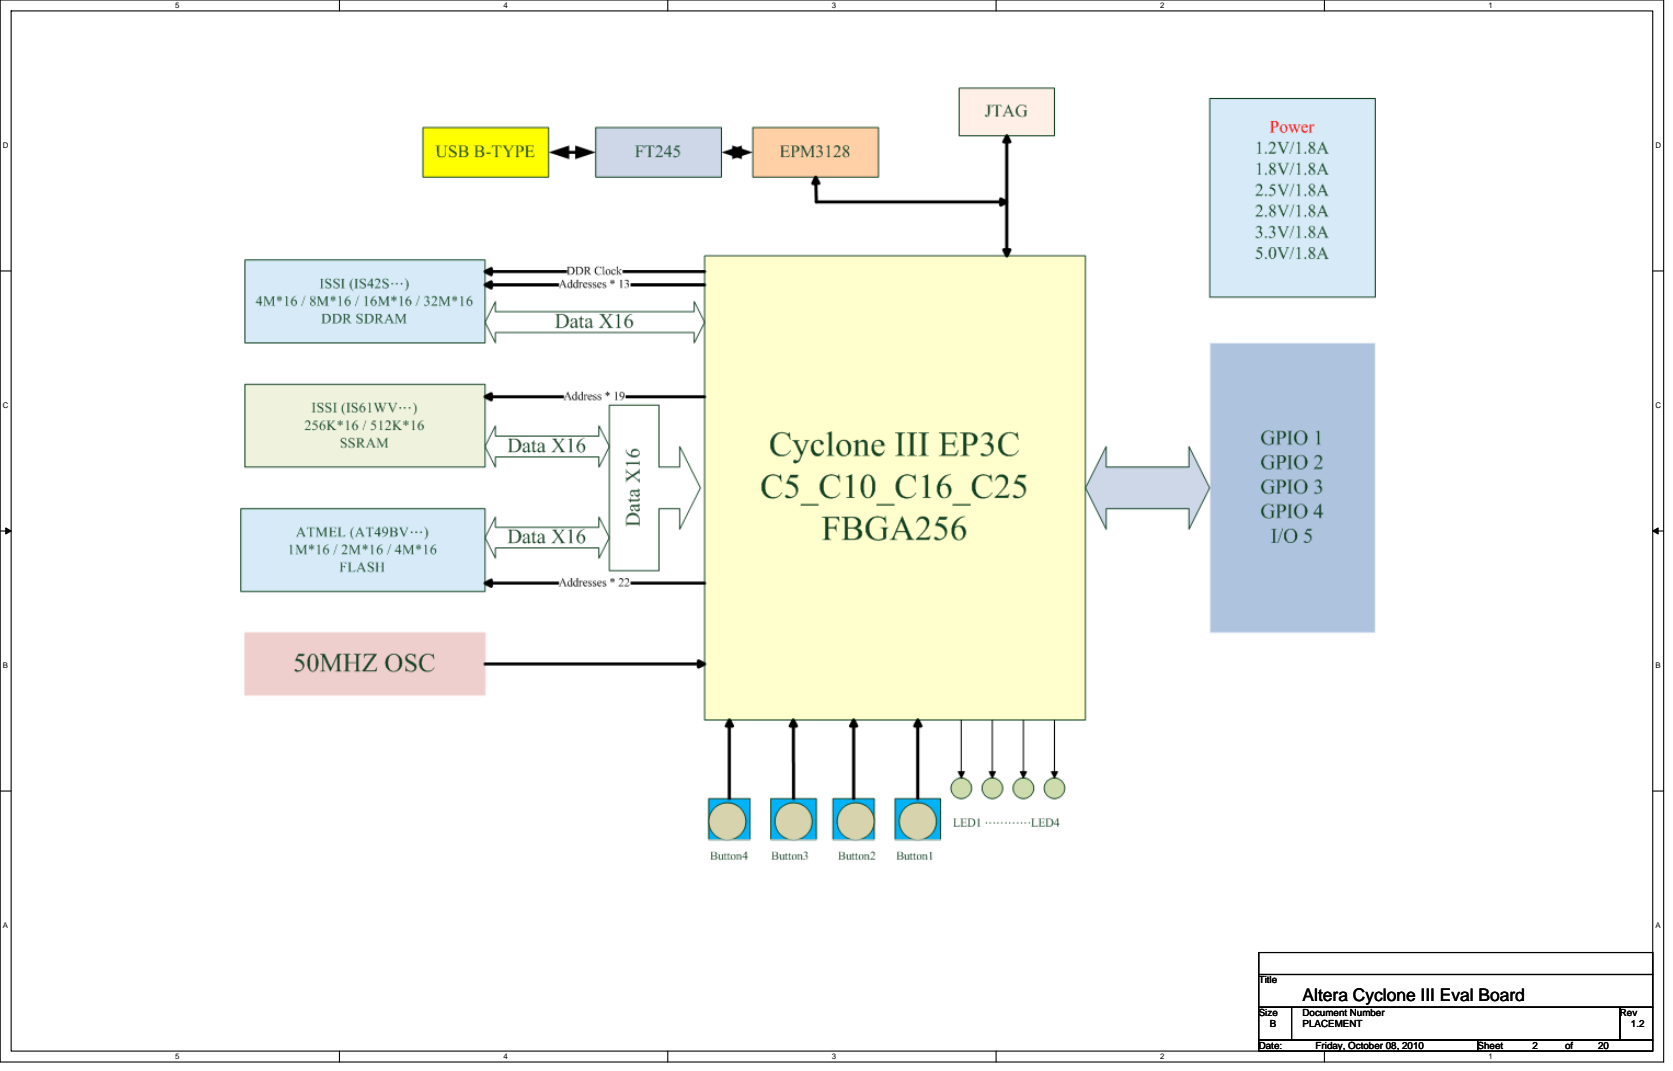
[picture p103: page 2]

Title
Altera Cyclone III Eval Board

Size Size Size B B B | Document Number Document Number Document Number PLACEMENT PLACEMENT PLACEMENT | Rev Rev Rev 1.2 1.2 1.2

Date: Date: Date: Friday, October 08, 2010 Friday, October 08, 2010 Friday, October 08, 2010 | Sheet Sheet Sheet 2 2 2 of of of 20 20 20

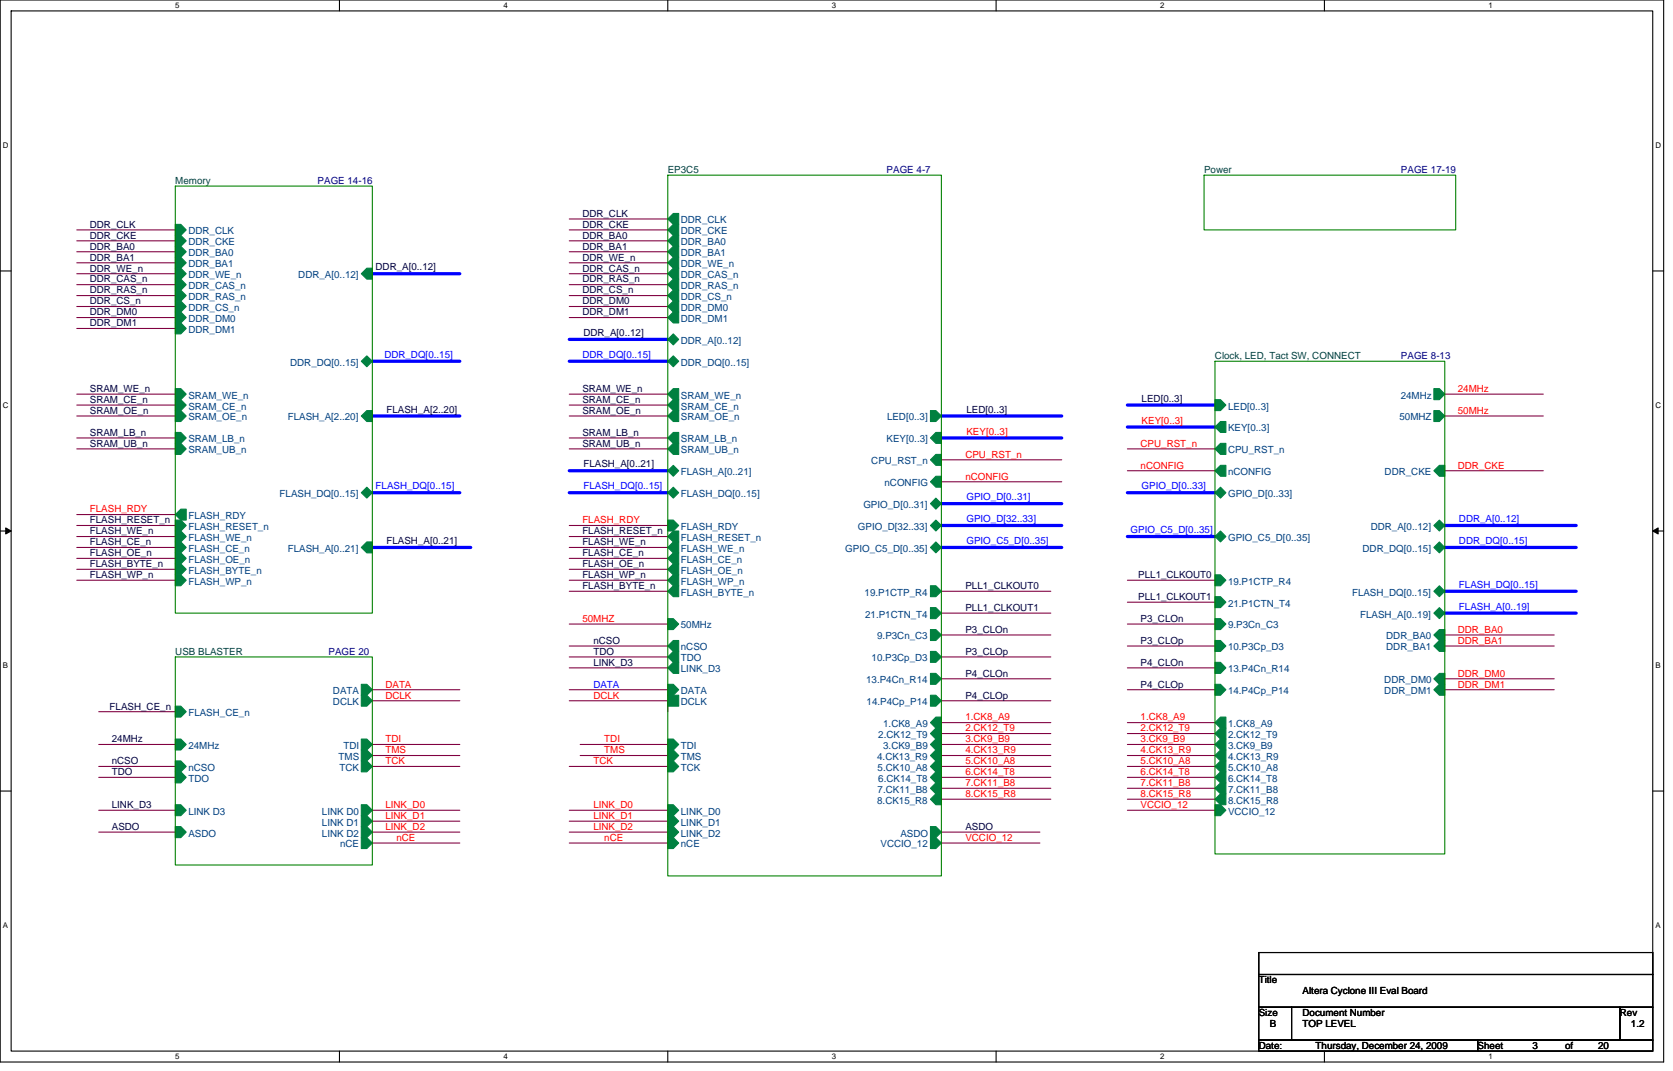
[picture p104: page 3]
DDR_CKE DDR_BA0 DDR_BA1 DDR_WE_n DDR_CAS_n DDR_RAS_n DDR_CS_n DDR_DM0 DDR_DM1; DATA DCLK; DDR_A[0..12]; SRAM_WE_n SRAM_CE_n; FLASH_A[0..21]; FLASH_RDY; FLASH_CE_n FLASH_OE_n; FLASH_RESET_n FLASH_WE_n; FLASH_CE_n; LED[0..3]; KEY[0..3]; DDR_DQ[0..15]; DDR_CLK DDR_CKE DDR_BA0 DDR_BA1; DDR_CAS_n DDR_RAS_n DDR_CS_n DDR_DM0 DDR_DM1; 50MHZ; SRAM_LB_n; FLASH_DQ[0..15]; LINK_D3; LINK_D0; LINK_D1; CPU_RST_n; FLASH_BYTE_n; DDR_CLK; DDR_WE_n; SRAM_LB_n SRAM_UB_n; SRAM_OE_n; SRAM_UB_n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

Altera Cyclone III Eval Board

Size Size Size B B B | Document Number Document Number Document Number TOP LEVEL TOP LEVEL TOP LEVEL | Rev Rev Rev 1.2 1.2 1.2

Date: Date: Date: Thursday, December 24, 2009 Thursday, December 24, 2009 Thursday, December 24, 2009 | Sheet Sheet Sheet 3 3 3 of of of 20 20 20

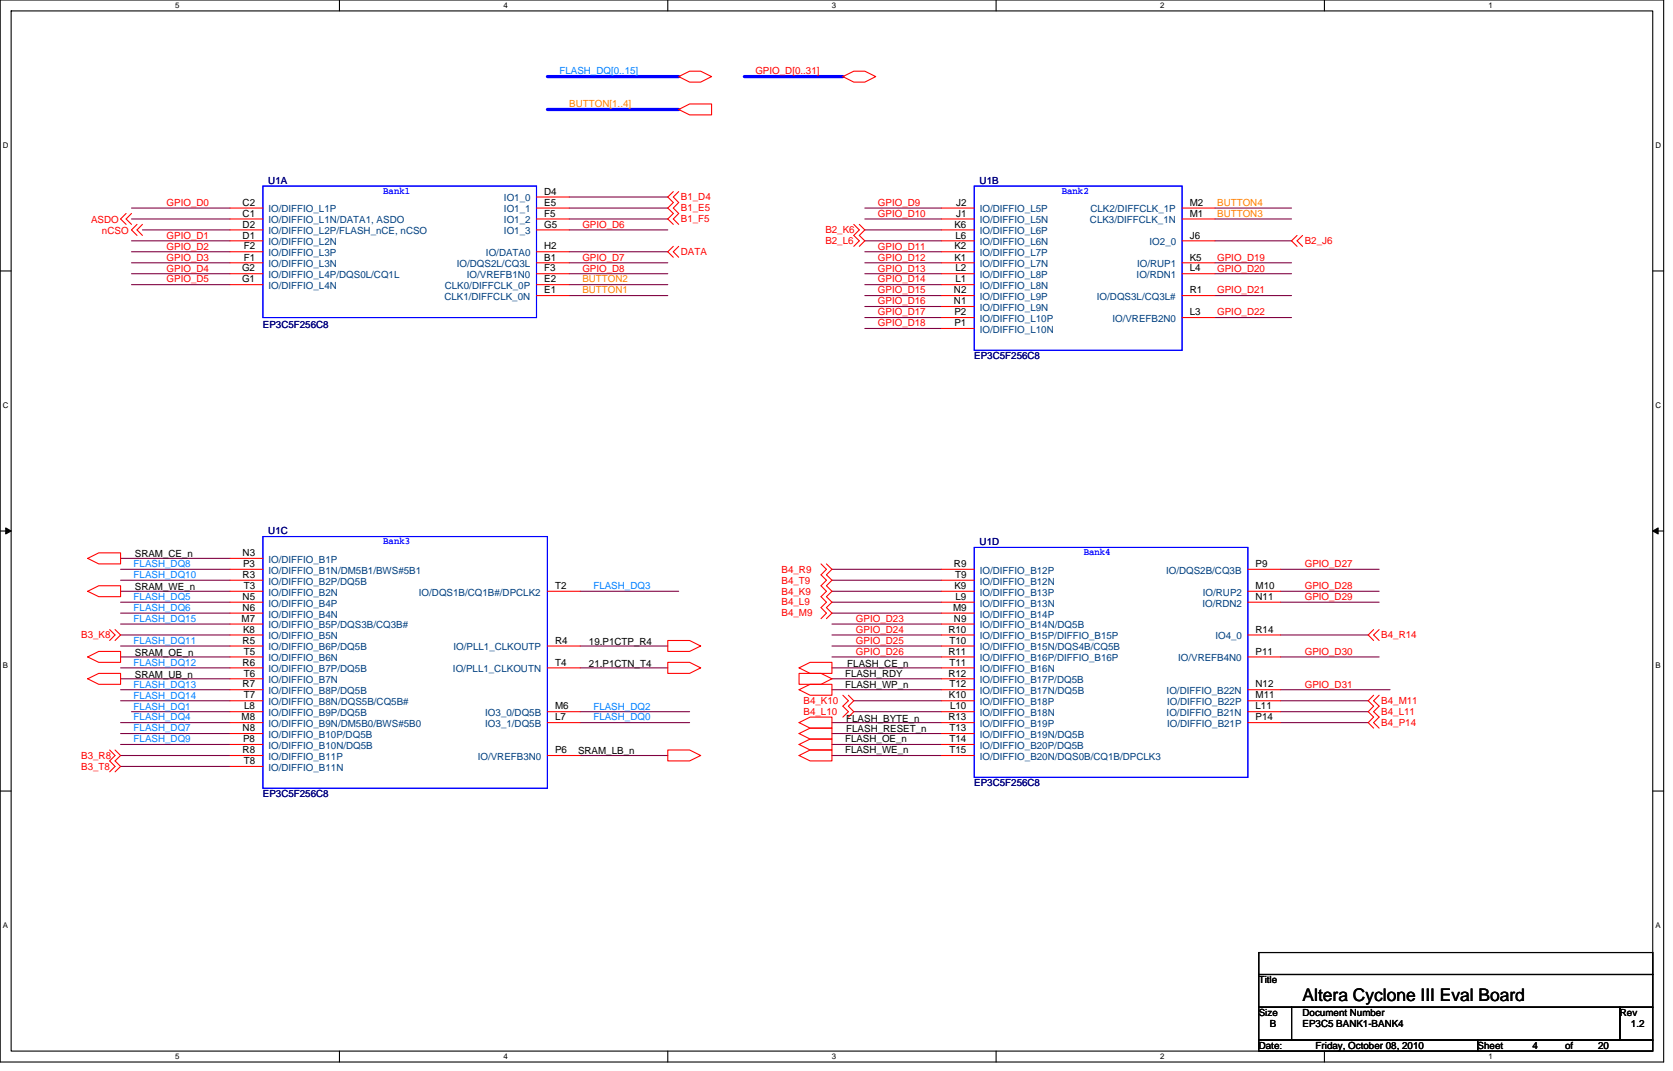
[picture p105: page 4]

Title
Altera Cyclone III Eval Board

Size Size Size B B B | Document Number Document Number Document Number EP3C5 BANK1-BANK4 EP3C5 BANK1-BANK4 EP3C5 BANK1-BANK4 | Rev Rev Rev 1.2 1.2 1.2

Date: Date: Date: Friday, October 08, 2010 Friday, October 08, 2010 Friday, October 08, 2010 | Sheet Sheet Sheet 4 4 4 of of of 20 20 20

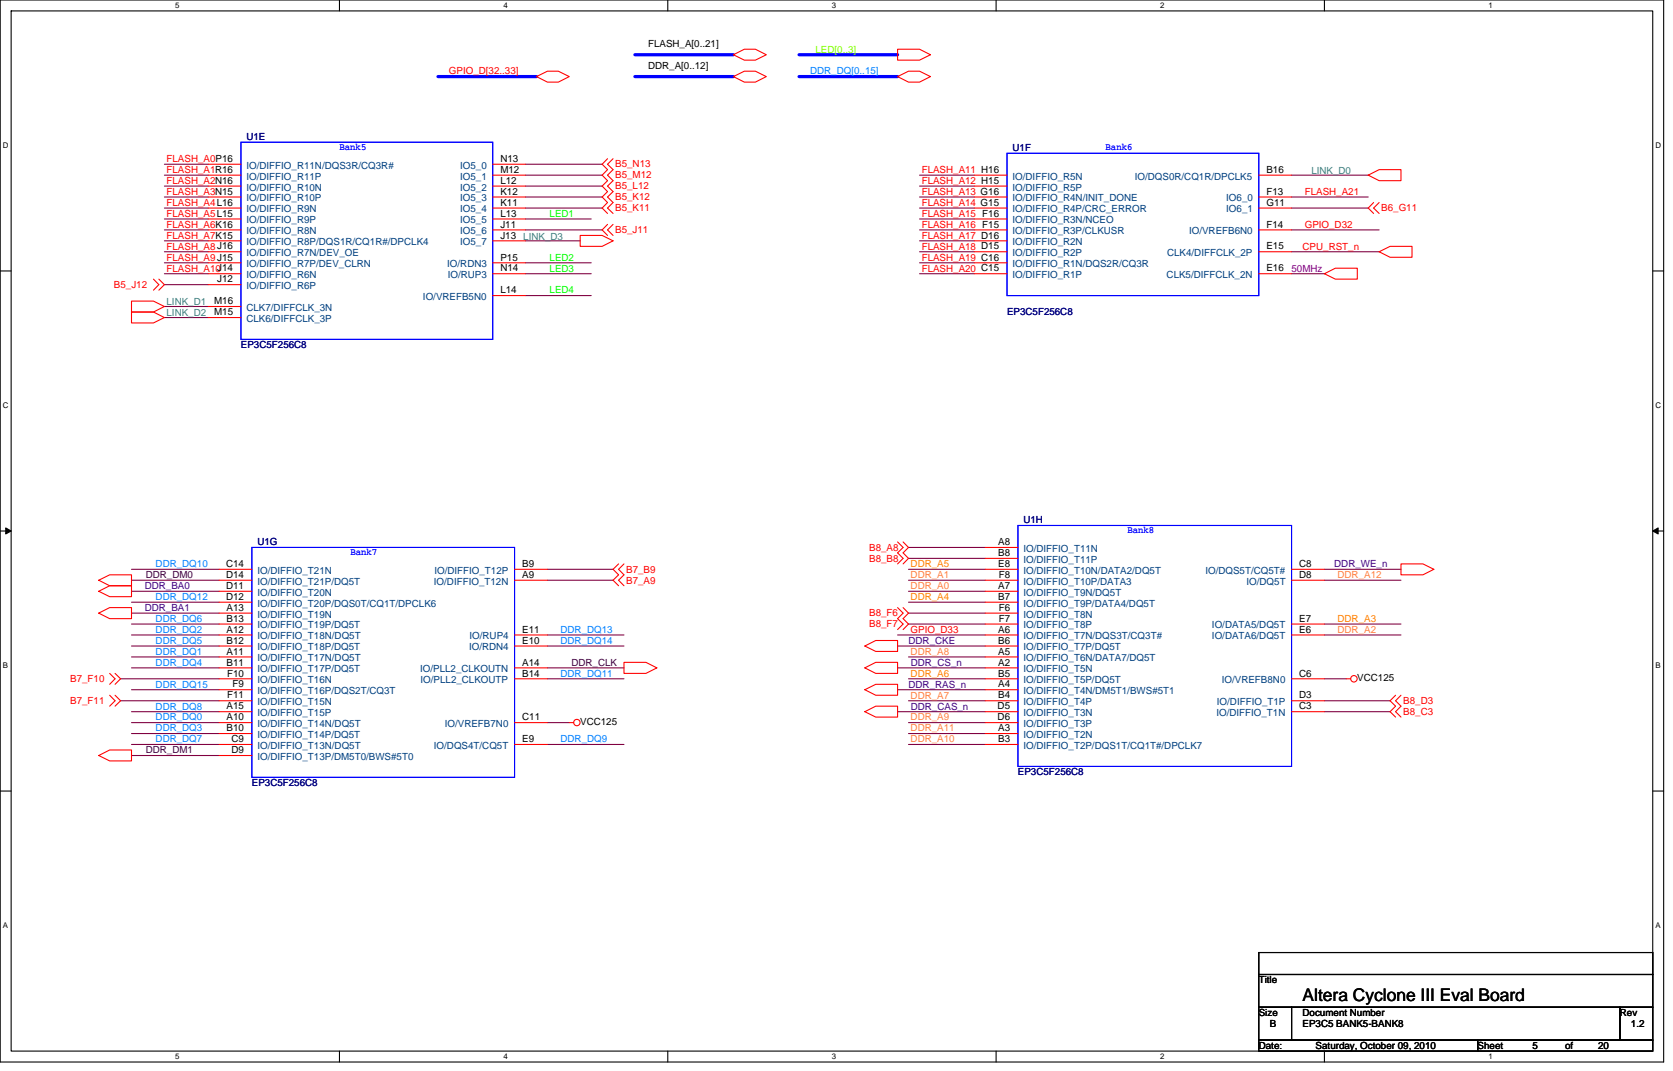
[picture p106: page 5]

Title
Altera Cyclone III Eval Board

Size Size Size B B B | Document Number Document Number Document Number EP3C5 BANK5-BANK8 EP3C5 BANK5-BANK8 EP3C5 BANK5-BANK8 | Rev Rev Rev 1.2 1.2 1.2

Date: Date: Date: Saturday, October 09, 2010 Saturday, October 09, 2010 Saturday, October 09, 2010 | Sheet Sheet Sheet 5 5 5 of of of 20 20 20

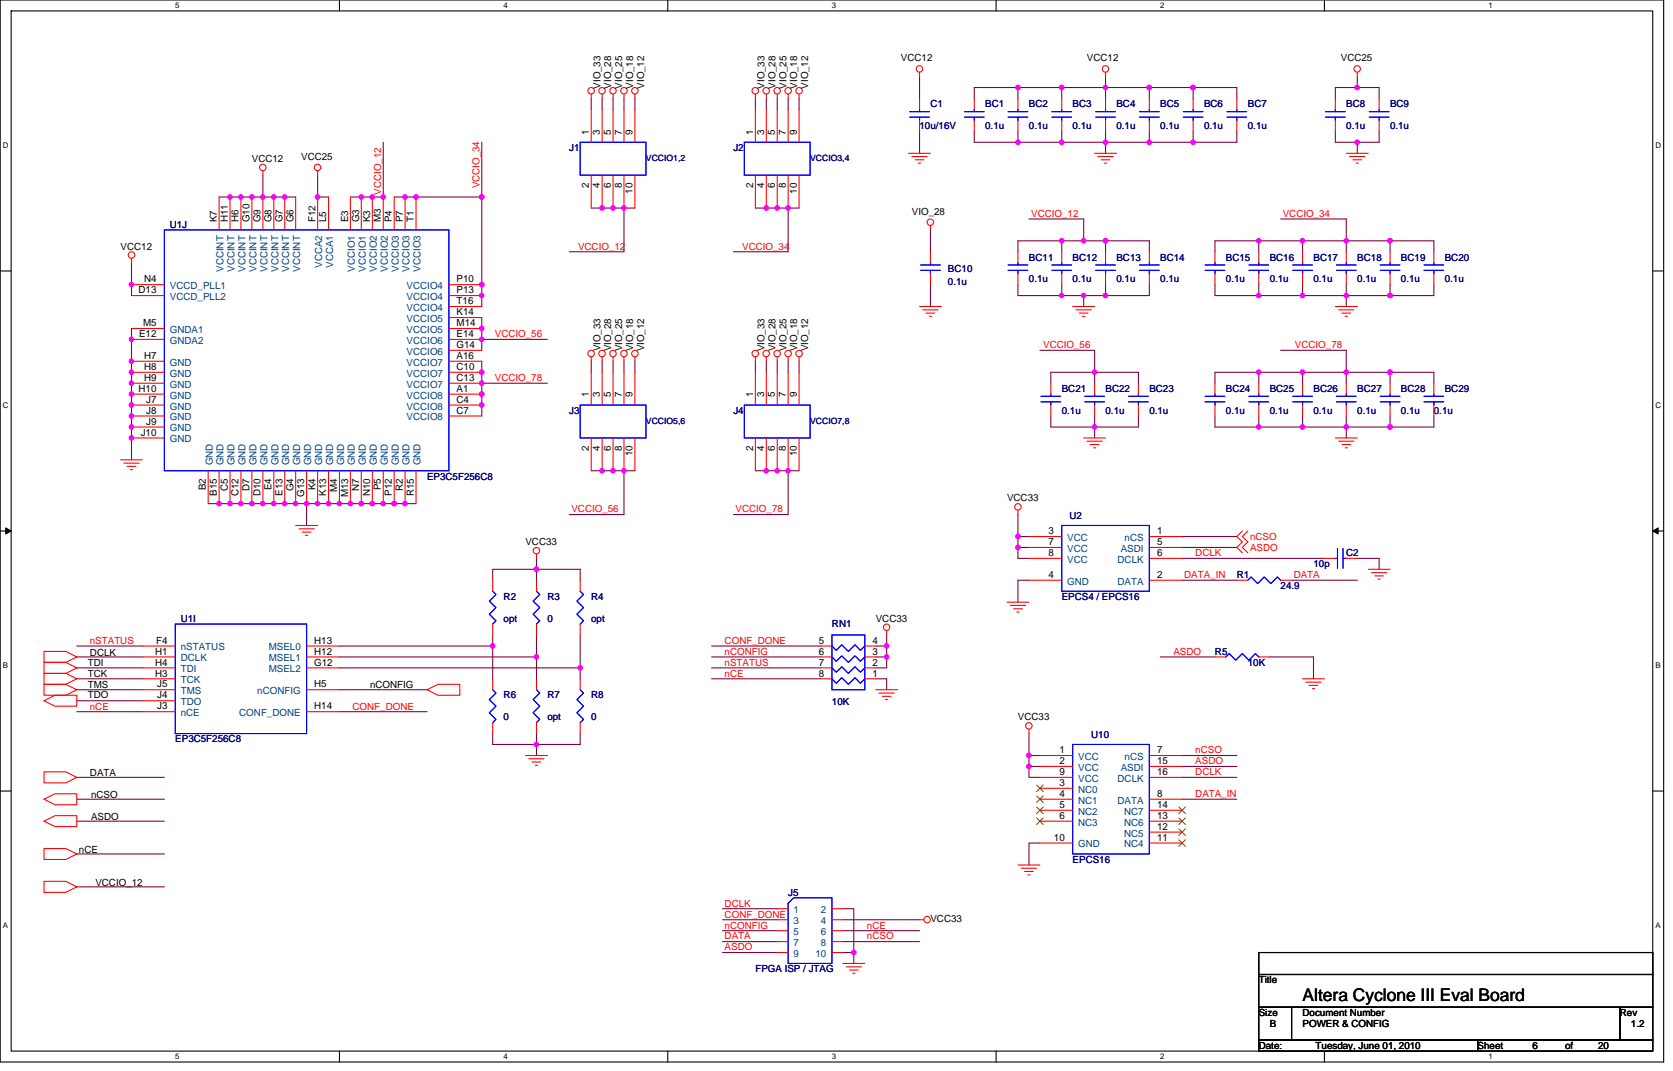
[picture p107: page 6]

Title
Altera Cyclone III Eval Board

Size Size Size B B B | Document Number Document Number Document Number POWER & CONFIG POWER & CONFIG POWER & CONFIG | Rev Rev Rev 1.2 1.2 1.2

Date: Date: Date: Tuesday, June 01, 2010 Tuesday, June 01, 2010 Tuesday, June 01, 2010 | Sheet Sheet Sheet 6 6 6 of of of 20 20 20

For C5/C10F256 | For C16F256 | For C25/F256

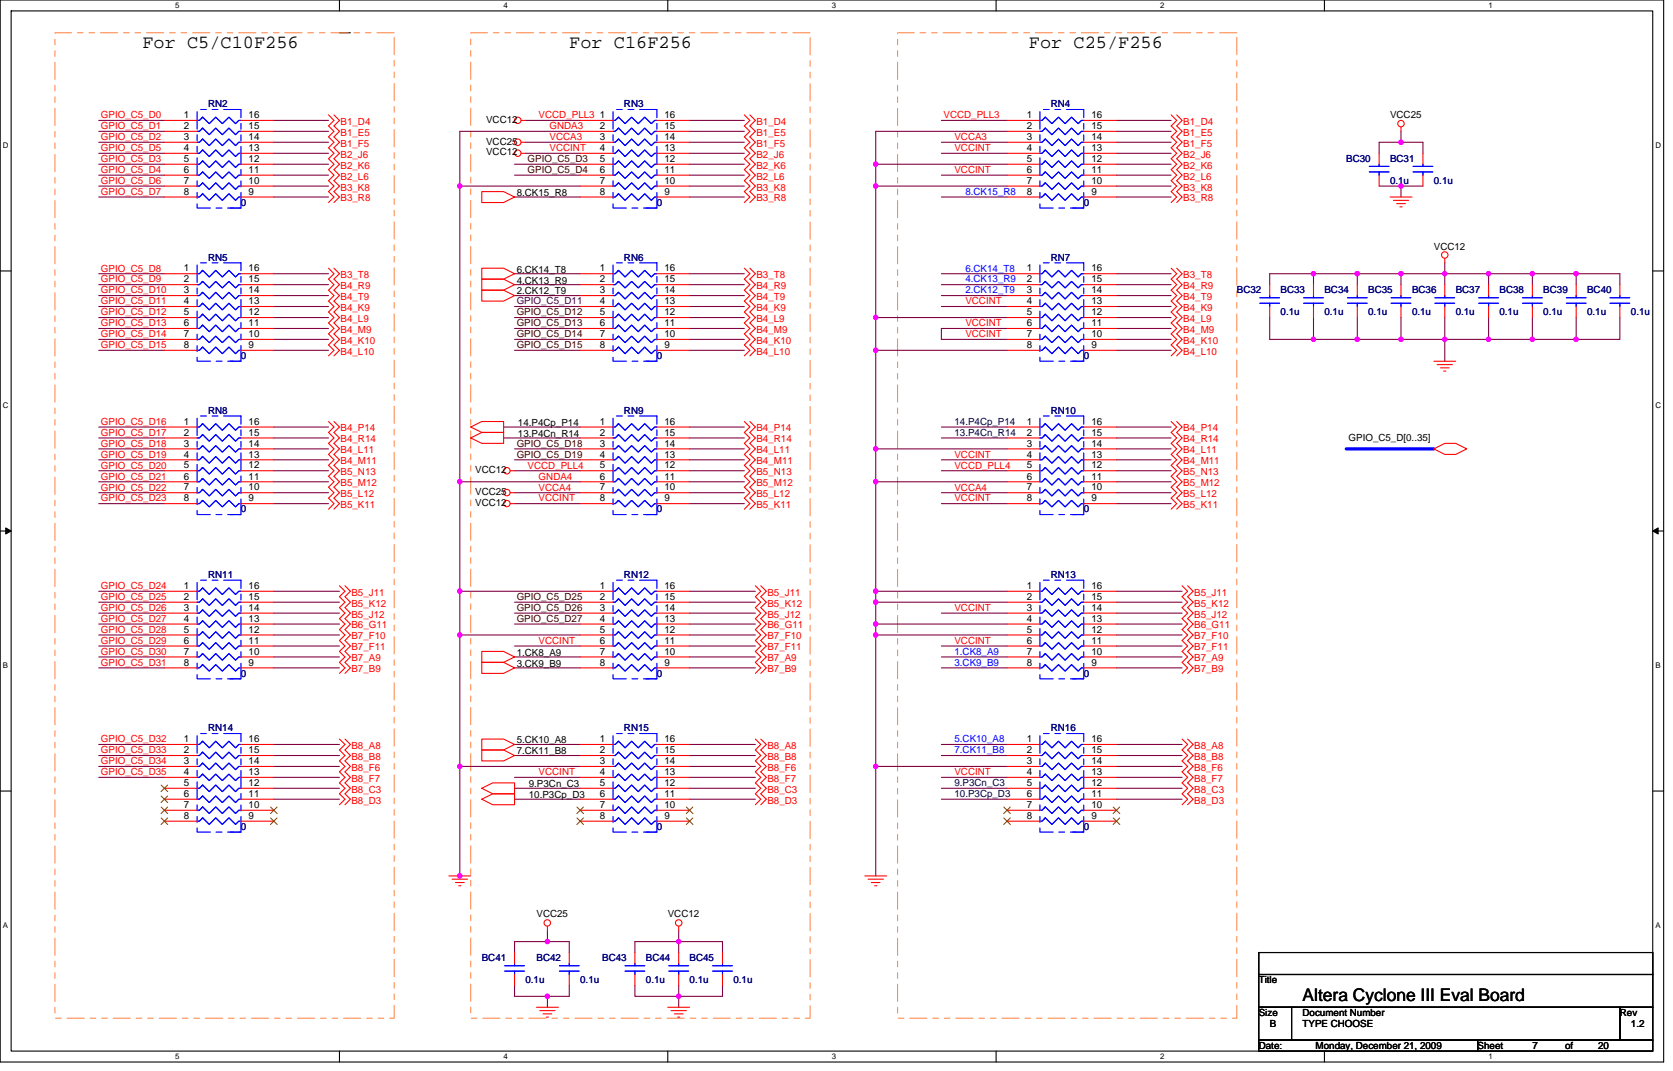
[picture p108: page 7]

Title
Altera Cyclone III Eval Board

Size Size Size B B B | Document Number Document Number Document Number TYPE CHOOSE TYPE CHOOSE TYPE CHOOSE | Rev Rev Rev 1.2 1.2 1.2

Date: Date: Date: Monday, December 21, 2009 Monday, December 21, 2009 Monday, December 21, 2009 | Sheet Sheet Sheet 7 7 7 of of of 20 20 20

## VCC33

Y1

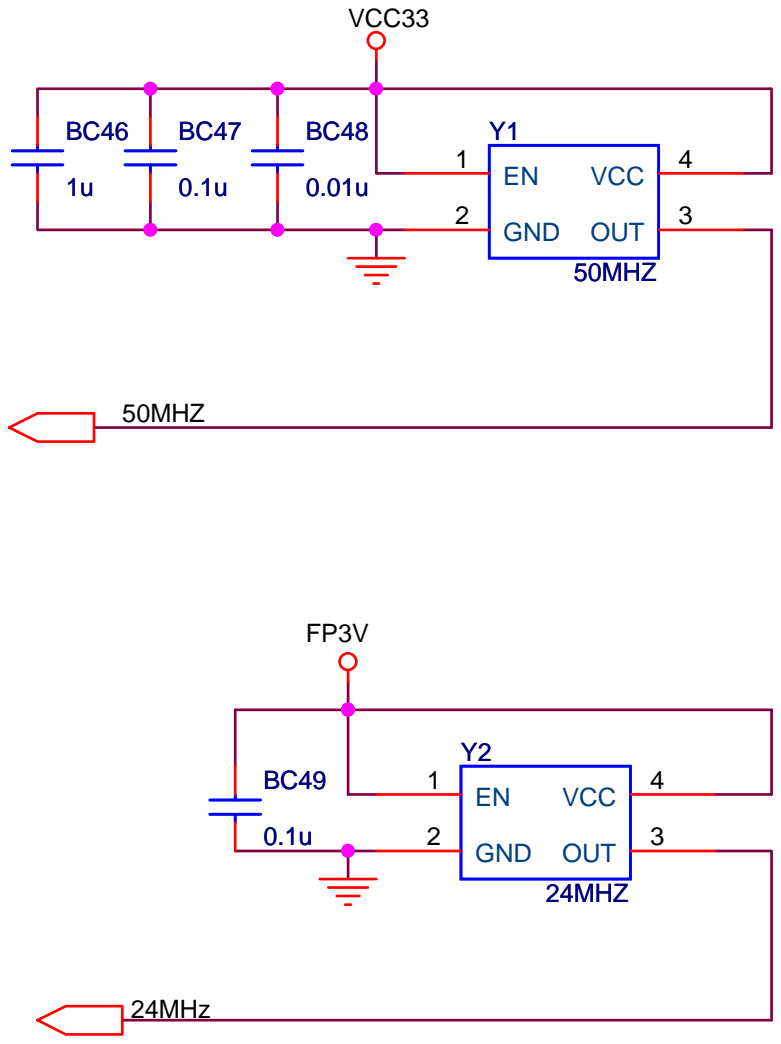
[picture p109: page 8]
50MHZ; 24MHz; VCC; OUT; 3 GND 2; 24MHZ

Title
Altera Cyclone III Eval Board

Size A | Document Number CLOCK and Level Shift CLOCK and Level Shift CLOCK and Level Shift | Rev 1.2 1.2 1.2

Date: Sunday, December 20, 2009 Sunday, December 20, 2009 Sunday, December 20, 2009 | Sheet 8 8 8 of 20 20 20

## LED1 LED2

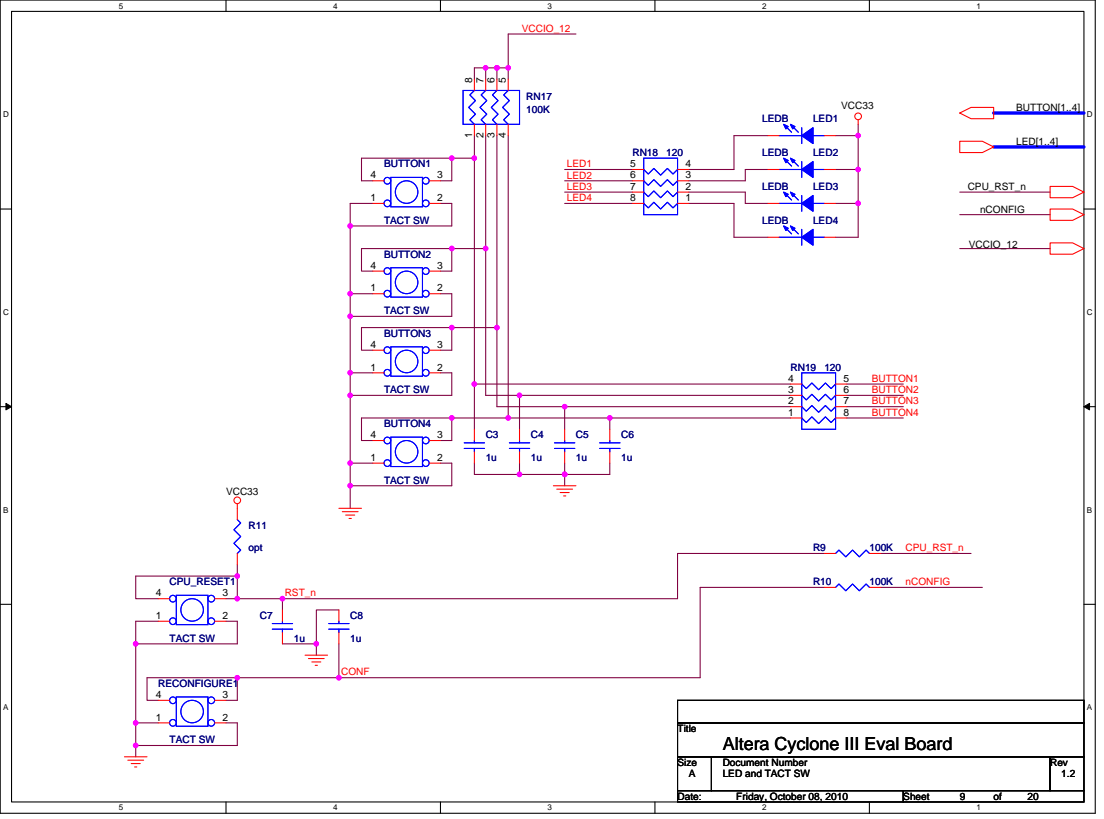
[picture p110: page 9]

3 | | 6 BUTTON2
2 | | 7 BUTTON3

Title
Altera Cyclone III Eval Board

LED and TACT SW LED and TACT SW LED and TACT SW | 1.2 1.2 1.2

Friday, October 08, 2010 Friday, October 08, 2010 Friday, October 08, 2010 | 9 9 9 20 20 20

1.C2
2.D1

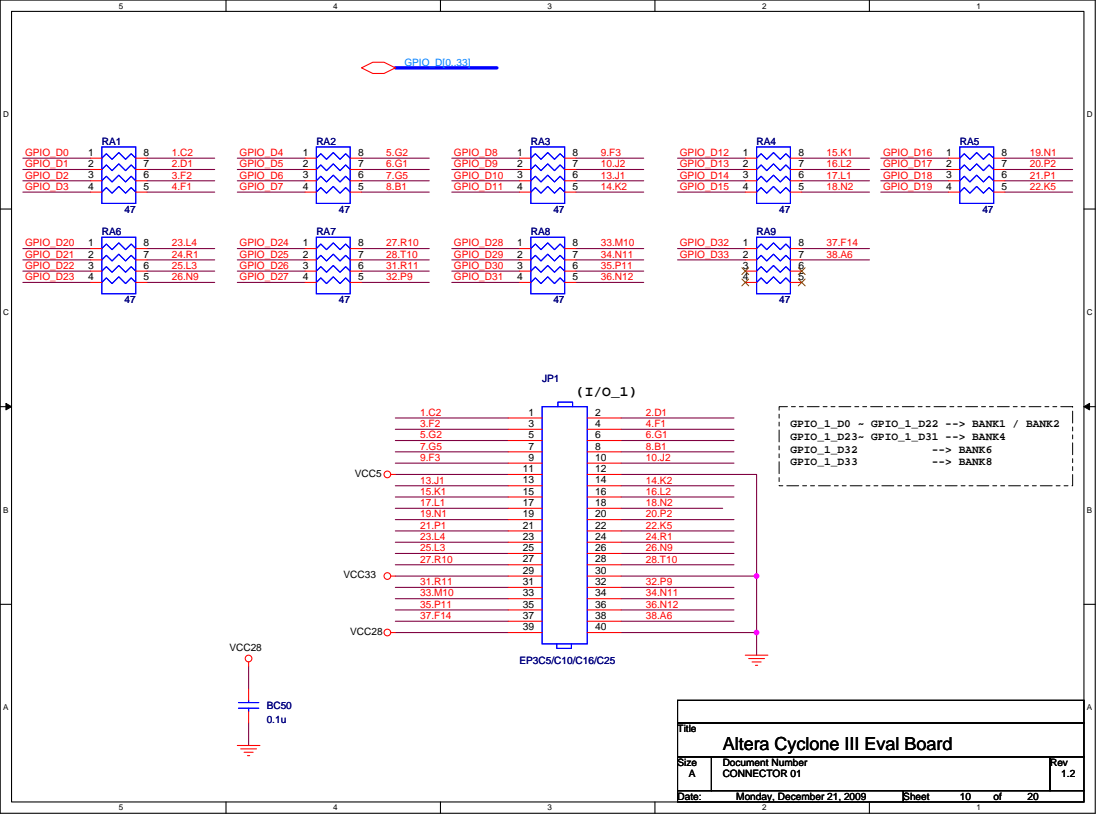
[picture p111: page 10]
GPIO_1_D0 ~ GPIO_1_D22 --> BANK1 / BANK2 GPIO_1_D23~ GPIO_1_D31 --> BANK4; GPIO_1_D32; --> BANK6; GPIO_1_D33; --> BANK8; GPIO_D0 GPIO_D1 GPIO_D2 GPIO_D3; GPIO_D4 GPIO_D5 GPIO_D6 GPIO_D7; GPIO_D8 GPIO_D9 GPIO_D10 GPIO_D11; GPIO_D16 GPIO_D17 GPIO_D18 GPIO_D19; GPIO_D20 GPIO_D21 GPIO_D22 GPIO_D23; GPIO_D12 GPIO_D13 GPIO_D14 GPIO_D15; GPIO_D28 GPIO_D29 GPIO_D30 GPIO_D31; GPIO_D32 GPIO_D33; GPIO_D24 GPIO_D25 GPIO_D26 GPIO_D27; GPIO_D[0..33]; VCC5; VCC33; VCC28

Title
Altera Cyclone III Eval Board

CONNECTOR 01 CONNECTOR 01 CONNECTOR 01 | 1.2 1.2 1.2

Monday, December 21, 2009 Monday, December 21, 2009 Monday, December 21, 2009 | 10 10 10 20 20 20

5.L16
6.L15

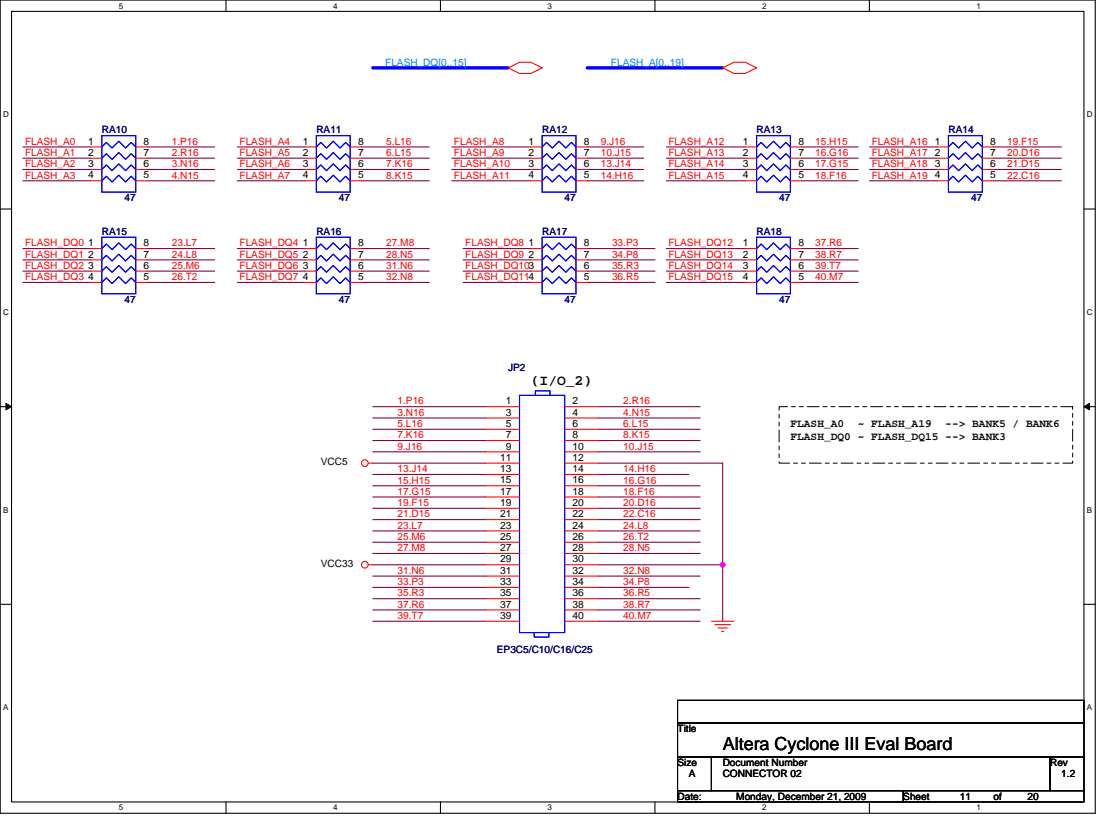
[picture p112: page 11]
FLASH_A0 ~ FLASH_A19 --> BANK5 / BANK6 FLASH_DQ0 ~ FLASH_DQ15 --> BANK3; FLASH_A4 FLASH_A5 FLASH_A6 FLASH_A7; FLASH_A8 FLASH_A9 FLASH_A10 FLASH_A11; FLASH_A16 FLASH_A17 FLASH_A18 FLASH_A19; FLASH_DQ0 FLASH_DQ1 FLASH_DQ2 FLASH_DQ3; FLASH_A12 FLASH_A13 FLASH_A14 FLASH_A15; FLASH_DQ8 FLASH_DQ9 FLASH_DQ10 FLASH_DQ11; FLASH_DQ12 FLASH_DQ13 FLASH_DQ14 FLASH_DQ15; FLASH_DQ4 FLASH_DQ5 FLASH_DQ6 FLASH_DQ7; FLASH_A0 FLASH_A1 FLASH_A2 FLASH_A3; FLASH_DQ[0..15]; FLASH_A[0..19]; VCC5; VCC33

Title
Altera Cyclone III Eval Board

CONNECTOR 02 CONNECTOR 02 CONNECTOR 02 | 1.2 1.2 1.2

Monday, December 21, 2009 Monday, December 21, 2009 Monday, December 21, 2009 | 11 11 11 20 20 20

1.D4
2.E5

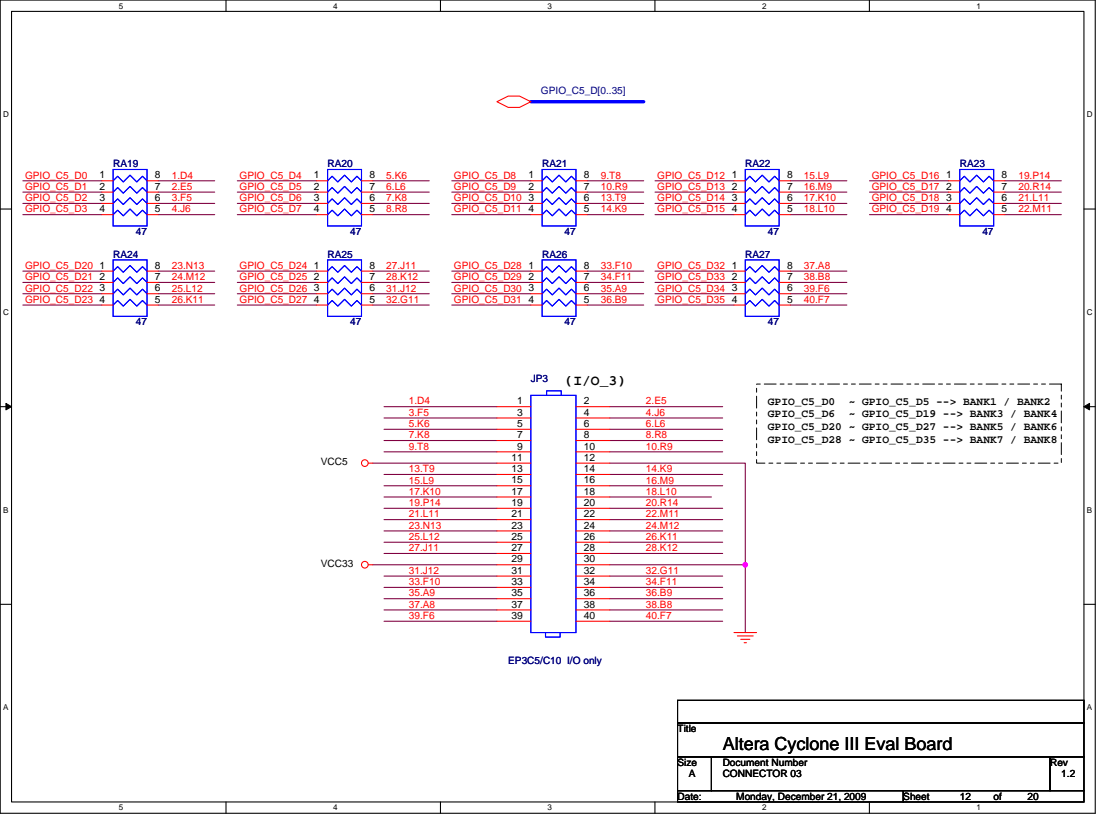
[picture p113: page 12]
GPIO_C5_D0 ~ GPIO_C5_D5 --> BANK1 / BANK2 GPIO_C5_D6 ~ GPIO_C5_D19 --> BANK3 / BANK4 GPIO_C5_D20 ~ GPIO_C5_D27 --> BANK5 / BANK6 GPIO_C5_D28 ~ GPIO_C5_D35 --> BANK7 / BANK8; GPIO_C5_D0 GPIO_C5_D1 GPIO_C5_D2 GPIO_C5_D3; GPIO_C5_D4 GPIO_C5_D5 GPIO_C5_D6 GPIO_C5_D7; GPIO_C5_D8 GPIO_C5_D9 GPIO_C5_D10 GPIO_C5_D11; GPIO_C5_D12 GPIO_C5_D13 GPIO_C5_D14 GPIO_C5_D15; GPIO_C5_D16 GPIO_C5_D17 GPIO_C5_D18 GPIO_C5_D19; GPIO_C5_D20 GPIO_C5_D21 GPIO_C5_D22 GPIO_C5_D23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

Title
Altera Cyclone III Eval Board

CONNECTOR 03 CONNECTOR 03 CONNECTOR 03 | 1.2 1.2 1.2

Monday, December 21, 2009 Monday, December 21, 2009 Monday, December 21, 2009 | 12 12 12 20 20 20

15.D8
16.A10

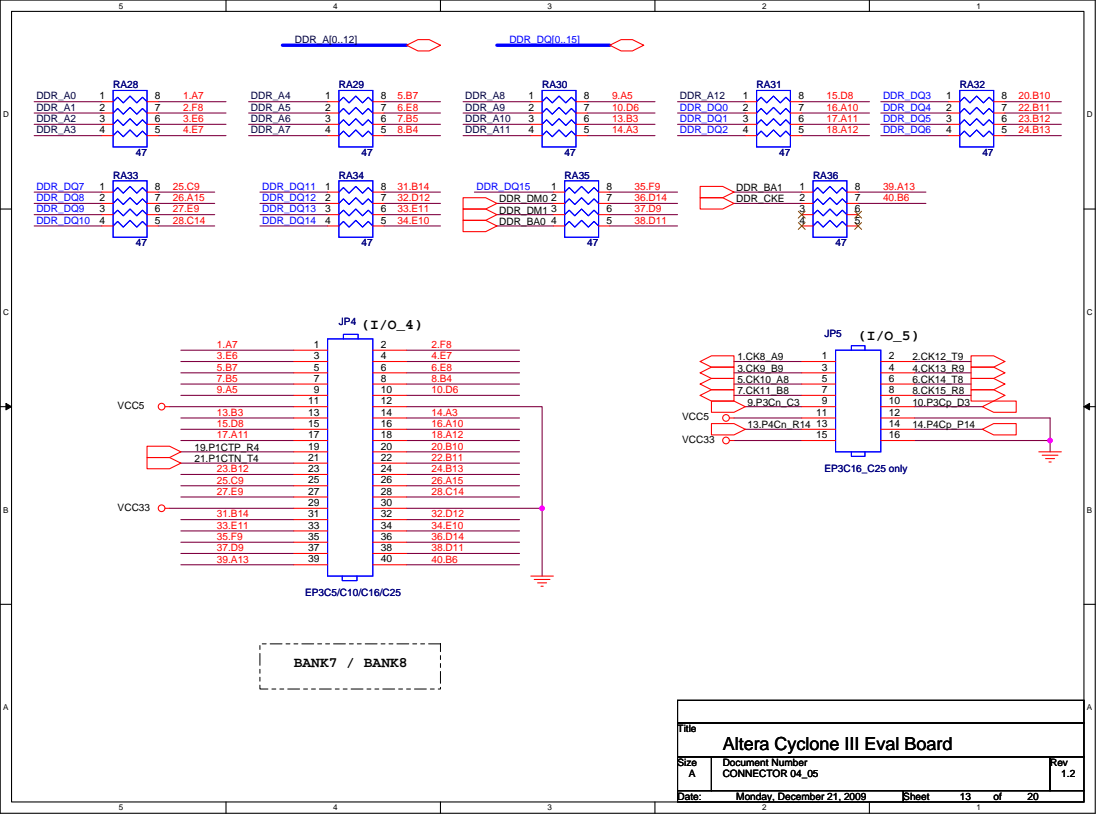
[picture p114: page 13]
BANK7 / BANK8; DDR_A12 DDR_DQ0 DDR_DQ1 DDR_DQ2; DDR_DQ3 DDR_DQ4 DDR_DQ5 DDR_DQ6; DDR_A4 DDR_A5 DDR_A6 DDR_A7; DDR_A0 DDR_A1 DDR_A2 DDR_A3; DDR_A8 DDR_A9 DDR_A10 DDR_A11; DDR_DQ11 DDR_DQ12 DDR_DQ13 DDR_DQ14; DDR_DQ7 DDR_DQ8 DDR_DQ9 DDR_DQ10; DDR_DQ15; 19.P1CTP_R4 21.P1CTN_T4; DDR_A[0..12]; DDR_DQ[0..15]; DDR_CKE; DDR_BA1; DDR_DM0 DDR_DM1 DDR_BA0; VCC5; VCC33; EP3C16_C25 only

Title
Altera Cyclone III Eval Board

CONNECTOR 04_05 CONNECTOR 04_05 CONNECTOR 04_05 | 1.2 1.2 1.2

Monday, December 21, 2009 Monday, December 21, 2009 Monday, December 21, 2009 | 13 13 13 20 20 20

## DDR_A0 DDR_A1

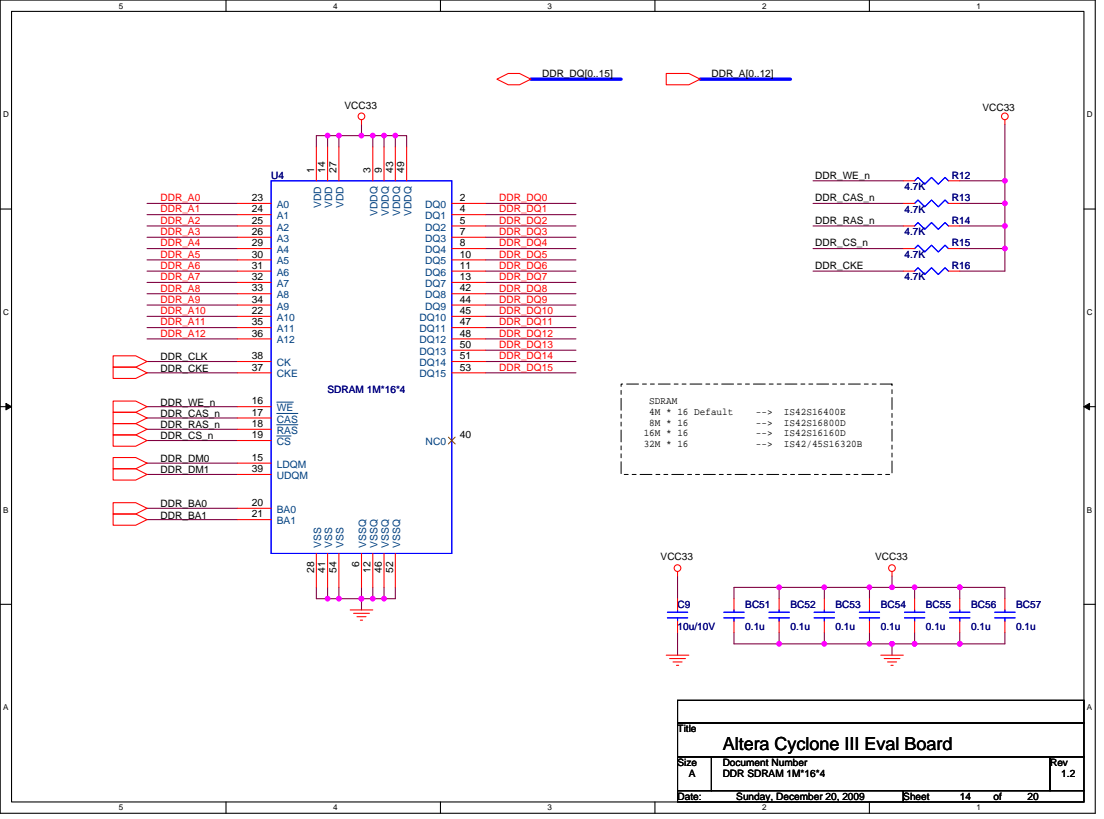
[picture p115: page 14]
SDRAM; 4M * 16 Default; DDR_A2 DDR_A3 DDR_A4 DDR_A5 DDR_A6 DDR_A7 DDR_A8 DDR_A9 DDR_A10 DDR_A11 DDR_A12; DDR_DQ0 DDR_DQ1 DDR_DQ2 DDR_DQ3 DDR_DQ4 DDR_DQ5 DDR_DQ6 DDR_DQ7 DDR_DQ8 DDR_DQ9 DDR_DQ10 DDR_DQ11 DDR_DQ12 DDR_DQ13 DDR_DQ14 DDR_DQ15; DDR_WE_n; DDR_CAS_n; DDR_RAS_n; DDR_CS_n; DDR_CKE; DDR_DQ[0..15]; DDR_A[0..12]; DDR_CLK DDR_CKE; DDR_WE_n DDR_CAS_n DDR_RAS_n DDR_CS_n; DDR_BA0 DDR_BA1; DDR_DM0 DDR_DM1; VCC33; SDRAM 1M*16*4; VDD; VDD 14; VDD 27; VDDQ; VDDQ 43; VDDQ 49; VSS 28; VSS 41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

Title
Altera Cyclone III Eval Board

DDR SDRAM 1M*16*4 DDR SDRAM 1M*16*4 DDR SDRAM 1M*16*4 | 1.2 1.2 1.2

Sunday, December 20, 2009 Sunday, December 20, 2009 Sunday, December 20, 2009 | 14 14 14 20 20 20

## Place these terminations in the middle of the line

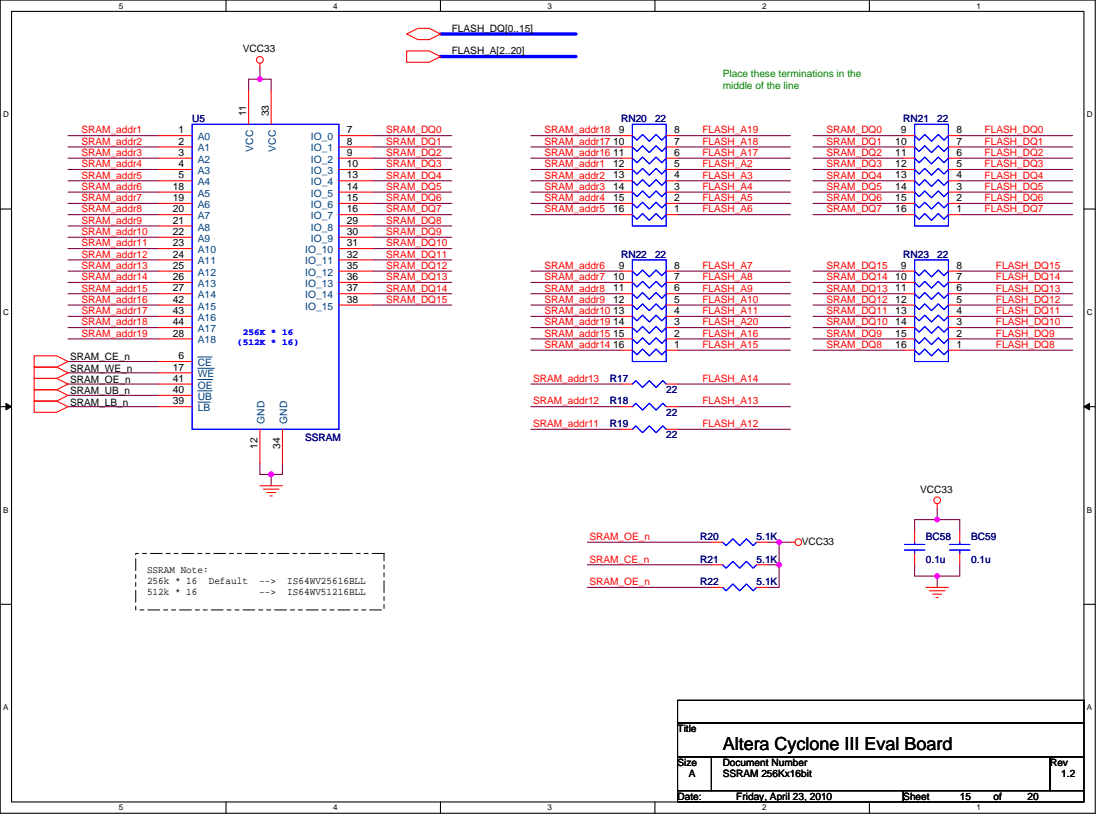
[picture p116: page 15]

Title
Altera Cyclone III Eval Board

SSRAM 256Kx16bit SSRAM 256Kx16bit SSRAM 256Kx16bit | 1.2 1.2 1.2

Friday, April 23, 2010 Friday, April 23, 2010 Friday, April 23, 2010 | 15 15 15 20 20 20

## FLASH_A0 FLASH_A1

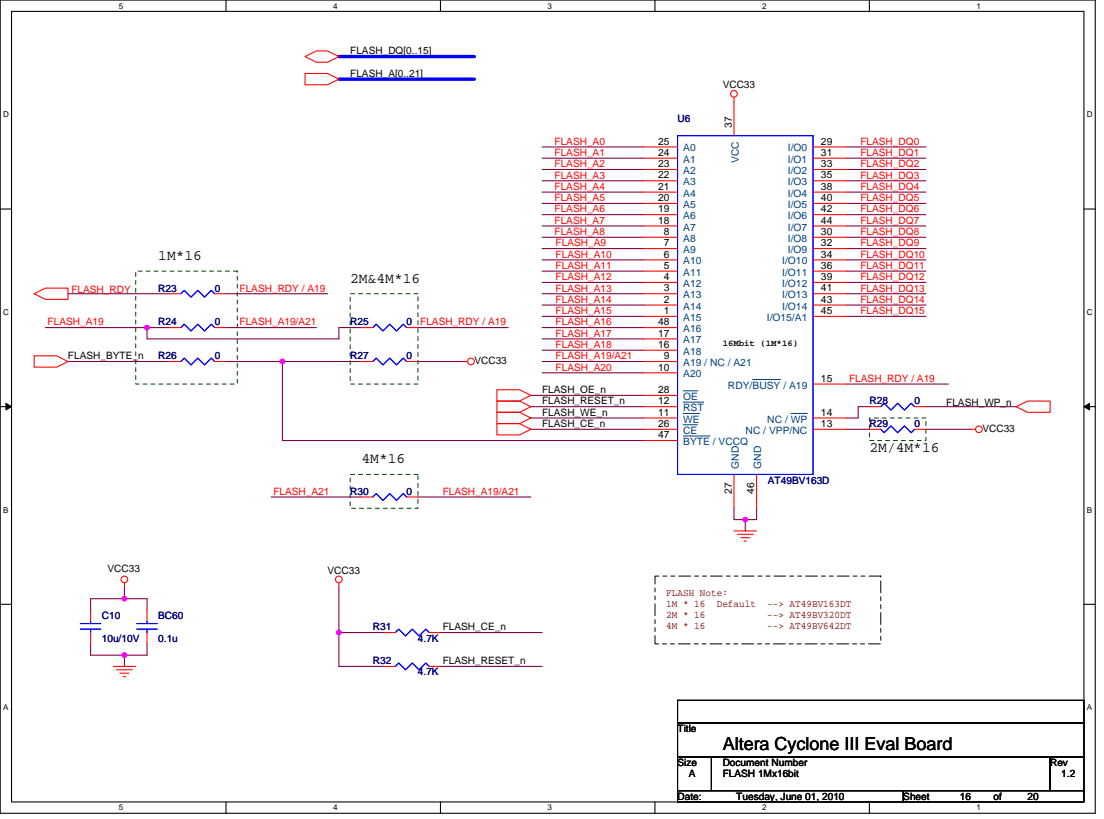
[picture p117: page 16]

Title
Altera Cyclone III Eval Board

FLASH 1Mx16bit FLASH 1Mx16bit FLASH 1Mx16bit | 1.2 1.2 1.2

Tuesday, June 01, 2010 Tuesday, June 01, 2010 Tuesday, June 01, 2010 | 16 16 16 20 20 20

2.5V/1.8A

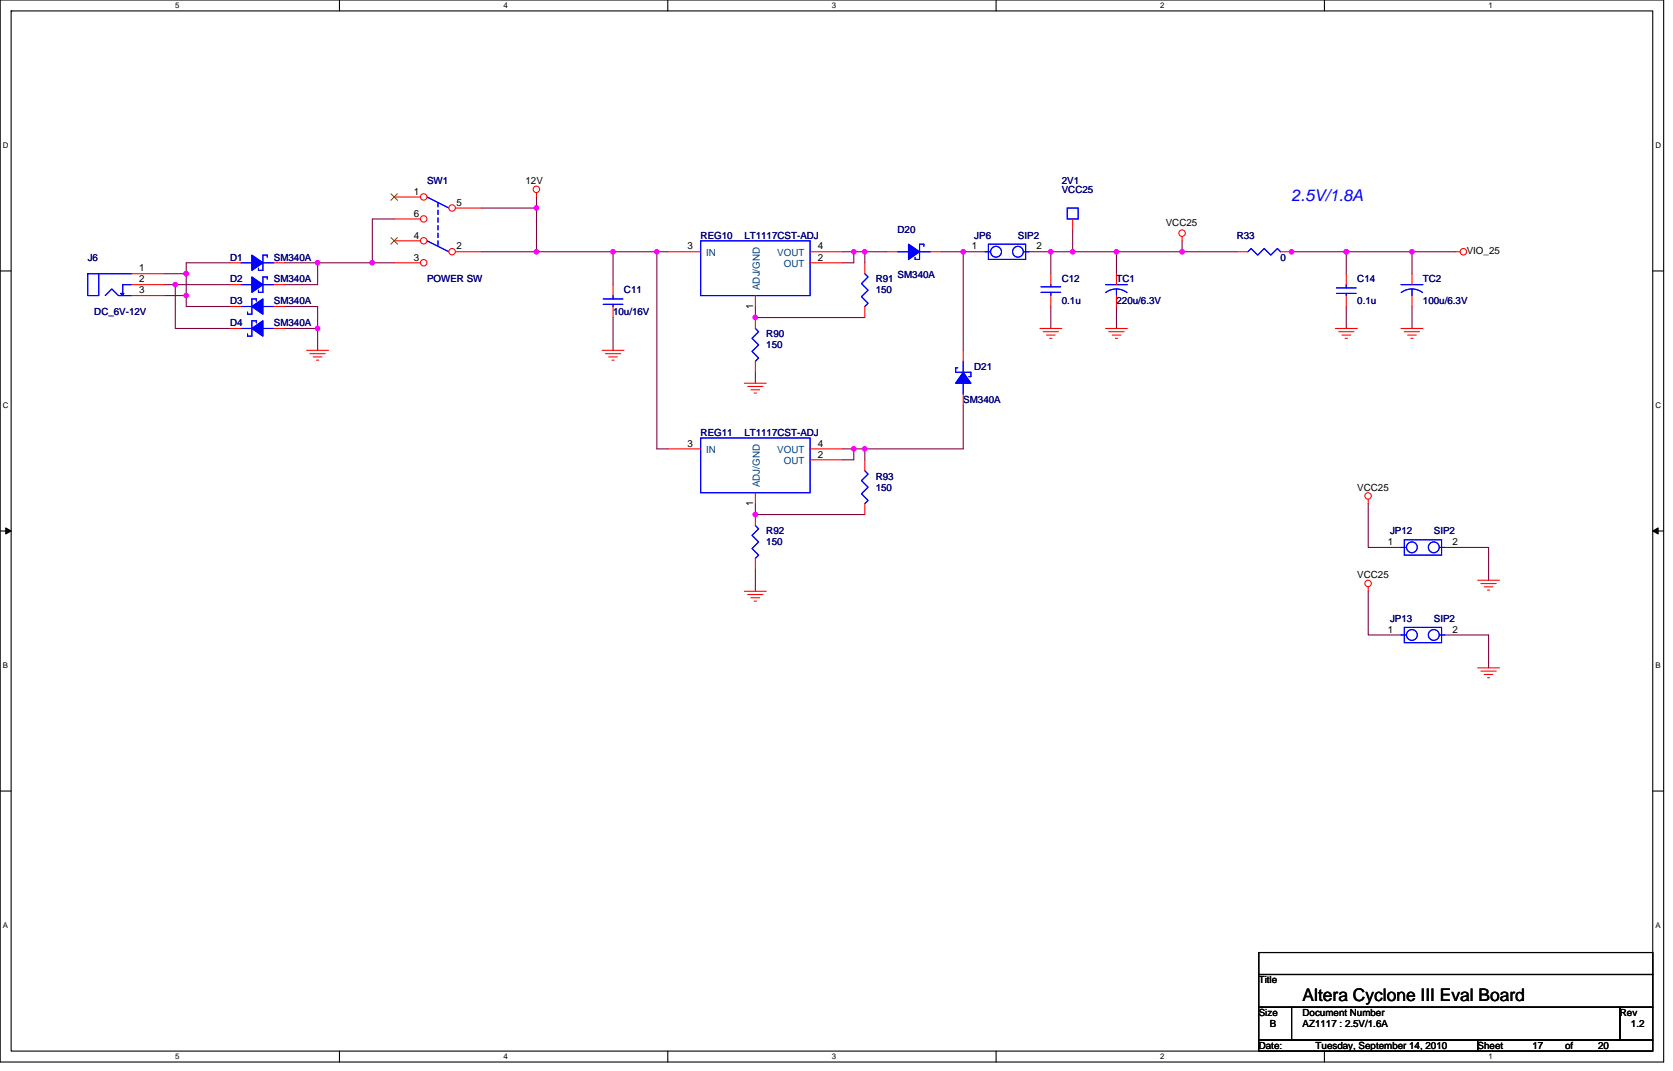
[picture p118: page 17]

Title
Altera Cyclone III Eval Board

Size Size Size B B B | Document Number Document Number Document Number AZ1117 : 2.5V/1.6A AZ1117 : 2.5V/1.6A AZ1117 : 2.5V/1.6A | Rev Rev Rev 1.2 1.2 1.2

Date: Date: Date: Tuesday, September 14, 2010 Tuesday, September 14, 2010 Tuesday, September 14, 2010 | Sheet Sheet Sheet 17 17 17 of of of 20 20 20

3.3V/1.8A

1.8V/1.8A

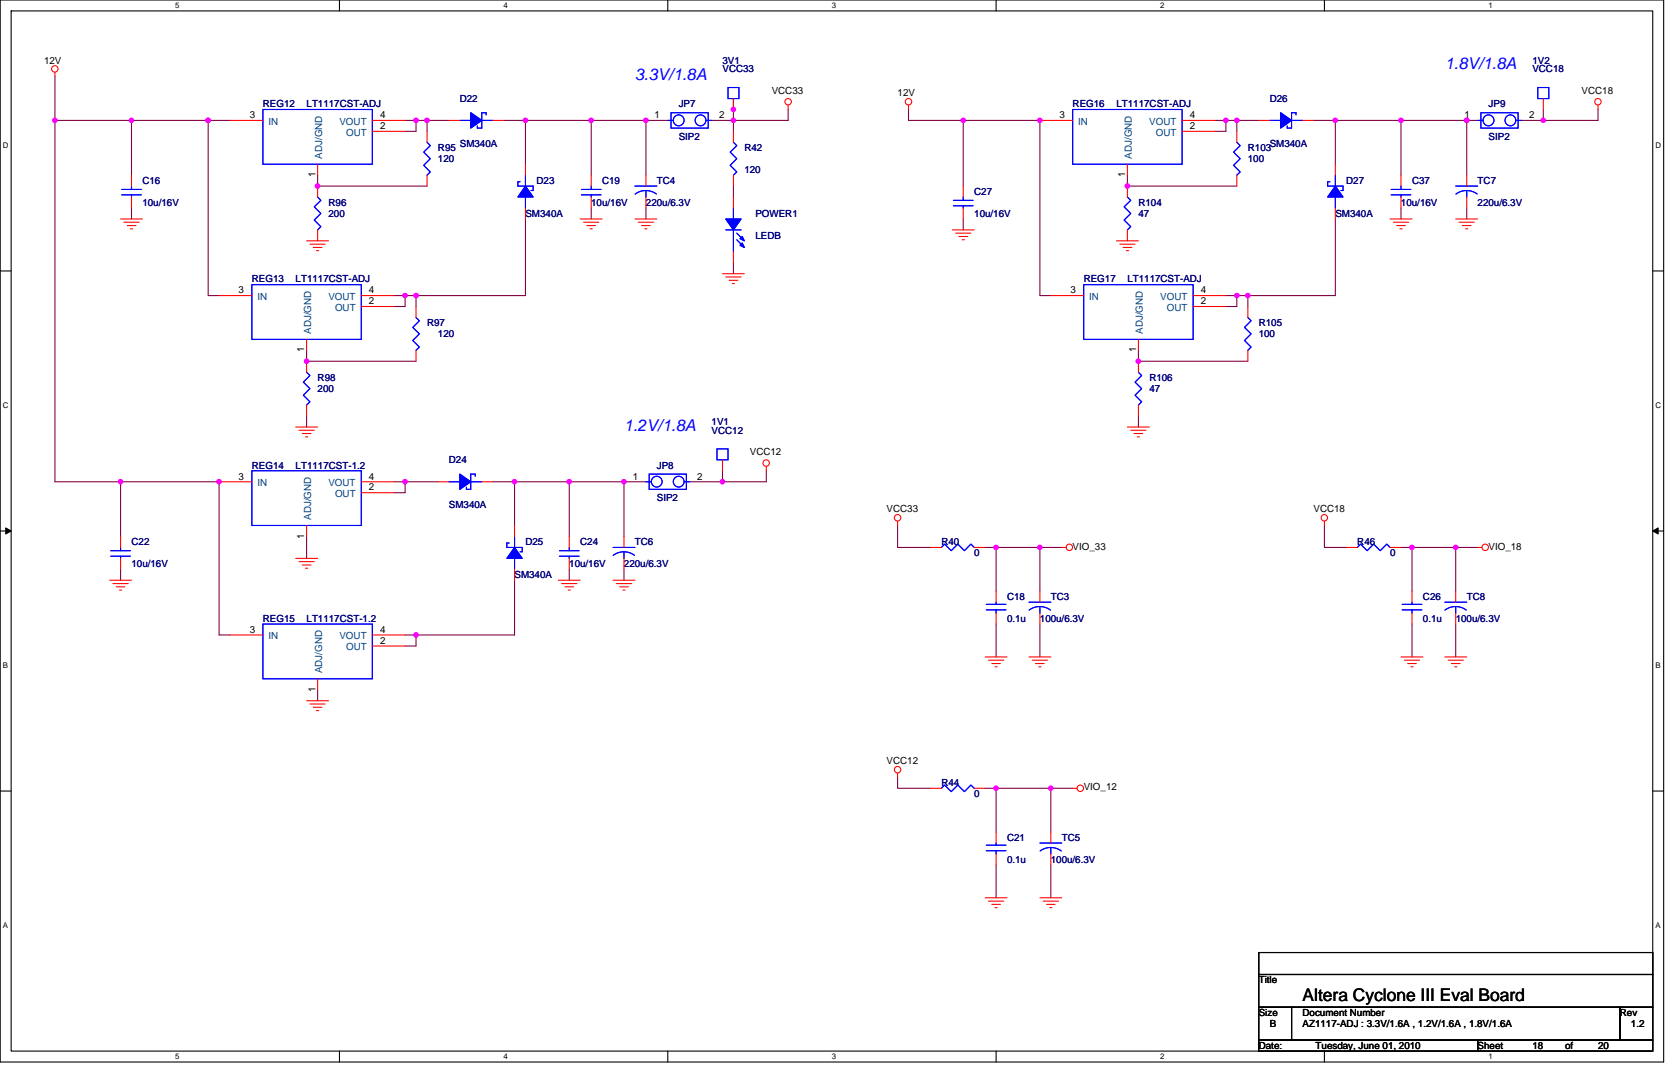
[picture p119: page 18]

Title
Altera Cyclone III Eval Board

Size Size Size B B B | Document Number Document Number Document Number AZ1117-ADJ : 3.3V/1.6A , 1.2V/1.6A , 1.8V/1.6A AZ1117-ADJ : 3.3V/1.6A , 1.2V/1.6A , 1.8V/1.6A AZ1117-ADJ : 3.3V/1.6A , 1.2V/1.6A , 1.8V/1.6A | Rev Rev Rev 1.2 1.2 1.2

Date: Date: Date: Tuesday, June 01, 2010 Tuesday, June 01, 2010 Tuesday, June 01, 2010 | Sheet Sheet Sheet 18 18 18 of of of 20 20 20

5V/1.8A

2.8V/1.8A

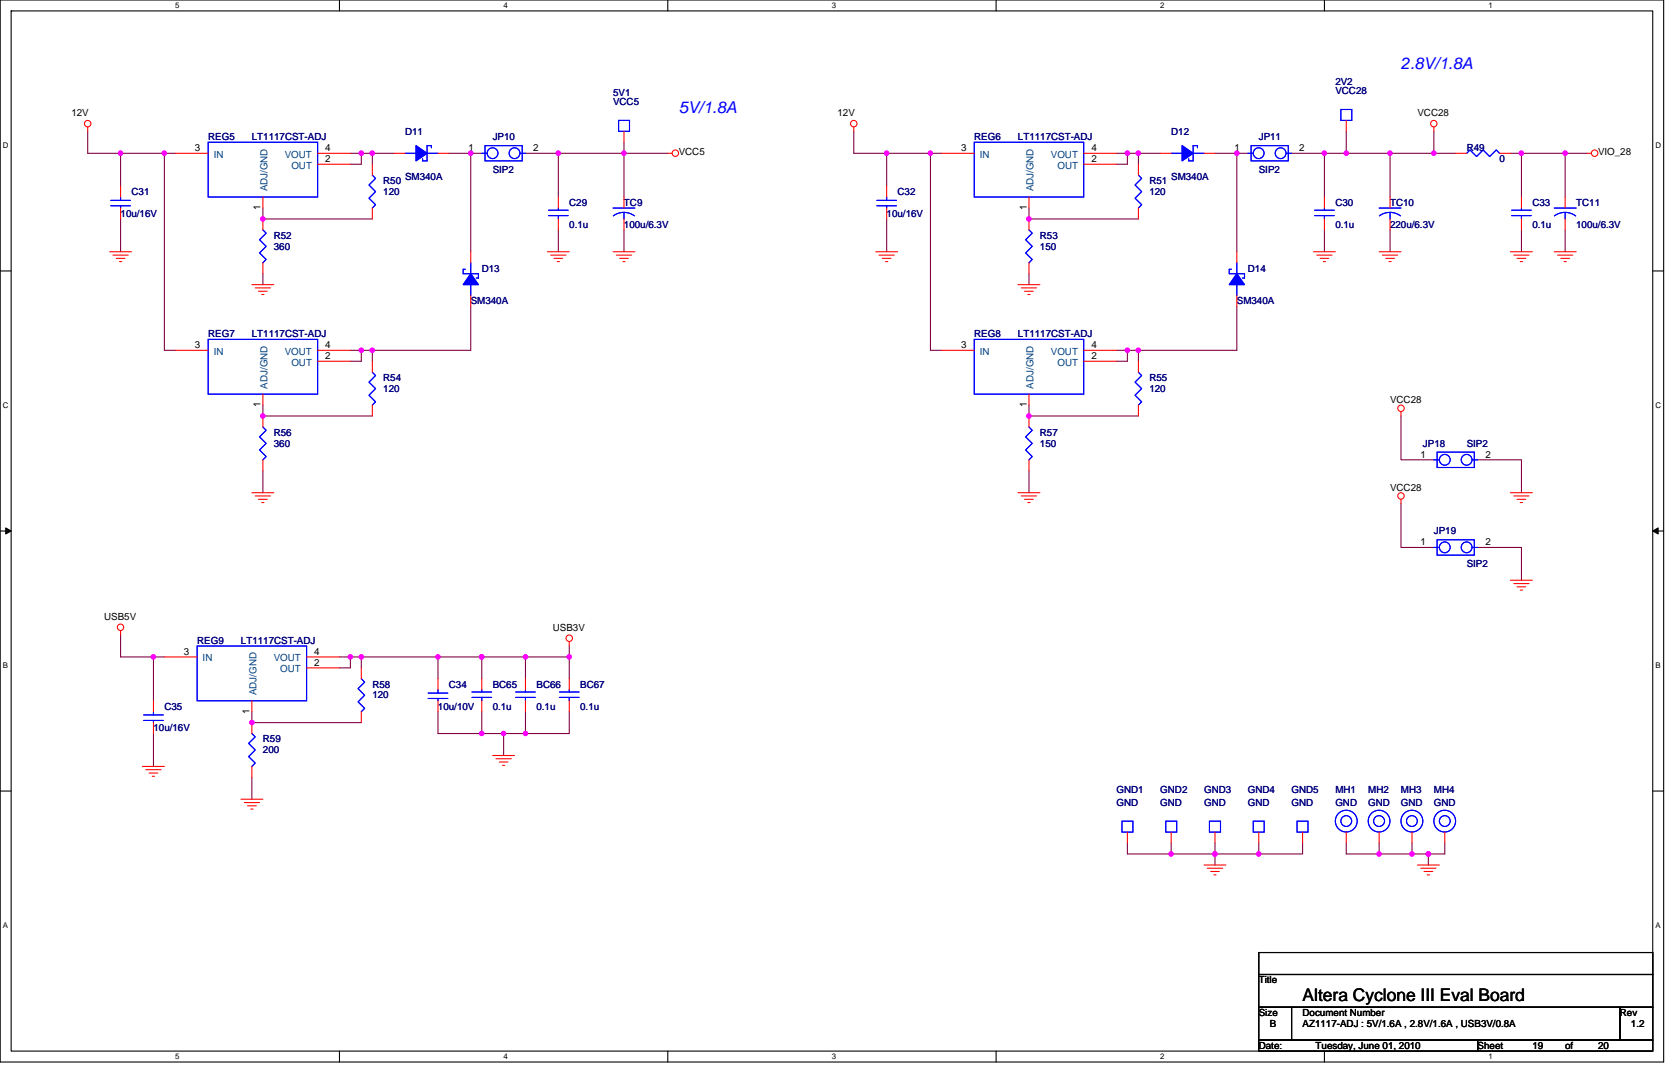
[picture p120: page 19]

Title
Altera Cyclone III Eval Board

Size Size Size B B B | Document Number Document Number Document Number AZ1117-ADJ : 5V/1.6A , 2.8V/1.6A , USB3V/0.8A AZ1117-ADJ : 5V/1.6A , 2.8V/1.6A , USB3V/0.8A AZ1117-ADJ : 5V/1.6A , 2.8V/1.6A , USB3V/0.8A | Rev Rev Rev 1.2 1.2 1.2

Date: Date: Date: Tuesday, June 01, 2010 Tuesday, June 01, 2010 Tuesday, June 01, 2010 | Sheet Sheet Sheet 19 19 19 of of of 20 20 20

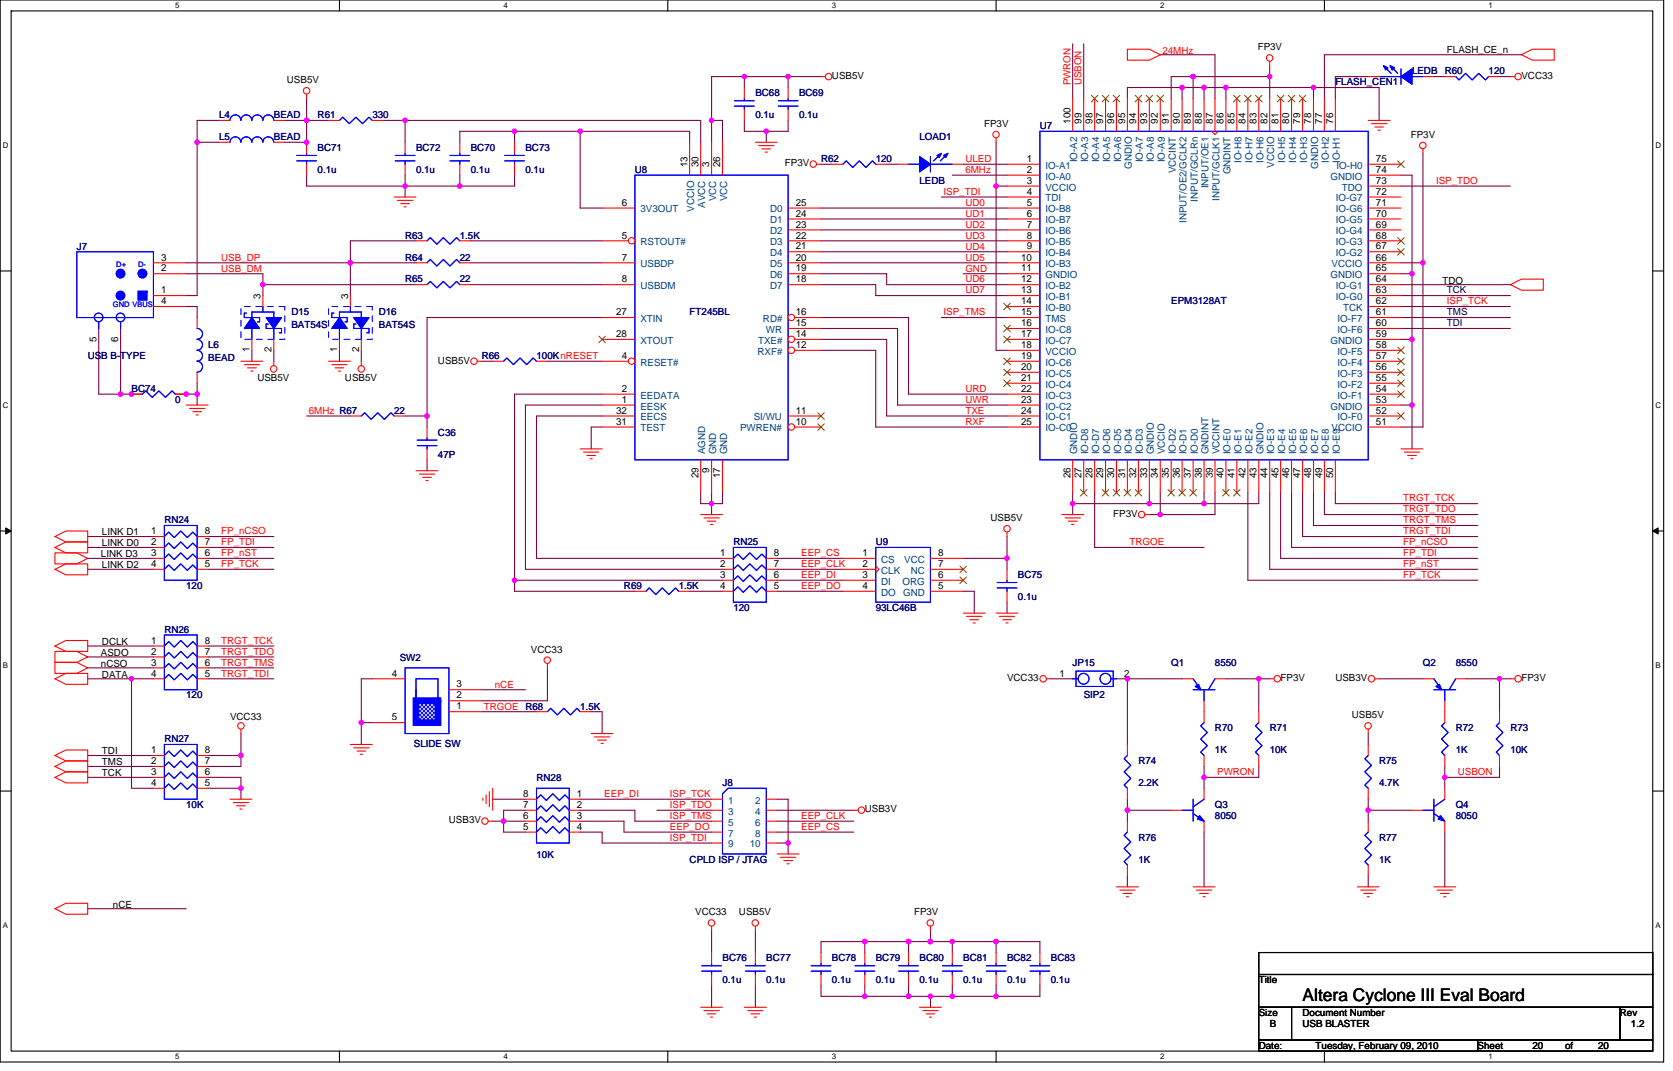
[picture p121: page 20]

GNDINT 86 INPUT/GCLK1 87 INPUT/OE1 88 INPUT/GCLRn 89 INPUT/OE2/GCLK2 90 VCCINT 91 IO-A0 2 IO-A1 1 IO-A2 100 TDI 4 GNDIO 74 GNDIO 95

VCCINT 39 IO-C0 25 IO-C1 24 IO-C2 23 IO-C3 22 IO-C4 21 IO-C5 20

7 | 2 ISP_TDO
5 | 4 | EEP_DO

Title
Altera Cyclone III Eval Board

Size Size Size B B B | Document Number Document Number Document Number USB BLASTER USB BLASTER USB BLASTER | Rev Rev Rev 1.2 1.2 1.2

Date: Date: Date: Tuesday, February 09, 2010 Tuesday, February 09, 2010 Tuesday, February 09, 2010 | Sheet Sheet Sheet 20 20 20 of of of 20 20 20
