wuyangtech/MIAT_C3X25/Examples/HW_SW_Integration/hscomm_lab2/software/rvmdk/hal_miatc3x_counter.c

#include "hal_miatc3x_counter.h"

void miatc3x_counter_enable(void)
{
    unsigned int* p;
    p = (unsigned int*)MIATC3X_COUNTER_BASE;
    *p = 0x00008000;    
}

void miatc3x_counter_disable(void)
{
    unsigned int* p;
    p = (unsigned int*)MIATC3X_COUNTER_BASE;
    *p = 0x00000000;
}

void miatc3x_counter_clear(void)
{
    unsigned int* p;
    int i;

    p = (unsigned int*)MIATC3X_COUNTER_BASE;
    
    *p = 0x00000001;
    for(i=0;i<10;i++);
    *p = 0x00000000;
}

unsigned int miatc3x_counter_get(void)
{
    unsigned int* p;
    p = (unsigned int*)MIATC3X_COUNTER_BASE;
    
    return *(p+1);
        
}
